mstahv/screwcloud/README.md

ScrewCloud

# ScrewCloud

**OSS web app to monitor temperature sensors like Ruuvi Tags and other custom sensors.**

A screw driven into a cloud: self-hosted temperature monitoring where the
readings go to your own server rather than into somebody else's cloud.

## What you can do with it

**The cheapest useful build is one board.** A Pico 2 W and a USB charger, with
nothing wired to it at all, reporting its own die temperature — which is exactly
what `pico-sleeper` exists to find out about. Add a RuuviTag and it becomes a
proper sensor; add a DHT22, an OLED, both or neither, and the same sketch covers
every combination, because the optional parts are detected at runtime rather than
configured.

**It goes where WiFi does not.** `temperature-reader` speaks WiFi *or* NB-IoT and
picks whichever answers at boot, so a reader can sit at a summer cottage, in a
garage or on a field with a 4G IoT SIM and no network of its own — sixteen bytes
every five minutes, which is what makes a metered connection affordable. Where
there is no cellular either, a node can shout over LoRa to a Raspberry Pi that
relays it onward.

**It does part of a Ruuvi Gateway's job, on your terms.** Hear the tags, forward
the readings — but the server is yours, the wire format is eight bytes of header
and eight per sensor and it is written down here, and everything between the tag
and the browser is in this repository under the AGPL.

**You change it in the Arduino IDE.** The firmwares are ordinary sketches: copy
`config.h.example`, edit three lines, press upload. No toolchain to install and no
build system to learn. The code is commented throughout for somebody who means to
alter it rather than admire it — including the parts that took two attempts, and
why the first one was wrong.

**You do not need a server to start.** A public one runs at `r.pakast.in` and the
sketches point at it out of the box, so the first reading arrives before you have
decided whether you like any of this. It is free, unauthenticated and offered
exactly as it is — see [Demo server](#demo-server) — and your own is a Spring Boot
jar and a PostgreSQL for when you want one.

## The pieces

Four readers, all speaking the same protocol to the same server:

- **`temperature-reader`** for the Raspberry Pi Pico 2 W — the full version:
  RuuviTags and Ruuvi Airs over BLE, an optional wired DHT22, an optional OLED,
  and WiFi or NB-IoT for connectivity.
- **`esp32-reader`** for the ESP32-S3 and the ESP32-C3 — the same Ruuvi side, RuuviTags and
  Ruuvi Airs over BLE, and WiFi; nothing wired to the board. It can be built and
  flashed from the server's firmware page without installing anything.
- **`pi-reader`** for a Raspberry Pi that is already there doing something else —
  the same job in Java, with a page of its own on the local network that keeps
  showing the temperature when the internet does not. It also reads a Nordic
  Thingy:52 and relays LoRa packets from nodes too far away for WiFi, so a device
  out of range still arrives at the server as itself.
- **`pico-sleeper`** — an experiment: a bare Pico 2 W reporting nothing but its
  own die temperature, asleep between readings. If the chip is cold enough to
  stand in for the room, the cheapest sensor in this repository has nothing wired
  to it at all.

The server is a Spring Boot + Vaadin application that stores the measurements and
shows them in a browser.

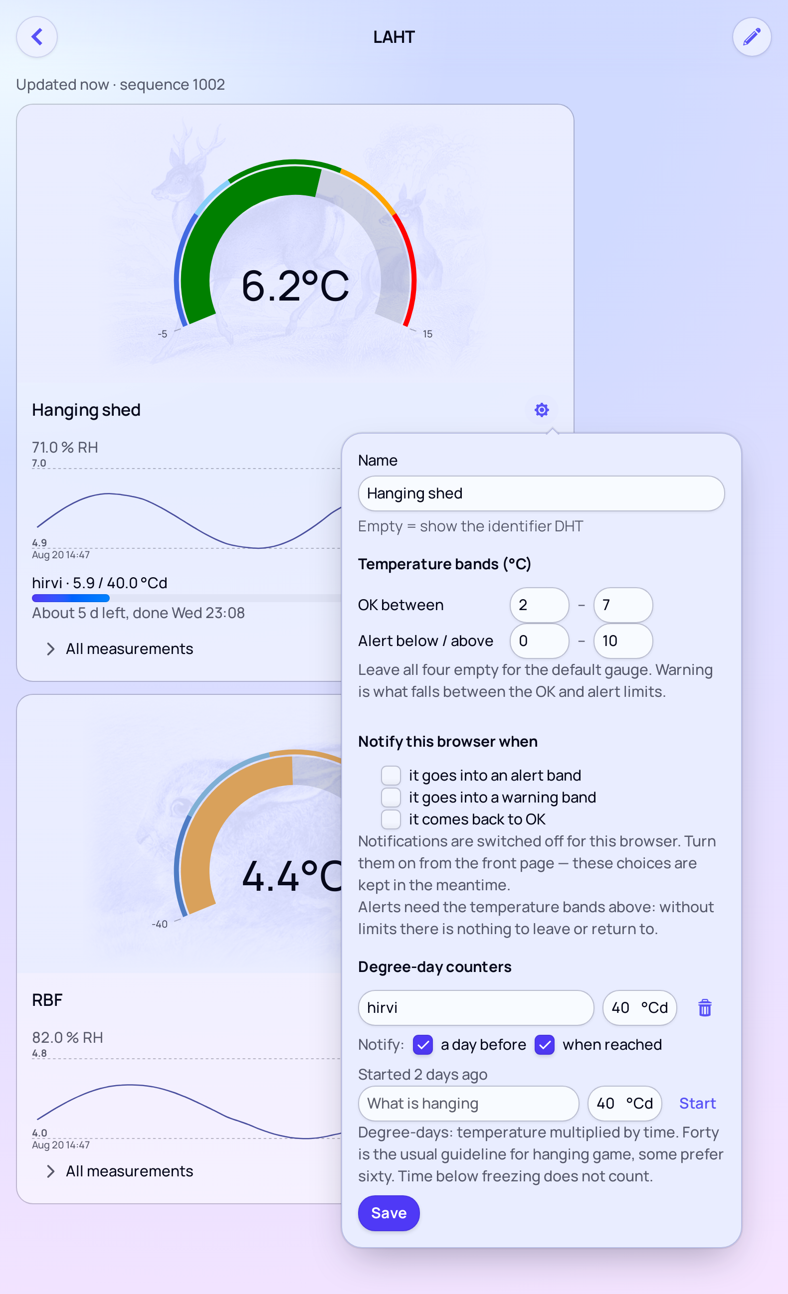
[picture p1: screenshot.png]
A device's sensor cards with one sensor's settings open, showing temperature bands on the gauge and a degree-day counter


Each sensor gets a card with a gauge, the last 24 hours as a curve, and under it
a small table of the readings the sensor has besides the temperature: the
humidity and pressure, a Ruuvi Air's CO₂, PM2.5, VOC and NOx indexes and light —
everything Ruuvi's own app lists for it — and a RuuviTag's battery, drawn as a battery,
with the bar as long as the charge and red under twenty per cent, beside the
voltage and a rough guess at what is left (see
[The battery guess](#the-battery-guess)). Each row ends in a small chart icon
that lays that reading over the temperature curve in its own colour — stretched
to the temperature's scale, so the shape shows and the numbers stay in the
table. Every reading is behind a
collapsed section further down. The settings open from the cog: a name,
temperature bands that colour the gauge, which of that sensor's alerts this browser
wants as push notifications, and the degree-day counters — the one above reads
`hirvi · 11.0 / 40.0 °Cd` with the forecast underneath.

**On an iPhone**, notifications need the site added to the Home Screen first, and
Apple has hidden that well. There is an illustrated walk-through of the whole
path, from Safari to a phone that buzzes before the meat is over-hung:
[Getting a notification on an iPhone](docs/iphone-notifications.md). Android
users can skim it; the in-app half applies to them as it stands.

## Quick start (Pico 2 W)

Minimum hardware: a **Raspberry Pi Pico 2 W** and a **RuuviTag**. No DHT22, no
display, no NB-IoT modem — those are all optional and detected at runtime.

For an ESP32-S3 or ESP32-C3 instead, see [esp32-reader](#esp32-reader).

1. **Install the Arduino core.** Boards Manager → *Raspberry Pi Pico/RP2040/RP2350*
   by Earle Philhower. Select the board *Raspberry Pi Pico 2 W*.

2. **Set Tools → IP/Bluetooth Stack → `IPv4 + Bluetooth`.** Mandatory: BLE is
   needed to hear the RuuviTag and WiFi to send. Without it the sketch will not
   even compile.

3. **Install the libraries** from Library Manager. Only the DHT ones can be
   skipped, and only if you comment out `ENABLE_DHT22`:

   | Library | Needed for |
   |---|---|
   | `Adafruit SH110X` + `Adafruit GFX Library` | the optional OLED |
   | `DHT sensor library` + `Adafruit Unified Sensor` | the optional DHT22 |

4. **Create your configuration** from the template and edit the copy:

   ```bash
   cd temperature-reader
   cp config.h.example config.h
   ```

   `config.h` is git-ignored because it holds your WiFi password. For the
   minimum setup only three lines need changing:

   ```c
   static const char DEVICE_ID[5] = "ABCD";        // any 4 characters, your own
   static const char WIFI_SSID[] = "your-network";
   static const char WIFI_PASSWORD[] = "your-password";
   ```

   Leave `SERVER_HOST` alone to use the public demo server.

5. **Flash it and open the serial monitor** at 115200 baud. Within a minute you
   should see something like:

   ```
   No NB-IoT modem found, falling back to WiFi
   Transport: WiFi
   DHT22: not connected
   RuuviTag cold room / F3:19:1A:C0:8E:BF  RSSI -41 dBm  (280 ms ago)
   Send ok: 1 sensors, 16 bytes, sequence 1
   ```

6. **Open the server**, enter your `DEVICE_ID` and press Add. The first packet
   arrives 30 s after boot, then every 5 minutes.

The onboard LED tells you the state from across the room: two short flashes and
a long pause means the last send succeeded, fast steady pulsing means it failed.

Setting one up for somebody who does not want any of this on their computer is a
different job, and a short one: see
[Handing a built firmware to somebody else](#handing-a-built-firmware-to-somebody-else).

### Demo server

The default `SERVER_HOST` points at the public demo server **r.pakast.in**
(77.42.75.251, UDP 5555). You are welcome to use it for trying things out.

**It comes with no guarantees.** It may be down, and the database may be wiped
at any time without warning. There is no authentication either: anyone who knows
your `DEVICE_ID` can see your readings, and anyone can send readings claiming to
be your device. For anything you care about, run your own server — a Spring Boot
jar and a PostgreSQL, see [Server](#server).

### What is optional and how

| Part | Behaviour when absent |
|---|---|
| DHT22 | Detected at runtime. After `DHT_FAILURES_BEFORE_ABSENT` failed reads it is declared absent, stops being read, and is left out of the display and the packet. Its display row goes to the tags instead. |
| OLED display | Nothing to detect — 4-wire SPI has no read-back, so the sketch cannot tell whether a display is attached and simply draws into the void. Nothing fails either way. |
| NB-IoT modem | Probed with an AT command at boot (`TRANSPORT_AUTO`). If it does not answer, WiFi is used. |
| RuuviTags | Any number from zero upwards. With no readings at all the sketch skips sending rather than transmitting an empty packet. |
| Chip temperature | Always available — it is on the die, there is nothing to detect or wire. Comment out `ENABLE_INTERNAL_TEMPERATURE` to leave it out of the packet. |

A sensor is only declared absent while it has **never** produced a reading. One
that has worked keeps being retried forever, because then the problem is
interference rather than absent hardware.

`TRANSPORT_AUTO` compiles both transports in and costs a couple of seconds of
boot time when no modem is present. `TRANSPORT_WIFI` or `TRANSPORT_NBIOT` fix
the choice and avoid both.

## Repository layout

| Directory | Description |
|---|---|
| `temperature-reader/` | Full firmware for the Raspberry Pi Pico 2 W: RuuviTags, DHT22, OLED, WiFi or NB-IoT |
| `esp32-reader/` | Firmware for the ESP32-S3 and ESP32-C3: RuuviTags, Ruuvi Airs and WiFi, nothing wired to the board |
| [`pi-reader/`](pi-reader/) | The same reader in Java on a Raspberry Pi: Quarkus, Vaadin, BlueZ — RuuviTags and a Nordic Thingy:52, plus a local page for when the server is unreachable and a LoRa relay for nodes out of WiFi range |
| `pico-sleeper/` | An experiment: a bare Pico 2 W sending only its own die temperature, asleep in between, over WiFi or LoRa |
| `lora-node/` | A Pico with a Core1121, transmitting so the LoRa receiver at the other end can be tested |
| `server/` | Spring Boot + Vaadin: receives the UDP packets and shows the latest readings |
| `tools/` | `generate-vapid-keys.java`, which generates a key pair for web push |

All of them speak the same protocol to the same server, so one server can collect
from a mix of Pico, ESP32 and Pi devices. Keeping three implementations of
one wire format honest is what `ProtocolSyncTest` is for — there is one in the
server, comparing the two sketches against each other, and one in `pi-reader`,
comparing its constants against the firmware header.

## Hardware

| Part | Required | Role |
|---|---|---|
| Raspberry Pi Pico 2 W(H) (RP2350 + CYW43439) | **yes** | The main board. WH = pre-soldered headers |
| RuuviTag (0..n) | no | Temperature, humidity, air pressure, wirelessly as BLE advertisements |
| Waveshare DHT22 (AM2302) module | no | Temperature + humidity, wired. Detected at runtime |
| Waveshare 1.3" OLED (B) | no | SH1106, 128×64. Readings legible on the spot |
| Waveshare SIM7028 NB-IoT HAT | no | Connectivity without WiFi. Detected at runtime |
| RP2350 internal sensor | — | The chip's own die temperature, reported as sensor `CPU`. Measures the chip heating up rather than the room |

The minimum setup is a bare Pico 2 W and one RuuviTag; see
[Quick start](#quick-start-pico-2-w).

Alternatively an **ESP32-S3** or **ESP32-C3** board (developed against the
Waveshare ESP32-S3-Zero and ESP32-C3-Zero) with the `esp32-reader` firmware.
That variant hears the same Ruuvi devices and sends over WiFi, and has nothing
wired to it — see [esp32-reader](#esp32-reader). The C3 is the cheaper of the
two and does the same job.

## Wiring

### DHT22

The module used here is the Waveshare DHT22, which comes with a three-wire
cable. **No separate pull-up resistor is needed** — the module already carries a
pull-up on the DATA line plus a decoupling capacitor. A bare 4-pin DHT22
component would need a 10 kΩ resistor between DATA and VCC.

The module runs on 3.3–5.5 V. Feed it from 3.3 V, because the Pico's GPIOs
**do not tolerate 5 V** — with a 3V3 supply the data line is directly compatible
and no level shifter is needed.

| Wire colour | Module pin | Pico 2 W | Physical pin |
|---|---|---|---|
| Red | VCC | 3V3(OUT) | 36 |
| Yellow | DOUT / DATA | GP15 | 20 |
| Black | GND | GND | 18 |

Check the colours against the module's silkscreen before wiring — the cable
order can vary between batches, and swapping red and black destroys the sensor.

GND is taken from physical pin 18, next to GP15. Pin 38 works equally well if it
suits being next to 3V3 (pin 36) better.

### OLED display

[Waveshare 1.3inch OLED (B)](https://www.waveshare.com/wiki/1.3inch_OLED_(B)),
controller SH1106, 128×64 pixels.

**The module ships in 4-wire SPI mode and is used as is.** The same module can
do I2C, but that would require resoldering the BS0/BS1 resistors on the back
(I2C: BS0=0, BS1=1). Not worth it — SPI is faster and takes nothing needed.

DIN and CLK go to the SPI0 default pins, so the `SPI` object works without any
pin configuration. CS, DC and RST are freely choosable and were taken from
adjacent pins so the whole display connects to one contiguous cluster (physical
pins 22–27).

| OLED | Function | Pico 2 W | Physical pin |
|---|---|---|---|
| VCC | Supply (3.3 V / 5 V) | 3V3(OUT) | 36 |
| GND | Ground | GND | 23 |
| NC | Not connected | – | – |
| DIN | SPI MOSI | GP19 | 25 |
| CLK | SPI SCK | GP18 | 24 |
| CS | Chip select | GP17 | 22 |
| DC | Data/Command | GP20 | 26 |
| RST | Reset | GP21 | 27 |

#### VCC is 3.3 V — not VBUS

Waveshare lists the spec as "3.3V/5V", but **the module's own schematic
contradicts that.** There is no regulator and no level shifter on the board: the
components are just the panel, six capacitors, a 1 MΩ IREF resistor, a 0 Ω
bridge and the headers. The schematic's VCC net goes straight to the panel's
supply pins.

The SH1106's absolute maximum ratings are VDD1 (logic) −0.3…+3.6 V and VDD2
(DC-DC) −0.3…+4.3 V. VBUS's 5 V would exceed both. On top of that VIH is
0.8 × VDD1, so with a 5 V supply the threshold would be 4.0 V and the Pico's
3.3 V would not register as a logic one.

Exception: if your board happens to have an LDO in a SOT-23 package (typically
marked `662K`) near the VCC pin, it is a different revision and 5 V is fine.
Check visually before cutting that corner.

The display and the DHT22 share the same 3V3 output (pin 36) through a
breadboard power rail. Current is not a constraint: the OLED draws about 20 mA
and the DHT22 1.5 mA.

The display deliberately shows only the room's temperatures and humidities. The
chip's own temperature and the diagnostics (RSSI, battery voltage, error counters)
go to the serial console — and in the chip's case to the server as well, where it
can be followed over time. There are three rows, and none of them should go to a
number that says nothing about the room.

#### The chip's own temperature

The RP2350 has a temperature sensor on the die, read with `analogReadTemp()`. It
is reported to the server as sensor **`CPU`**, and shown in the device's status
line — `Updated 4 min ago · sequence 2 · CPU 42.7 °C` — rather than on a card.

A card gave it the standing of a measuring point somebody chose: a heading, a 24
hour sparkline, threshold settings and alert subscriptions, none of which anyone
wants for a chip. The status line is where the rest of the device's own state
already is. Every reading is still stored, so the history is there if it is ever
wanted.

A device that overrides `INTERNAL_SENSOR_ID` gets an ordinary card again. The
packet carries nothing that distinguishes the chip from a thermometer, so the
identifier is all there is to go on.

**Unless it is all the device has.** A board that measures nothing but its own die
— see [pico-sleeper](#pico-sleeper) — gets an ordinary card for it, counts as one
sensor rather than none, and does not have the same number repeated on the status
line above it. Hiding it there would leave a status line and an empty page.

**It is not a room thermometer.** The sensor sits on the same silicon as the CPU
and the radio, so it reads well above the air around it — typically 10–20 °C
above, more when the modem is transmitting — and it moves with the load rather
than with the weather. What it is good for is the shape of the curve: how much the
chip heats up under load, and how well the enclosure sheds it.

It carries no humidity, which the UI shows as a dash rather than 0 %.

Costs 8 bytes per packet. Comment out `ENABLE_INTERNAL_TEMPERATURE` in `config.h`
to leave it out, and `INTERNAL_SENSOR_ID` renames it if `CPU` is not what you
want to see. It cannot collide with a tag: a tag's identifier is always `R` and
three hex digits.

### Why GP15

- GP23, GP24, GP25 and GP29 are used internally by the CYW43 wireless chip and
  are not on the header at all — they cannot be used
- GP4/GP5 (I2C0) and GP0/GP1 (UART0) are left free for future additions. I2C0 is
  reserved for something like a TMP117 reference sensor (see below)
- GP26, GP27 and GP28 are the only ADC pins, so they are not wasted on digital
  use
- GP15 has no default peripheral function, and physical pin 18 next to it is GND

## Software

### Arduino IDE settings

| Setting | Value |
|---|---|
| Board | Raspberry Pi Pico 2 W (arduino-pico, Earle Philhower) |
| **Tools → IP/Bluetooth Stack** | **IPv4 + Bluetooth** |

The IP/Bluetooth Stack choice is mandatory — with the default value the BTstack
library is not found and compilation fails. The same choice keeps WiFi available
for reporting; the CYW43 chip handles both radios.

### Libraries

| Library | From |
|---|---|
| `BTstackLib` | Comes with the arduino-pico core, no separate install |
| `DHT sensor library` | Adafruit, Library Manager |
| `Adafruit Unified Sensor` | Adafruit, dependency of the above |
| `Adafruit SH110X` | Adafruit, Library Manager. SH1106 controller |
| `Adafruit GFX Library` | Adafruit, dependency of the above |

### Configuration

`temperature-reader/config.h` is **git-ignored** because it holds the WiFi
password. `config.h.example` is the tracked template; copy it and edit the copy:

```bash
cp temperature-reader/config.h.example temperature-reader/config.h
```

Keep placeholders in the template and real values only in your own copy. If
`config.h` was tracked at some earlier point, untrack it with
`git rm --cached temperature-reader/config.h`.

### Handing a built firmware to somebody else

A Pico takes firmware by drag and drop. Hold its **BOOTSEL** button while
plugging in the USB cable and it appears as an ordinary USB drive; copy a `.uf2`
file onto that drive and it flashes itself and restarts. No IDE, no drivers, no
command line, nothing installed. So the person receiving a device never needs a
toolchain — they need one file and two sentences.

An ESP32 has no such drive; it takes firmware over its serial port. The
server's [firmware build page](#the-firmware-build-page) does that from the
browser, which is the way to hand one over. By hand it is the merged image the
`arduino-cli` compile below leaves as `*.merged.bin`, written with
`esptool.py --chip esp32s3 write_flash 0x0 <file>` — or `--chip esp32c3` for
that board.

What they do not get is a way to type in their own WiFi password. The settings
are compiled in, which means **one build per recipient**. Why that is, and what
it would take to change, is at the end of this section.

#### Building the file

Edit `config.h` first, and change two things, not one:

| | |
|---|---|
| `WIFI_SSID`, `WIFI_PASSWORD` | the recipient's network |
| `DEVICE_ID` | **must be unique.** Four characters, and it is what the server files the readings under — two devices sharing one id file as one device and overwrite each other's history |

Then, in the Arduino IDE, with the board settings from above: **Sketch → Export
Compiled Binary**. The `.uf2` lands in a `build/` folder beside the sketch.

Or from the command line, which is easier to repeat for a second recipient:

```bash
# once, if arduino-cli has never seen this core
arduino-cli core install rp2040:rp2040 \
  --additional-urls https://github.com/earlephilhower/arduino-pico/releases/download/global/package_rp2040_index.json
arduino-cli lib install "DHT sensor library" "Adafruit Unified Sensor" \
  "Adafruit SH110X" "Adafruit GFX Library"

# per build
arduino-cli compile \
  --fqbn rp2040:rp2040:rpipico2w:ipbtstack=ipv4btcble \
  --export-binaries \
  temperature-reader
```

`ipbtstack=ipv4btcble` is the command-line spelling of **Tools → IP/Bluetooth
Stack → IPv4 + Bluetooth**, and it is not optional: without it BTstack is not
found and the compile fails. If that string ever stops matching, ask the core
itself rather than guessing:

```bash
arduino-cli board details --fqbn rp2040:rp2040:rpipico2w
```

The compile prints the path of the `.uf2` it wrote when it finishes. That single
file is what you send. It is a few hundred kilobytes and goes through email.

> **It contains their WiFi password in clear text**, because it contains
> `config.h`. That is their own secret going back to them, so it is not a
> disaster, but it does mean a build belongs to one recipient and must not be
> forwarded to the next one — who would also inherit the wrong `DEVICE_ID`.

#### What to send with it

Everything below is written to be pasted into a message as it stands.

> 1. Take the USB cable out of the device, if it is plugged in.
> 2. Find the single small button on the Pico board — the one marked
>    **BOOTSEL**. Press and hold it.
> 3. While still holding it, plug the USB cable into your computer.
> 4. Let go of the button. A drive called **RP2350** appears, like a memory
>    stick.
> 5. Copy the file I sent you onto that drive.
> 6. The drive disappears by itself after a second or two and the device starts
>    up. On a Mac you may get a warning that a disk was not ejected properly —
>    that is normal here, and nothing is wrong.
>
> The display comes on right away. The bottom row says `Not sent yet` at first,
> and should change to `Sent ok` within a minute or so.

#### When it does not work

| What happens | What it means |
|---|---|
| No drive appears | The button was not held, or was let go too early. Unplug and start again. A charge-only USB cable also does this — try another cable |
| The drive appears but stays after copying | The file was built for the wrong chip. `RP2350` is a Pico 2; a plain Pico wants a different build |
| Drive appears, display stays dark | The firmware is fine and something else is wrong — see the link status codes |

#### Why the settings are not in a separate file

The obvious idea is one binary for everyone plus a small text file the recipient
edits — same drive, same drag and drop. It does not work, for a specific reason
worth recording so nobody spends an evening rediscovering it.

The drive a Pico shows in BOOTSEL mode is the bootloader's, and it only accepts
`.uf2` images; it is not a filesystem you can put a text file on. A running
sketch can present a drive of its own through the core's
[SingleFileDrive](https://arduino-pico.readthedocs.io/en/latest/singlefile.html)
library, but its documentation is explicit that the emulation "only allows for
the reading of the single file, and deleting it" — the PC cannot write to it.
It is a way to get a log file *out*, not a way to get settings *in*.

Shipping a prepared LittleFS image alongside the sketch would work technically
and gains nothing: the image would still have to be built per recipient, which
is the very work it was meant to avoid.

The real answer, when it is worth the effort, is provisioning over WiFi: the
device brings up its own access point when it has no credentials, the recipient
connects a phone to it and types their network and password into a small web
page, and it is written to LittleFS and used from then on. The hardware is
willing — the Pico 2 W does AP mode, and this device has a display to put the
network name and the progress on. It is a project rather than an afternoon,
which is why the firmware currently compiles the settings in.

## temperature-reader

Prints the readings from every source to the serial console every 5 seconds
(115200 baud) and refreshes the OLED at the same time.

### Link status indication

The result of the most recent send is visible on both the LED and the display.
Both read the same `LinkState` structure, so they cannot tell different stories.

| State | LED rhythm | Display bottom row |
|---|---|---|
| Send succeeded | two short flashes, long dark pause | `Sent ok, 45 s` |
| Send failed, has worked before | fast steady pulsing | `NO NET s2 q99 12 min` |
| Send failed, never worked | fast steady pulsing | `NO SIM up 12 min` |
| Nothing sent yet | calm steady blinking | `Not sent yet` |

The rhythms were chosen to be told apart at a glance without counting durations.

On failure the row is the reason and then an age. The reason comes first because
it is what decides what to do about it; the codes are listed under [When a send
fails](#when-a-send-fails). The age is two different measurements depending on
what there is to measure: after a link that once worked it is the time since the
last **successful** send, which says more than the time of the failed attempt,
and with nothing to count from it is the time since boot, marked `up` so the two
are not mistaken for each other.

The row holds 21 characters and the buffer it is composed in is exactly that
size, so a long reason keeps its front and loses its tail rather than wrapping
onto a line that would be drawn off the bottom edge.

Even a failing `transport->begin()` is flagged as an error, so for instance a
wrong WiFi password shows up right at boot rather than only after the first send
attempt.

### Display layout

The display is meant to be read from across the room, so the font is as large as
possible. Three rows:

```
cold room     24.9
R2            -3.2
DHT           25.6
Sent ok, 45 s
```

The Adafruit_GFX font is 6×8 px at text size 1, so size 2 is 12×16 px. Only
**10 characters** fit per row in the large font, which is not enough for a name
and a reading at once — so the temperature is drawn at size 2, right aligned,
and the name at size 1 on the left, vertically centred against it. The
temperature is the number you look at from across a room; a name is something
you walk up to and read.

The row height is 20 px, so three rows take 60 pixels and the bottom 8 pixels
are left for the link status row in the small font.

The name gets whatever the reading leaves, measured against the reading actually
being drawn rather than a fixed column — `24.9` leaves room for 14 characters
and `-12.3` for 10. A longer name is truncated, because a name running into the
reading is worse than a name that stops early.

Humidity is not on the display. Three numbers per row was more than a 128 pixel
display could show legibly, and humidity is the one nobody squints at from the
doorway — it is on the dashboard, along with pressure and battery voltage.
A temperature a sensor does not provide shows as dashes.

There are three rows and there can be more sensors than that, so the order
decides who is left out: **tags that are still reporting first, then the DHT22,
and tags that have gone quiet last of all.** The tags are the measuring points
somebody deliberately placed; the DHT22 is wherever the box happens to sit. And
a tag that stopped sending an hour ago must never push a still-reporting sensor
off the screen, which is why it sorts below even the DHT22 — its reading is
worth showing, but only with the space left over.

Nothing is lost by not being drawn: the registry keeps every tag it has heard,
the packet carries them all, and the serial console prints them all.

### RuuviTag

RuuviTag's [Data Format 5 (RAWv2)](https://docs.ruuvi.com/communication/bluetooth-advertisements/data-format-5-rawv2)
is a broadcast format: the entire measurement payload sits in the
manufacturer-specific field of the BLE advertisement (AD type `0xFF`, company ID
`0x0499`). No connection is needed, scanning is enough.

The payload is 24 bytes big endian: temperature `int16 × 0.005 °C`, humidity
`uint16 × 0.0025 %`, air pressure `uint16 + 50000 Pa`, three acceleration axes,
an 11+5 bit battery voltage / TX power field, a movement counter, a sequence
number and the MAC. Every field has its own "invalid" value, which the code
turns into `NaN`.

The scan parameters are set by hand:

```cpp
gap_set_scan_params(0 /* passive */, 0x0030, 0x0030, 0);
```

BTstack defaults to a 30 ms window every 300 ms, a 10 % duty cycle. Since a
RuuviTag in RAWv2 mode only transmits every ~1285 ms, the defaults would miss
most advertisements.

#### Several tags

`RuuviRegistry` tracks every tag heard, keyed by the MAC address inside the
advertisement. The array is fixed size (`MAX_RUUVI_TAGS`, default 8), because
dynamic allocation in a long-running sketch is a needless risk. If there are
more tags than slots the extras are ignored and that shows up as a counter in
the output — no silent data loss.

A tag's reading is marked `[STALE]` in the output if nothing has been heard from
it for a minute (`RUUVI_STALE_MS`). A tag transmits every ~1285 ms, so anything
older effectively means the tag is out of range or its battery is dead.

Tags can be named in the `RUUVI_NAMES` table so measuring points are
distinguishable on the display and in the log. A name is a display matter only
and goes nowhere near the server, so it can be changed at will — see
[Identifiers](#identifiers) below. Naming is optional: an unnamed tag is shown
as `R1`, `R2`, … numbered in the order the device first heard them, and by its
MAC address on the serial console. A new tag's MAC comes straight from the
serial output.

The running number belongs to the tag's slot in the registry, not to its row on
the screen, so `R2` stays `R2` when the tag above it goes quiet and drops down
the display. It can change across a reboot, if the tags are heard in a different
order — the proper name for a measuring point lives in the web interface, which
is keyed by the identifier below and unaffected.

#### On accuracy

The BME280 in a basic RuuviTag is ±1.0 °C on temperature. If some measuring
point needs accuracy, the **RuuviTag Pro** uses TI's TMP117, whose absolute
accuracy is ±0.1 °C between −20 and +50 °C. The Pro sends the same Data Format
5, so no code changes are needed — the 2in1 model's missing humidity and
pressure fields arrive as `0xFFFF` invalid values, which the parser turns into
`NaN`.

### The Arduino IDE's prototype generation

The Arduino IDE generates prototypes for the functions in a `.ino` file
automatically and places them after the `#include` lines — that is, **before**
the sketch's own type definitions. A file scope function taking a
sketch-declared type as a parameter therefore fails with:

```
error: 'RuuviMeasurement' has not been declared
```

The error points at the function definition line even though the fault is in the
generated prototype. The workaround: make it a **member function** — those get
no generated prototype. That is why the Data Format 5 parser is
`RuuviMeasurement::parseFormat5` rather than a free function.

The same applies to future additions: if you need a free function handling the
`RuuviMeasurement` or `DhtSensor` type, move the types into their own `.h` file
or make the function a member.

### Timing notes

`loop()` is deliberately non-blocking. `BTstack.loop()` has to run often, so
timing is done with `millis()` comparisons rather than `delay()`.

Adafruit's DHT library bit-bangs the protocol and keeps interrupts disabled for a
couple of milliseconds per read. The sensor is therefore only read when printing.
If read failures (the `failures` counter) start piling up, the DHT read can be
moved to the other core with `setup1()`/`loop1()` — disabling interrupts is
per-core on the RP2350, so core 0's BTstack is then undisturbed.

## esp32-reader

The Pico firmware with the hardware taken out: **RuuviTags and Ruuvi Airs over
BLE, the chip's own temperature, and WiFi.** No DHT22, no display, no NB-IoT —
and no way to add them, on purpose. Everything that is not about wiring is the
same as on the Pico: the wire format, the Ruuvi decoding, the identifier a tag
gets, the failure reasons, the restart after a link has been down for six sends
and the hardware watchdog behind that. Developed against the Waveshare
ESP32-S3-Zero and ESP32-C3-Zero.

One sketch for both chips. The S3 is a dual-core Xtensa and the C3 a single-core
RISC-V, and the sketch cannot tell: the Arduino core, NimBLE, WiFi, the watchdog
and the RGB LED call are the same on both. The one line that differs is the LED's
pin — GPIO21 on the S3-Zero, GPIO10 on the C3-Zero — and `config.h` picks it by
the target the compiler is building for, so there is one template rather than
two. The C3 is the cheaper board and does the same job.

The easiest way to get one is not to build it at all: the server's
[firmware build page](#the-firmware-build-page) compiles it for your network and
writes it onto the board from the browser. What follows is for doing it by hand.

### Quick start (ESP32-S3 or ESP32-C3)

1. **Install the ESP32 Arduino core** (3.x) from Boards Manager and select
   *ESP32S3 Dev Module* or *ESP32C3 Dev Module*, whichever you have. Set **USB
   CDC On Boot: Enabled** — the Zero boards have no separate USB-UART chip, and
   without this the serial monitor stays silent —
   and **Partition Scheme: Huge APP**, because BLE and WiFi together do not fit
   the default application partition with anything to spare.
2. **Install `NimBLE-Arduino`** (2.x) from Library Manager. Nothing else — WiFi,
   `neopixelWrite()` and `temperatureRead()` come with the core.
3. **Create your configuration:**
   ```bash
   cd esp32-reader
   cp config.h.example config.h
   ```
   Change `DEVICE_ID`, `WIFI_SSID` and `WIFI_PASSWORD`.
4. **Flash and open the serial monitor** at 115200 baud. Within a minute you
   should see the tags it hears, a line per device, and `Send ok`.

The RGB LED shows the state by colour, in the Pico's three rhythms: **green** two
short flashes = the last send succeeded, **red** fast pulsing = it failed,
**blue** slow blinking = nothing sent yet. On a failure the serial log says why
in the Pico's words — `NO WIFI`, `NO HOST`, `NO SEND` — so a reader who knows one
board knows the other.

A Ruuvi Air's CO₂ and PM2.5 travel to the server alongside its temperature and
humidity, exactly as from the Pico, and the chip temperature is sent as sensor
`CPU` unless `ENABLE_INTERNAL_TEMPERATURE` is commented out in `config.h`.

### Power, and why it works in cycles

The first version scanned for advertisements without pause, held its WiFi
association and ran the CPU at 240 MHz, and the board ran hot enough to notice.
None of that is needed by a device that reports every five minutes, so the
firmware now works in cycles:

| Phase | Radios | How long |
|---|---|---|
| listening | BLE scan on, WiFi off | `LISTEN_MS`, 20 s by default |
| send | scan stopped, WiFi up for the packet and then off | a few seconds |
| resting | both off | the rest of `SEND_INTERVAL_MS`, or `RETRY_INTERVAL_MS` after a failure |

A RuuviTag advertises every ~1.3 s, so twenty seconds hears every device in
range many times over, and at a five minute interval the receiver is on seven
per cent of the time instead of all of it. The CPU runs at 80 MHz, the minimum
the radios accept and more than the work needs. The light and the serial console
work throughout, because the chip stays awake — it only has less to do.

`SLEEP_BETWEEN_SENDS` in `config.h` goes further and puts the chip into deep
sleep between cycles, woken by a timer into a fresh boot. It is off by default
because two things stop working while the chip sleeps: the light is dark between
cycles, and the USB console drops and reconnects each time, which makes watching
the log a chore. Enable it once the device is proven and put away — on the
firmware build page it is the "Sleep between sends" box. Only the sequence
number is carried across, in RTC memory, so the server does not read every
wake as a reboot.

It is deep sleep rather than light sleep after light sleep was tried and the
device reported once and never again. Espressif's sleep documentation explains
it: light sleep powers the radios down, and a BLE controller that was simply
left initialised is not brought back usable — that only works on the modem-sleep
and automatic-light-sleep path, which the Arduino core does not set up. The scan
restarted into nothing and WiFi stayed down. A reboot per cycle costs about a
second and recovers everything.

The light's own cost is small — a couple of milliamps on average at this
brightness, against twenty-odd for the chip awake at 80 MHz — but it is there,
and `STATUS_LED_WHILE_RESTING` in `config.h` is where to give it up: set to 0,
the light blinks only while listening and around the send, and is dark for
the minutes in between when it would be telling an empty room. With light sleep
on it is dark between cycles regardless.

The first packet leaves about `LISTEN_MS` after power-on, which is what the
earlier `FIRST_SEND_DELAY_MS` used to arrange; that constant is gone from the
template, and an old `config.h` that still has it compiles with a warning.

### What is shared, and why by copy

`Protocol.h` is **byte identical** in both sketches, and the Ruuvi Data Format 5
constants and scaling factors match. `ProtocolSyncTest` in the server module
verifies both, so it runs with the normal test suite rather than waiting to be
remembered:

```bash
cd server && mvn test -Dtest=ProtocolSyncTest
```

It reads the two sketches straight from the firmware directories — the server
module reaching outside itself, on the grounds that the repository is checked out
as a whole. No Spring context, so it costs under a tenth of a second.

The checks compare the two sketches against **each other** rather than against
expected values written into the test, so changing the protocol in both firmwares
needs no edit there, and reformatting a line is not a divergence. A failure names
both values:

```
humidity scaling differs between the two firmwares
  ==> expected: <rawHumidity * 0.0025f> but was: <rawHumidity * 0.025f>

Protocol.h has diverged at line 32.
  pico: static const uint8_t PROTOCOL_SENSOR_SIZE = 8;
  esp32: static const uint8_t PROTOCOL_SENSOR_SIZE = 9;
```

Beyond the named checks, every `static const` and `#define` the two sketches
happen to share is compared as well, so a constant added to both is covered
without anyone remembering to list it.

It is a copy rather than a shared file because the Arduino build does not
reliably resolve includes reaching outside a sketch folder — arduino-cli copies
the sketch directory into its build path, so a `../shared/Protocol.h` include can
break depending on the toolchain version. A checked copy is more robust than an
include that might silently stop working.

Both copies have been compiled natively against a stub `Arduino.h` and produce
identical packet bytes, which in turn match what the server's `PacketDecoder`
expects.

The ESP32 variant decodes fewer Ruuvi fields on purpose — no pressure,
acceleration or battery voltage, since it does not report them.

### What differs from the Pico version, and why

| Concern | Pico 2 W | ESP32-S3 / ESP32-C3 |
|---|---|---|
| BLE | BTstack, run loop pumped from `loop()` | NimBLE, own host task |
| Advertisement data | `BLEAdvertisement` copies a fixed 31 bytes and hides the real length, so AD structures are walked by hand | NimBLE gives the manufacturer field with its real length |
| Scan units | raw 0.625 ms units into `gap_set_scan_params` | milliseconds into `setInterval` / `setWindow` |
| Status LED | plain GPIO, rhythm only | WS2812 RGB, colour plus rhythm |
| Internal temperature | `analogReadTemp()`, sent as sensor `CPU` | `temperatureRead()`, sent as sensor `CPU` |
| Watchdog | `rp2040.wdt_*`, fed from the transport's wait loops | `esp_task_wdt_*`, fed from the WiFi connect wait |
| Restart when stuck | `rp2040.reboot()`, held back by a SIM waiting for its PIN | `ESP.restart()`, held back only by a boot too young |
| Radios | BLE scanning and the transport up throughout | in cycles: scan for a window, WiFi for the send, both off between — see Power |
| Shared state | none needed | mutex — see below |

**The one real structural difference is concurrency.** On the Pico, BTstack
callbacks run inside `BTstack.loop()` on the main thread, so the tag registry
needed no locking. On the ESP32, NimBLE delivers `onResult` from its own host
task, so every registry access is under a mutex and `loop()` works on a snapshot
rather than the live array. Getting this wrong would produce rare torn reads that
are very hard to reproduce.

Two consequences of NimBLE that are easy to get wrong:

1. **`setScanCallbacks(callbacks, wantDuplicates)` must pass `true`.** It sets the
   duplicate filter, and with the filter on each tag is reported only once —
   readings would never update after the first advertisement.
2. **`setMaxResults(0)`** stops NimBLE accumulating a device list. We only care
   about the callbacks, and a continuous scanner would otherwise grow a result
   set forever.

A pleasant simplification: `transportIdle()` disappears entirely. The ESP32 has
no run loop of ours to pump during a network wait, so the whole "BLE must not
stall while connecting" problem does not exist. `loop()` just calls `delay()` to
yield to the WiFi and BLE tasks. What the wait loop still has to do is feed the
watchdog, which is armed at eight seconds and would otherwise fire during a
twenty-second connect — the same arrangement as the Pico's, with one call where
the Pico has a function.

The Arduino core may already have the task watchdog running with a timeout of its
own, and refuses a second `esp_task_wdt_init`. `startWatchdog()` reconfigures it
in that case rather than giving up, so the outcome is the same either way: our
timeout, watching our loop.

**Neither firmware has been compiled in this environment** — no Arduino
toolchain here. The shared protocol code has been verified natively; the
board-specific plumbing has not.

## pico-sleeper

An experiment with one question behind it: **is the RP2350's own die temperature
close enough to the air around it to be worth reading?** If it is, the cheapest
sensor here is a bare Pico 2 W with nothing wired to it.

The cycle, every fifteen minutes and once at boot:

```
wake -> measure -> radio on -> send -> radio off -> sleep
```

**The order is the experiment.** The die is coldest the moment it wakes, and
everything after the measurement heats it — connecting to WiFi takes seconds and
is by far the largest part of a wake. Measuring first is what makes the reading
about the room rather than about the work. Reading it after sending would produce
a number that says how hard the board has just been working, which is what the
chip temperature normally tells you and exactly what is not wanted here.

It sends one sensor called `CPU`, so the server shows it on the device's status
line rather than as a measuring point — and counts it as one sensor rather than
none, because on this device it is all there is.

### A packet that was "sent" and never arrived

`endPacket()` returning success means the datagram was handed to the network
stack, not that it has left the antenna. A first packet on a fresh connection
usually waits for an ARP reply before it can go anywhere — and this device
powers the radio down immediately afterwards, which throws the packet away
while it is still in the queue.

That is what "sent" in the serial log with nothing at the server looks like, and
it is why the radio now stays on for `WIFI_LINGER_MS` after the hand-over. UDP
offers no acknowledgement to wait for, so waiting a moment is the honest remedy;
it costs a fraction of the seconds the connection itself took.

### Sleep

Since **pico-sdk 2.3.0** the SDK carries a library for this — `pico_low_power`,
with official examples and, better, measured numbers. arduino-pico bundles that
SDK from 5.7.0 onwards, so it is available in an ordinary Arduino build. Raspberry
Pi's own figures for a Pico 2 running from 3V3:

| Mode | Current | Wakes on | Costs |
|---|---|---|---|
| `delay()` | — (every clock still running) | timer | nothing |
| sleep | 6.9 mA | timer or any interrupt | nothing: it returns where it was called |
| dormant | 3.7 mA | AON timer or a GPIO | the crystal stops, so USB and the serial log go with it |
| Pstate, SRAM0 on | 0.14 mA | AON timer or a GPIO | **the program restarts on waking** |
| Pstate, all SRAM off | 0.08 mA | AON timer or a GPIO | as above, and less retained |

This sketch uses **sleep**, the lightest of the three, because it is the only one
that leaves the program running: `low_power_sleep_for_ms()` returns where it was
called, so the loop stays the ordinary loop it looks like. It stops the processor
and most clocks, which is a long way below waiting in `delay()` — that halts the
core on a `WFE` but leaves every clock and PLL running.

Pstate is the real prize and suits this device better than it sounds: a wake here
is already "run once from the top". What it needs is the sequence number moved
into a POWMAN scratch register to survive the restart, and it takes the serial
connection with it — which is the instrument this experiment is being run with, so
it is a step to take once the questions about the temperature have been answered.

**One thing to know before the first build.** arduino-pico 6.0.0 ships the
compiled `pico_low_power` library, but its linker script does not define the two
symbols that library expects around a persistent data section — that section is
created by an SDK CMake function, and an Arduino build has no CMake. The link
fails with `undefined reference to __persistent_data_start__`. `Sleep.h` defines
them itself, one byte and an alias to it, which is the "no persistent data" case
the library already handles; the reasoning is written out there. Setting
`SLEEP_USE_SDK_LOW_POWER` to 0 backs out of the whole thing.

**One caveat before anyone plans a battery.** Those numbers are for a Pico 2, not
a Pico 2 **W**. The CYW43 radio is powered separately and does not appear in them
at all. On this board it may well be the largest consumer between readings, and if
it is, the difference between 6.9 mA and 0.14 mA of processor is not the
difference it looks like. That wants a meter, not an argument.

The sketch prints how long each wake took and which sleep it is using. A wake of a
few seconds every fifteen minutes is a duty cycle under one percent, and at that
point the current drawn while asleep is what the battery life is made of.

**And it prints the self-heating**: the die temperature is read again at the end
of each wake, and the difference from the reading that was sent says how much the
board warmed itself doing the work. That number is the instrument for the whole
experiment. The first measurement of it was **+2.87 °C across a 7.2 second wake**,
which is the size of the error the measure-first ordering avoids.

### ARM or RISC-V

The RP2350 has both, selected in the IDE under `Tools -> CPU Architecture`. The
Arduino core supports both and reports FreeRTOS as the only known incompatibility.

Neither Raspberry Pi's documentation nor the core's says which draws less, and it
is second order here in any case: the processor is awake for a few seconds out of
nine hundred, and during those seconds the radio dominates. **Build for ARM**, the
better-travelled path with the WiFi stack, and treat the architecture as one more
thing to measure — the wake duration in the log is the instrument.

### Transport

Behind an interface, because the implementation is the part expected to change: a
board that wakes, measures, sends a few dozen bytes and sleeps is exactly what a
long range radio is for, and WiFi is here because it can be tested on a desk
today. Two things a LoRaWAN implementation cannot keep are written down in
`Transport.h` rather than left to be discovered — the payload size at the slowest
data rates, and the fact that joining on every wake would cost more than it saves.

There are two implementations now. `TRANSPORT` in `config.h` picks between them:
`USE_LORA` for the Core1121 on SPI1, `USE_WIFI` for the network, and `USE_AUTO` —
the default — for **whichever the hardware turns out to have**. A LoRa packet goes
to a Raspberry Pi running `pi-reader`, which relays the bytes onward untouched, so
a node out of WiFi range still appears on the server as itself. Plain LoRa rather
than LoRaWAN: there is no network to join, and no acknowledgement that anything
heard it.

`USE_AUTO` asks the SPI bus rather than trusting a flag: `GetVersion` by hand, and
a chip that answers with something other than all zeroes or all ones is a radio.
That question cannot be delegated to RadioLib, whose `findChip()` returns a bool
and whose error macro does `return(state)` — so a failed version read comes back as
`(bool)(-707)`, which is `true`, and every conclusion after it is drawn from a
detection that never happened.

**The probe has to retry**, which is the part that is easy to get wrong and was.
`lora-node.ino` runs the same probe, but only after waiting up to five seconds for
a serial monitor, so its radio has had seconds of power before anything speaks to
it; there the probe is a diagnostic that gates nothing and `begin()` runs regardless
with five growing retries. This sketch waits for nothing on purpose, so a single
read lands milliseconds after power-up, gets zeroes from a chip that is still
starting, and concludes — confidently, and wrongly — that there is no radio. Five
attempts with a growing pause fix it, and a board that really has no radio pays
about a second and a half, once, before going on to spend several seconds joining
a WiFi network.

It does compile both transports, so RadioLib has to be installed even on a board
that ends up on WiFi; `USE_WIFI` is the way out of that.

A wake costs milliseconds rather than the seconds WiFi spends connecting, which is
the whole point. The radio is configured once at boot and slept holding its
configuration afterwards, because `begin()` calibrates against the oscillator and
the first attempt after a cold power-up is the one likely to fail — a growing
retry is the right answer once at boot and a poor one every fifteen minutes. A
failed wake or a failed transmission clears the flag, so the next wake pays for a
full initialisation and a radio that has lost its configuration recovers by
itself.

**Both ends must agree exactly.** There is no negotiation in LoRa and no error
when two ends disagree: a mismatched spreading factor, a mismatched CRC setting
and a missing antenna all sound alike, which is silence. The defaults at both ends
are the parameters the link has actually been made to work with — `lora-node.ino`'s,
which are Waveshare's own example's — and the far end's counterparts are
`screwcloud.lora.*` in `pi-reader`'s `application.properties`.

## Sending to the server

### Protocol

A raw binary UDP packet, big endian. No JSON and no HTTP, because NB-IoT traffic
is metered.

```
Header (8 bytes)                Sensor record, 5 bytes and then its fields
0     version   uint8 = 2       0..3  id      4 x ASCII, space padded
1..4  deviceId  4 x ASCII       4     fields  uint8
5     count     uint8           then 3 bytes per field:
6..7  sequence  uint16            0    type   uint8, from the registry
                                  1..2 value  uint16 or int16
```

**A sensor sends only what it measured.** A plain RuuviTag sends two fields and
costs 11 bytes; a Ruuvi Air sends four and costs 17. A reading the sensor does
not have is simply absent, and the server reports null for it — there are no
sentinel values, because a format that can leave a field out does not need any.
A value that would not survive the round trip is left out for the same reason:
silent overflow would be worse, because the server could not tell it from a real
reading.

The field type registry, which lives in `Protocol.h` and is checked against the
readers by `ProtocolSyncTest`:

| Type | Measurement | Unit |
|---|---|---|
| 1 | temperature | int16, 0.01 °C |
| 2 | humidity | uint16, 0.01 %RH |
| 3 | pressure | uint16, 0.1 hPa — every RuuviTag and Ruuvi Air |
| 4 | CO₂ | uint16, ppm |
| 5 | PM2.5 | uint16, 0.1 µg/m³ |
| 6 | VOC index | uint16 — Ruuvi's 0–500 scale, 100 is typical air; Ruuvi Air |
| 7 | NOx index | uint16 — the same scale; Ruuvi Air |
| 8 | battery | uint16, mV — the sensor's own battery; RuuviTags send it, a Ruuvi Air on the mains does not |
| 9 | luminosity | uint16, lx — a Ruuvi Air; coarse, since the device measures it on a logarithmic byte |

**Numbers are permanent.** A type means one measurement with one scaling, in
every firmware and every reader, forever; a new measurement takes the next free
number rather than reusing one. Two implementations disagreeing about what 4
means would file carbon dioxide as particulates and nothing would look broken.

**An unknown type is stepped over, not refused.** Every field is the same three
bytes, so a reader that has never heard of a type skips it and keeps the rest.
That is what lets a firmware start reporting something before a server knows
what to do with it — the alternative would throw away the temperature in the same
packet over a field nobody asked for.

#### Version 1 is still spoken

The original format was a fixed 8-byte sensor record — temperature and humidity,
with `0x8000` and `0xFFFF` standing in for a missing value — and it had no room
for a third measurement. That is what the Ruuvi Air wanted, and
[protocol-evolution.md](protocol-evolution.md) is where the alternatives were
worked through and this one chosen.

**Nothing has to be upgraded.** A device flashed before the change keeps sending
version 1 and is none the wiser; the server decodes both, and the version byte
being the first thing read is what makes that possible. That was the whole point
of having it.

With three plain sensors the packet is 41 bytes. **There is no point optimising
below that:** the IP and UDP headers already take 28 bytes, so halving the
payload would save barely a tenth of the total traffic.

#### What that costs on a metered SIM

Worth doing the arithmetic once, because it decides whether the whole NB-IoT idea
is affordable. With the defaults — a five-minute interval and three sensors —
there are 288 sends a day of 69 bytes each on the IP layer — 41 of payload and
28 of IP and UDP headers:

| Traffic | Amount |
|---|---|
| per day | **19.9 kB** |
| per month | 0.60 MB |
| per year | 7.3 MB |
| time to reach 1 MB | 50 days |

Nothing else is on the wire: UDP means the server never answers, and
`SERVER_HOST` is an IP address so there are no DNS lookups. Operator signalling —
attach, tracking area updates — is normally not billed as data, though that is
worth confirming with yours.

At the Telia Prepaid rate this project uses, **0.01 €/MB with a 0.99 €/day cap**,
that is 0.02 cents a day, or **about 7 cents a year**. The daily cap is
unreachable: hitting it would take 99 MB a day, a packet every 60 ms. Even the
worst failure mode stays far below it — if the link breaks and `RETRY_INTERVAL_MS`
takes over at one minute, the day's traffic is 99 kB.

**Rounding matters far more than the bytes do.** At these volumes, whatever
minimum unit the operator meters in dominates the bill:

| If billing rounds up | per day | per year |
|---|---|---|
| actual bytes | 0.0002 € | 0.07 € |
| to 100 kB per day | 0.001 € | 0.36 € |
| to 1 MB per day | 0.01 € | 3.65 € |

So a rounded megabyte per day costs 50 times the actual traffic — and it is still
under four euros a year. Prepaid SIMs usually also require periodic top-ups to
stay valid, which at this consumption will cost more than the data ever does.

The send interval is the only real lever; the number of sensors barely registers,
because with three plain sensors 41 % of every packet is already IP and UDP
headers, and a sensor that measures nothing extra costs 9 bytes:

| Interval | Per day | Per month |
|---|---|---|
| 1 min | 99.4 kB | 2.98 MB |
| **5 min (default)** | **19.9 kB** | **0.60 MB** |
| 15 min | 6.6 kB | 0.20 MB |
| 60 min | 1.7 kB | 0.05 MB |

Plain sensors, two fields each:

| Sensors | Payload | Per day |
|---|---|---|
| 2 | 30 B | 16.7 kB |
| 3 | 41 B | 19.9 kB |
| 8 (the maximum) | 96 B | 35.7 kB |

A Ruuvi Air costs 6 bytes more than a plain tag, because it sends two fields
more. Three of them instead of three tags is 59 bytes of payload and 25.1 kB a
day — which is the thing worth noticing about type-length-value here: the
measurement that was impossible in version 1 costs about a quarter more traffic,
not a different order of magnitude.

Which is the argument for sending several measurements in one packet rather than
shrinking the payload, if data ever needs saving in earnest.

**The packet is unauthenticated.** A UDP sender address is trivial to spoof, so
the server's data should not be trusted for anything beyond display. If this ever
gets another use, the format needs an HMAC and a version bump.

### Identifiers

`DEVICE_ID` in config.h, exactly 4 ASCII characters, unique per device. An
alternative would be to derive it from the RP2350 flash serial number so no
per-device code edit is needed, but that would be unreadable in the UI — and
devices are flashed one at a time anyway.

Sensor identifiers are 4 characters. For a RuuviTag it is `R` and the low twelve
bits of the MAC address in hex, derived from the address and from nothing else:
not from a name, so that renaming a measuring point cannot split a sensor's
history in two, and not from a running number, so that it survives a reboot.

Twelve bits is 4096 values, where an earlier version used the last MAC byte
alone and two tags out of eight collided about one time in ten — silently, since
both then arrived as the same sensor. Both firmwares derive it identically, so a
tag heard by either board reports as the same sensor.

The identifier is what the server stores; it is not what a reader sees. The OLED
shows a name, and the web interface shows the name given there.

### Three transport choices

| Definition | Use |
|---|---|
| `TRANSPORT_AUTO` | **default.** Probes for the NB-IoT modem with an AT command at boot and uses it if it answers, otherwise WiFi |
| `TRANSPORT_WIFI` | WiFi only |
| `TRANSPORT_NBIOT` | NB-IoT only |

AUTO compiles both in and costs a couple of seconds of boot time when no modem
is present. A fixed choice saves flash and removes the detection delay.

Both implement the same `Transport` interface (`Transport.h`). The choice is made
in `setup()` into a pointer, because AUTO does not know the answer at compile
time.

Detection uses `Sim7028Transport::probe()`, which opens the UART and tries `AT`
`NBIOT_PROBE_ATTEMPTS` times with a short timeout. Opening the UART is
idempotent, so `begin()` reuses the same setup.

#### SIM7028 NB-IoT HAT

Controlled with AT commands over UART. The detail that matters for binary data:
`AT+CIPSEND=<link>,<length>` takes the length up front and does not look for a
terminator, so **binary data needs no escaping** — the raw packet goes through as
is.

The command sequence:

```
AT → ATE0 → AT+CMEE=2 → AT+CPIN (PIN)
  → AT+CFUN=0 → AT+CGDCONT (APN) → AT+CFUN=1
  → AT+CEREG?  until stat is 1 or 5
  → AT+NETOPEN → AT+NETOPEN?  until state is 1
  → AT+CIPOPEN=0,"UDP",,,<localPort>
  → AT+CIPSEND=0,<length>,"<ip>",<port>
```

Three places where UDP differs from TCP and which are easy to get wrong:

1. **A UDP socket is opened without a remote address**, with only a local port:
   `AT+CIPOPEN=<link>,"UDP",,,<localPort>`. With TCP the address is given on
   open, with UDP only on send.
2. **`AT+NETOPEN` acknowledges with `OK` immediately**, but the PDP context
   activates only afterwards and the result arrives as a separate
   `+NETOPEN: <err>` line. If `CIPOPEN` is sent before that, it fails. Hence the
   state is polled with `AT+NETOPEN?` until it returns 1.
3. **The destination is given on every send:**
   `AT+CIPSEND=<link>,<length>,"<ip>",<port>`.

Source: SIM7028 Series TCPIP Application Note V1.04, sections 2.1.1–2.1.4.

##### When a send fails

The thing that makes `CIPSEND` convenient for binary data is also what makes a
failure dangerous: it takes the length up front and then swallows **exactly that
many bytes, whatever they are**. Miss the `>` prompt — one slow answer during a
network hiccup is enough — and the module is left counting, so the next cycle's
`AT+CIPSEND=...` is fed to it as a payload. It sends that text to the server,
which logs an unknown protocol version 65: the letter `A`. Nothing recovers on its
own, because every attempt feeds the mouth it is trying to talk to.

So every failure is followed by a resynchronisation. First politely — a plain `AT`
is answered only in command mode — and if that fails, the module is given exactly
the bytes it is still owed, which completes the send it was waiting for. Zeroes,
because the server recognises the version byte and drops the packet with one line
in its log; a second copy of a real measurement would be worse.

Beyond that the remedies escalate with the number of consecutive failures. A
failing link retries every `RETRY_INTERVAL_MS` rather than every
`SEND_INTERVAL_MS`, so the whole ladder is climbed in about six minutes:

| Failures | What happens |
|---|---|
| every one | resynchronise the command channel |
| 2 | `AT+CIPCLOSE` and `AT+NETCLOSE`; the next send reopens both |
| 4 | restart the module, then the whole `begin()` sequence again |
| 6, and half an hour up | the Pico reboots itself, if it is allowed to |

The module restarts escalate in turn, counted in how many have been spent since
a send last got through:

| Restart | What | Why this one |
|---|---|---|
| 1st | `AT+CRESET` | the vendor's own reset, and the cheapest |
| 2nd | a pulse on the `RST` line | the only rung that does not need the module to be listening — **present only if the wire is** |
| 3rd | `AT&F` then `AT+CFUN=1,1` | a corrupted command profile is thrown away, and 3GPP's reset reaches the module through different code than the vendor's |
| 4th on | the last two again, plus `CUT POWER` on the display | nothing within reach is left |

They are ordered by how little each needs from the module. Without a wire the
middle rung is simply absent and the ladder is one shorter, so the display
reaches `CUT POWER` a step sooner — which is the honest outcome, because there
genuinely is less that can be done.

Each restart is followed by a wait — up to `NBIOT_RESET_RECOVERY_MS` — for the
module to answer `AT` again. The wait is not what it is for; the next send is a
minute away regardless. It is so that "the reset worked" and "the module never
came back" are two different lines in the log rather than the same silence.

`AT&F` is safe to send here for two reasons worth writing down: `begin()` sets
everything it needs again immediately afterwards, and the module's factory baud
rate is the same `NBIOT_BAUD` the UART is already open at, so the two cannot end
up talking past each other.

In practice the ladder plays out like this, at the 60-second retry interval:

```
with the RST wire:              without it:
 4:30  AT+CRESET                 4:30  AT+CRESET
 9:00  pulse the RST line        9:00  AT&F + AT+CFUN=1,1
13:30  AT&F + AT+CFUN=1,1       13:30  nothing left — CUT POWER
18:00  nothing left — CUT POWER
30:00  the Pico reboots, and the ladder starts again from the bottom
```

##### What no command can do

Every rung above except the `RST` line needs the module to still be parsing AT
commands, and the failure they are most needed for is exactly the one where it
is not. There is no *command* that fixes a module that has stopped listening — a
bigger reset is another rung on the same ladder, not a substitute. That is the
whole argument for the wire: it is the one remedy on the list that goes around
the firmware instead of through it.

It is still not a power cycle. The module stays powered and its reset only
restarts its processor, which covers most of the ways a module gets stuck but
not all of them.

> **`AT+CPOF` is not the answer, and is worth naming so that nobody reaches for
> it later.** It powers the module down, and on this HAT nothing can power it
> back up: a module comes back from `PWRKEY`, and `PWRKEY` is not brought out to
> the control header at all. A device that ran it would go quiet until somebody
> walked up to it and pressed the onboard button — turning a fault that might
> have cleared on its own into one that certainly will not.

So `CUT POWER` on the bottom row is not a diagnosis but an instruction, and it
is the honest thing for the display to say at that point. `PWRKEY` is not an
option here — it is not brought out to the control header — so the only thing
that would extend this ladder further is a load switch on the HAT's 5 V. Until
there is one, the last rung is a person.

Two things hold the reboot back. A failure that is waiting for a person rather
than for time to pass — `Transport::needsHumanHelp()`, which the SIM7028 reports
after the card has refused its PIN — is never rebooted into, because the restart
would only repeat the attempt that failed, and for a PIN that costs one of the
three the card allows. And a boot has to be `MIN_UPTIME_BEFORE_REBOOT_MS` old,
half an hour, before it may end itself: a device that is misconfigured rather
than stuck would otherwise restart every few minutes and roll the explanation off
the top of the serial log.

> **What the uptime rule replaced.** The reboot used to be allowed only for a
> device that had sent something successfully at least once. That flag lived in
> RAM, so the reboot it authorised also cleared it — and a device that rebooted
> and then failed to get its first send through had, by that one act, switched
> its own last resort off for good. The display read `NO MODEM, never sent` and
> stayed that way. The uptime rule protects the same serial log without handing
> the device a way to disarm itself.

Note what the reboot cannot do. The modem is powered from VBUS, so restarting
the Pico restarts this chip and nothing else: the modem keeps whatever state it
was in, while the Pico comes back with none. With the `RST` line wired the
firmware can at least restart the module without its cooperation; without that
wire, `AT+CRESET` is the deepest reset it can reach, and a module that has
stopped listening to AT commands is past taking it. Neither is a true power
cycle — that would need the HAT's 5 V behind a load switch, since `PWRKEY` is
not on the header.

The bottom row of the display says which step of the way it failed:

| Code | Where it stopped |
|---|---|
| `NO MODEM` | no answer to `AT` — wiring, power, or the module is off |
| `NO SIM` | `AT+CPIN?` got no answer at all; is the card in? |
| `NO PIN` | the card wants a PIN and `NBIOT_SIM_PIN` is empty |
| `BAD PIN` | the card refused the configured PIN. Not tried again by itself |
| `SIM PUK` | the card has used its three attempts and wants the PUK |
| `SIM ???` | `AT+CPIN?` answered something none of the above |
| `SIM SLOW` | the PIN was accepted but the card never became ready |
| `NO APN` | `AT+CGDCONT` was refused |
| `NO NET s<n> q<n>` | not registered; see below |
| `NO LINK` | `AT+CIPOPEN` failed |
| `NO PROMPT` | `AT+CIPSEND` never answered `>` |
| `NO ACK` | the payload went out but was not acknowledged |
| `CUT POWER` | every reset has been tried; see above |
| `NO WIFI` / `NO HOST` / `NO SEND` | the WiFi transport's three |

`NO NET` carries its two numbers because it is the one failure whose code alone
still leaves a reader guessing: `s` is the `+CEREG` state and `q` the `+CSQ`
signal. `q99` is no signal being measured at all, which is a detached or
unscrewed antenna and a job for a screwdriver; a decent `q` with `s2` is a modem
that can hear the network and is not being let onto it, which is a job for the
operator. The same walk to the shed, but not the same thing to take along.

##### The command channel has to be drained, not just forgotten

Every AT command starts by emptying the UART's receive buffer as well as the
sketch's own. This is not tidiness. Anything the module said that nobody
collected — the tail of a response a timeout walked away from, the rest of a line
after an `ERROR`, an unsolicited `+CEREG:` as it loses the network — stays in the
receive buffer and is read back as the answer to whatever is asked next. One such
leftover puts the whole exchange a reply out of step, and it stays there: every
command is then answered by the one before it, every answer looks wrong, and
nothing in the sequence ever puts it right. The module is fine and the link never
works again.

The corollary, which is easy to get backwards: the buffer is cleared **before**
each write, never after. Clearing it after the payload of a `CIPSEND` has gone
out can throw away the acknowledgement that is already on its way back.

#### The hardware watchdog

`rp2040.wdt_begin(WATCHDOG_TIMEOUT_MS)` at the end of `setup()`, for the hang
that no amount of link logic can see. Two details make it usable here rather than
a source of boot loops:

- **It is armed last.** Bringing up the modem can take a minute, and a watchdog
  armed before that would turn a slow boot into a loop that hides the console
  output explaining the slowness.
- **`transportIdle()` feeds it, not just `loop()`.** The watchdog tops out at
  about eight seconds and a legitimate send is allowed twenty, so feeding it only
  from `loop()` would reset the device mid-transmission. Every wait loop in
  `Transport.h` already calls `transportIdle()` to keep BLE alive; a wait that is
  progressing therefore feeds the dog, and one that has stopped does not.

##### Wiring

The board has two separate headers, and it matters which pin comes from which.
The UART comes from the control header, power from the 40-pin Raspberry Pi
header or from the board's own USB-C.

The control header is **H2, and it has nine pins**, not eight — worth saying
because it is easy to miscount and land a wire one position out:

| H2 pin | Net | Notes |
|---|---|---|
| 1 | `VBAT` | battery rail, 2.2–4.3 V. **Never 5 V** — see below |
| 2 | `GND` | |
| 3 | `RXD1` | module input ← Pico GP0 (UART0 TX) |
| 4 | `TXD1` | module output → Pico GP1 (UART0 RX) |
| 5 | `WAKE` | through R9, marked `NC/0R` — probably unpopulated |
| 6 | `RI` | through R10, marked `NC/0R` — probably unpopulated |
| 7 | `RST` | reset, active **high**. See below |
| 8 | `GND` | |
| 9 | `BOOT` | firmware download select. **Not a second reset** |

What is wired:

| SIM7028 HAT | From which header | Pico 2 W | Physical pin |
|---|---|---|---|
| RX | H2 pin 3 | GP0 (UART0 TX) | 1 |
| TX | H2 pin 4 | GP1 (UART0 RX) | 2 |
| GND | either | GND | 3 |
| 5V | **40-pin header, pin 2 or 4** | VBUS | 40 |
| RST | H2 pin 7 | GP2, optional | 4 |

The HAT's logic level defaults to 3.3 V, directly compatible with the Pico. The
names are from the module's point of view: the HAT's RX is an input, so the
Pico's TX goes there.

`PWRKEY` is **not** on this header. It exists on the board, with the onboard
button K1 on it, but it is not brought out — so the graceful power-down-and-up
that a SIMCom module normally offers is not reachable without soldering to the
board, and is not worth it.

##### RST and BOOT: what they are, and why only one of them is useful

They look like a matched pair on the silkscreen and are not. `RST` restarts the
module. `BOOT` decides what it restarts *into*.

`BOOT` is the download control pin: asserted at startup, the module comes up
waiting for a firmware image over the UART instead of running its own firmware.
From the Pico's side that is indistinguishable from a dead modem. Together the
two are a way to force a reflash — hold `BOOT`, pulse `RST` — which is a service
operation, not a runtime one. **Do not wire `BOOT` into anything that runs by
itself.** Its only possible effect on this device is to make the modem silent in
a way no code here can undo.

`RST` is worth a wire, and is the one rung of the recovery ladder that does not
need the module to still be listening.

##### ⚠️ Both are active HIGH, and driven push-pull

Not the open-drain, active-low arrangement a bare SIMCom pin wants — the HAT has
buffered them. Each header pin goes through 4.7 kΩ into the base of an MMBT3904
NPN (Q1 for `RST`, Q3 for `BOOT`) with 47 kΩ from base to ground, emitter
grounded, collector on the module's own line. The transistor inverts, so:

- **Drive the pin HIGH to assert.** An ordinary `pinMode(OUTPUT)` and
  `digitalWrite(HIGH)` from 3.3 V is correct and safe.
- **An undriven pin is inactive.** The 47 kΩ base pull-down holds it there, so a
  Pico sitting in reset does not drag the modem down with it.

The buffering is there because the module's own IO sits in a 1.8 V domain — the
board carries a TXB0104 level shifter between `VDD_1.8V` and `VDD_3.3V`, and an
`IO_1833_SEL` pin to pick the domain. Driving the module's pins directly at
3.3 V would not be safe; driving the header's is.

Source: [SIM7028-NB-IoT-HAT-Schematic.pdf](https://files.waveshare.com/wiki/SIM7028-NB-IoT-HAT/SIM7028-NB-IoT-HAT-Schematic.pdf),
sheet 1 (H2, Q1/R5/R6, Q3/R19/R21, U3 TXB0104).

Wiring it is one line of configuration — `NBIOT_RESET_PIN` in config.h, which
defaults to unset. The pulse width, `NBIOT_RESET_PULSE_MS`, lives in
`Transport.h` instead, because it is a property of the module rather than of
anyone's installation. **It has not been checked against the SIM7028 hardware
design document**, which would not be fetched from either source that carries
it; 200 ms is a deliberate overestimate of the ~100 ms SIMCom modules usually
want. If a reset does not take, that number is the first thing to look at.

##### ⚠️ Do not feed 5 V into the VBAT pin

The first pin on the control header is `VBAT`, and according to the schematic it
sits on the **battery rail after the buck converter**, not on the 5 V input:

```
5V (40-pin pins 2/4, same net as the Type-C VBUS)
   → U1 SY8105I buck → VBAT → module pins 34/35 and control header pin 1
```

The `VBAT` rail is specified at 2.2–4.3 V. The Pico's VBUS 5 V would exceed it.
Always feed the board from the **40-pin header's 5 V pin** or from its own USB-C.

Because the Type-C VBUS is on the same net as the 40-pin header's 5 V, the board
can simply be powered from its own USB-C cable on the bench. The NB-IoT
transmission spikes — hundreds of milliamps — then do not load the Pico's supply
at all. **A common GND is still required**, otherwise the UART does not work.

##### Jumpers: remove all caps

The jumper block is a 2×4 header whose pins connect like this:

| Pin | Net | Pin | Net |
|---|---|---|---|
| 1 | CH_RXD (USB serial chip) | 2 | CH_TXD |
| 3 | TXD1 (module) | 4 | RXD1 (module) |
| 5 | P_RX (40-pin) | 6 | P_TX (40-pin) |
| 7 | CH_TXD | 8 | CH_RXD |

Two caps side by side always bridge one pair:

| Position | Bridges | Connects |
|---|---|---|
| A | 1–3, 2–4 | USB serial chip ↔ module |
| B | 3–5, 4–6 | 40-pin header ↔ module |
| C | 5–7, 6–8 | USB serial chip ↔ 40-pin header |

**The control header's RX/TX go straight to the level shifter outputs, bypassing
the jumper block.** So when the Pico is on that header, the jumpers route
nothing useful — they would only put the board's own USB serial chip on the same
lines to fight the Pico. Hence **remove all caps**.

Alternative: caps in position B and the Pico on the 40-pin header's pins 8 (TXD)
and 10 (RXD). Works equally well, but the control header is handier.

##### Test the module on its own first

Before wiring it to the Pico it is worth putting the caps in position **A**,
plugging the USB-C into a computer, and running from a serial terminal (115200):

```
AT           → OK
AT+CSQ       → signal strength
AT+CEREG?    → second number 1 or 5 = registered
```

That separates "the module, SIM or network does not work" from "the Pico's UART
wiring does not work". Then remove the caps and connect the Pico.

##### SIM PIN

`NBIOT_SIM_PIN` in config.h, empty if the card does not ask for one.
`unlockSim()` reads `AT+CPIN?` first and only sends the code if the card expects
it.

A wrong PIN is not retried: the attempts are limited and the card would lock
behind the PUK. The error is reported and initialisation aborts.

**The PIN has no effect on whether the module answers AT commands.** A locked SIM
answers normally; the PIN only shows up at registration. If `AT` gets no answer
at all, the fault is always the UART wiring or the power supply.

##### Troubleshooting

`NBIOT_DEBUG` is on by default and prints all AT traffic to the serial console.
Worth keeping on until the connection has been proven to work.

If `AT` gets no answer, work through this in order:

1. **Is the STA led lit?** It comes on when the module gets power. If it is dark,
   the fault is the supply — check that 5 V comes from the 40-pin header's pin 2
   or 4 (**not** the control header's VBAT pin), or plug in the board's own USB-C.
2. **Is the NET led blinking?** 64 ms on / 800 ms off = network registration
   failed, 64 ms / 3000 ms = registered, dark = module off or asleep.
3. **Is GND common?** If the board is powered from its own USB-C, ground still
   has to be wired to the Pico, otherwise the UART does not work.
4. **Are TX and RX crossed?** The HAT's RX is an input, so the Pico's TX (GP0)
   goes there. If in doubt, try swapping.
5. **Are all jumper caps removed?** A cap in position A puts the board's own USB
   serial chip on the same lines, competing with the Pico.
6. **The right header?** The UART is on the control header, H2. If you use the
   40-pin header, the caps have to be in position B.

If none of that resolves it, enable **`NBIOT_SERIAL_BRIDGE`** in config.h. The
Pico then forwards between the serial console and the modem in both directions,
so AT commands can be typed from the serial monitor straight to the modem —
using exactly the wiring you actually use. Set the serial monitor line ending to
**Both NL & CR**. In this mode `setup()` never returns, so measuring, the display
and BLE do not run.

Bridge mode separates two things: if `AT` gets no answer there either, the fault
is in the wiring or the power supply rather than the software.

##### APN and joining the network

`NBIOT_APN` is `internet` on a Telia card.

**The APN is set with the radio off:**

```
AT+CFUN=0   →   AT+CGDCONT=1,"IP","internet"   →   AT+CFUN=1
```

This matters: `AT+CGDCONT` does not take effect mid-attach, so without the
`CFUN` cycle the modem keeps searching with the old settings and gets stuck at
`+CEREG: 0,2`.

`NBIOT_BAND` locks the band, for example `"20"`. Empty = every supported band is
scanned. Locking speeds the scan up considerably, but a wrong band prevents
attaching entirely, so it is not worth setting by guesswork. In Finland NB-IoT is
mostly on band 20 (800 MHz).

##### Registration is not waited for in setup()

`begin()` initialises the modem but **does not wait for the network attach**.
Waiting would block `setup()` for minutes, leaving the sensors, the display and
BLE dark for the whole time.

The state is checked when sending instead. The device therefore measures,
displays and scans normally from boot, and the network joins when it joins. After
a failed send the next attempt comes after `RETRY_INTERVAL_MS` (60 s) rather than
the normal five minutes.

`+CEREG: <n>,<stat>` states:

| stat | Meaning |
|---|---|
| 0 | not registered, not searching |
| 1 | registered, home network |
| 2 | searching for an operator |
| 3 | registration denied |
| 4 | unknown, usually no coverage |
| 5 | registered, roaming |

A working attach typically takes **5–20 seconds**. State 2 persisting therefore
means a real problem rather than slowness.

When attaching fails, the log automatically gets `AT+CSQ`, `AT+COPS?` and
`AT+CPIN?`. **`+CSQ: 99,99` means no signal is measured at all** — almost always
a detached or unscrewed antenna.

**The AT sequence has not been verified against real hardware.** It is based on
the Waveshare wiki and the "SIM7028 Series TCPIP Application Note". The wiring
and the jumpers, on the other hand, were derived from the board's schematic
([SIM7028-NB-IoT-HAT-Schematic.pdf](https://files.waveshare.com/wiki/SIM7028-NB-IoT-HAT/SIM7028-NB-IoT-HAT-Schematic.pdf)),
because the wiki text is contradictory on those points: the Raspberry Pi guide
says position B and the TTL guide says "remove A", while neither applies when
the control header is used. Failures are reported on the serial console.

#### BLE does not stall while connecting

`Transport.h` calls `transportIdle()` inside its wait loops, and the sketch wires
that to `BTstack.loop()`. Without it, waiting for NB-IoT registration would stall
BLE scanning for minutes and the RuuviTag advertisements would go unheard.

### Send interval

`SEND_INTERVAL_MS` in config.h, default 5 min. The first send happens 30 seconds
after boot (`FIRST_SEND_DELAY_MS`), so a working connection is visible
immediately rather than one interval later.

Stale RuuviTags are left out of the packet: the last reading of a dead tag is not
a measurement, and on the server it would look fresh.

## Server

Spring Boot 4.1.0 + Vaadin 25.2.5, Java 21. The structure follows Vaadin's
official archetype `vaadin-archetype-spring-application`.

The public demo server **r.pakast.in** (77.42.75.251, UDP 5555) is the device
default and free to use, but it comes with no guarantees: it may be down and the
database may be wiped at any time. There is no authentication either — anyone who
knows a device identifier sees the readings, and anyone can send readings in your
device's name. For data you care about, run your own server.

```
server/
  src/main/java/fi/mstahv/sensorhub/
    protocol/   PacketDecoder and records — decoding the binary format
    udp/        UdpReceiver — a dedicated thread and a blocking DatagramSocket
    store/      MeasurementSample, SensorSettings, ClientDevice,
                PushSubscription, AlertSubscription (JPA), repositories
                and their stores
    alerts/     WebPushService, TemperatureAlerts, ConnectionMonitor,
                HeatSum, HeatSumAlerts — derived judgements and the
                notifications that follow from them
    validation/ @DeviceId, @SensorId, @PushEndpoint, @IncreasingBands —
                the rules the entities and the forms share
    ui/         DeviceListView, DeviceLinkCard, DashboardView,
                SensorCardLayout, SensorCard, TemperatureSparkLine,
                SensorSettingsForm, ClientId, Ages
  src/test/java/fi/mstahv/sensorhub/
    TestServer      runs the application locally with a PostgreSQL container
    DevVapidKeys    a cached development key pair, so push works locally
    TestDatabase    the container the tests share
    DatabaseTest    @DataJpaTest against the real migrated schema
    ui/UiTest       browserless tests driving the real views
    ui/Slots        reads Card slots, which the locators cannot see
    ui/Browser      answers the localStorage round trip
  tools/send-test-packet.py
```

### Storage

PostgreSQL, with the schema managed by Flyway.

It used to be an H2 file database, and that was a mistake in three separate ways.
A file database belongs to whichever process opened it, so it cannot be inspected
with a client while the application runs. Its file is wherever the working
directory happened to be, and the working directory differs between
`mvn spring-boot:run` (`server/`), an IDE run configuration (whatever it was set
to), systemd without `WorkingDirectory=` (`/`) and a container (anything) —
switching between them looks exactly like the database being wiped, because each
one starts in a different, empty directory. And its SQL dialect is close enough
to PostgreSQL to hide differences but not the same, so development and production
were never really testing the same thing.

One real database everywhere removes all three at once.

#### Local development: TestServer

Start **`fi.mstahv.sensorhub.TestServer`** instead of `SensorHubApplication`. It
is the same application, with Testcontainers starting a PostgreSQL in Docker and
`@ServiceConnection` handing the connection details to Spring — no local
PostgreSQL installation, no JDBC URL to configure, no `spring.datasource.*`
setting involved. Docker has to be running.

It lives in the test sources, because that is where the Testcontainers
dependencies are, and it is a `main` method rather than a test, so no build ever
runs it.

**Enable container reuse, or every restart starts from an empty database:**

```bash
echo 'testcontainers.reuse.enable=true' >> ~/.testcontainers.properties
```

Reuse leaves the container running when the application exits and attaches to the
same one next time, which is what makes the measurements outlive a restart. It is
a per-user setting that Testcontainers deliberately will not read from a project,
so it cannot be committed here. `TestServer` logs a warning with this exact
command when it is missing.

The container's identity is a hash of its configuration, so changing the image or
the database name in `TestServer` starts a new, empty one — as does `docker rm`.
To look inside it:

```bash
docker ps                                        # find the postgres container
docker exec -it <container> psql -U test -d screwcloud
```

The image is `postgres:17-alpine` by default. Nothing here depends on a
version-specific feature, but if you want to reproduce something the server does,
match its version (`psql -V` there) with `SENSORHUB_POSTGRES_IMAGE`.

The tests use a **separate** container with the database name `screwcloud_test`,
so a test run can never touch the measurements collected in development. The
tests assert on exact row sets and would fail against a database holding real
data.

#### Server: Ubuntu defaults

The configured defaults are those of a plain `apt install postgresql`: port 5432,
the `postgres` role, the `postgres` database.

```bash
sudo apt install postgresql
sudo -u postgres psql -c "ALTER USER postgres PASSWORD 'secret'"
SPRING_DATASOURCE_PASSWORD=secret java -jar sensor-hub.jar
```

The password step is not optional. Ubuntu's default `pg_hba.conf` uses peer
authentication on the unix socket — which is why `sudo -u postgres psql` needs no
password — and `scram-sha-256` for TCP connections. JDBC always connects over
TCP, so the role needs a password even on localhost.

Anything in `application.properties` can be overridden with an environment
variable, Spring maps the names automatically:

| Variable | Default |
|---|---|
| `SPRING_DATASOURCE_URL` | `jdbc:postgresql://localhost:5432/postgres` |
| `SPRING_DATASOURCE_USERNAME` | `postgres` |
| `SPRING_DATASOURCE_PASSWORD` | `postgres` (a development placeholder) |
| `VAPID_PUBLIC_KEY` / `VAPID_PRIVATE_KEY` / `VAPID_SUBJECT` | unset — see [Push notifications](#push-notifications) |

A dedicated role and database would be tidier than reusing `postgres` for both,
and the settings above are all it takes to move to them.

**Which database is in use is logged at startup**, so "the measurements are gone"
never has to be a guess again:

```
Measurement database: jdbc:postgresql://localhost:5432/postgres as postgres (PostgreSQL 17.10)
```

That line is read from the live connection rather than from
`spring.datasource.url`, because the property is not always the answer: under
`TestServer` the URL is decided at runtime and appears in no properties file at
all.

Backups are `pg_dump` now, not a file copy:

```bash
sudo -u postgres pg_dump postgres > screwcloud-backup.sql
```

Measurements from the old H2 database do not carry over. Nothing migrates them,
and for a temperature history that is a reasonable loss — but if you want to keep
it, export it from H2 before switching, because the application can no longer
open the file.

#### Schema versioning

| Setting | Value | Why |
|---|---|---|
| `spring.jpa.hibernate.ddl-auto` | `validate` | checks that the entities match the database but never modifies it |
| `spring.flyway.baseline-on-migrate` | unset | Flyway refuses to start against a schema that has tables but no history, instead of assuming they are the right ones |

The migrations live in `src/main/resources/db/migration/`:

| Migration | Contents |
|---|---|
| `V1__initial_schema.sql` | the baseline: measurements, sensor settings, client device lists |
| `V2__sensor_thresholds.sql` | the gauge's temperature band columns on `sensor_settings` |
| `V3__push_notifications.sql` | `push_subscription` and `alert_subscription` for web push |
| `V4__device_silence_alerts.sql` | `alert_on_silence` on `client_device` |
| `V5__heat_sum_counters.sql` | `heat_sum_counter` for the degree-day counters |

`ddl-auto=update` would quietly bend in the wrong directions without reporting
what it did, so Hibernate is no longer allowed to modify the database. The flip
side is discipline: **a new entity field needs a migration**, or startup fails
with `Schema validation: missing column`. That is the intended trade — a loud
failure at boot beats a schema that drifted silently.

Verified by running it: into an empty PostgreSQL, Flyway applies V1 and V2,
`validate` accepts the result, a restart validates the two migrations without
re-running them, and the rows are still there afterwards.

**Spring Boot 4 pitfall:** the dependency needed is
`spring-boot-starter-flyway`, not just `org.flywaydb:flyway-core`. Spring Boot 4
split the auto-configurations into their own modules, so `flyway-core` alone
gives the library but not `FlywayAutoConfiguration` — and then **the migrations
silently do not run** with nothing to tell you. The symptom is
`Schema validation: missing table` at startup.

**Flyway pitfall:** Flyway 10 moved database support out of the core into
per-vendor modules, so `flyway-database-postgresql` is needed as well. Without it
startup fails with `Unsupported Database: PostgreSQL`. H2 needed no such module,
which is why this only appears now.

**Every database test runs the migrations**, against a real PostgreSQL, with
`ddl-auto=validate`. That combination is what the `@DatabaseTest` annotation
exists for, and each of its three parts fails quietly if it is missing:
`@DataJpaTest` in Spring Boot 4 auto-configures Hibernate and the datasource but
**not** Flyway, so the schema has to be asked for explicitly; the slice otherwise
replaces the datasource with an embedded database; and letting Hibernate create
the schema would defeat the point of testing against PostgreSQL at all. Each test
runs in a transaction that is rolled back, so the shared container stays clean.

`SchemaMigrationTest` additionally boots the whole application — UI, UDP listener
and database together — and checks that both migrations are recorded as applied.

**Running the tests therefore needs Docker.** That is the deliberate trade: the
alternative is testing against a different database than the one in production,
which is what this project just moved away from.

A packet is split into per-sensor rows, because a query is always of the form
"this sensor's values over this interval". The sequence number is kept on every
row so readings from the same packet can be identified. Two indexes cover both
query types: the newest packet from a device, and one sensor's time series.

**The database is the single source of truth, including for the latest reading.**
An in-memory cache would be faster, but then the device list would vanish on
restart even though the history survived — the UI would be empty for up to five
minutes, until the next packet arrives.

A missing reading is stored as NULL, not as zero.

The database grows without bound: three sensors every five minutes is about 860
rows per day per device. PostgreSQL will not notice that for years, but at some
point pruning old rows is worth adding. There is deliberately no automatic deletion —
discarding data is the user's decision.

### The battery guess

A RuuviTag's card says `2.99 V · about 100 %` beside a drawn battery, and the
second half is a guess, so here is where it comes from. A CR2477 does not run down in a
straight line. Ruuvi's own firmware notes describe the curve: a little over
3.0 V new, 3.0 within hours under load, months of slow decline to about 2.7 V,
and then a cliff — below 2.0 V the tag reboots on momentary droops and soon goes
quiet. They conclude that predicting the end from the voltage is unreliable,
and their app accordingly shows the voltage and a *Low battery* word and no
percentage; a capacity indicator was discussed and left at three bands.

`BatteryEstimate` turns that curve into a number anyway, because "about 25 %"
answers the question a reader has — do I need a battery this month — better than
`2.71 V` does, as long as it does not pretend to precision. It is linear between
six anchors and rounded to fives:

| volts | left | why there |
|---|---|---|
| 3.00 | 100 % | a new cell under load |
| 2.90 | 80 % | the plateau's slow slide |
| 2.80 | 55 % | |
| 2.70 | 25 % | the end of the plateau, where Ruuvi's curve turns down |
| 2.50 | 5 % | Ruuvi's "replace the battery" voltage at room temperature |
| 2.00 | 0 % | rebooting on droops by now |

**Cold reads low without being empty.** Ruuvi Station moves its *Low battery*
line with the tag's own temperature — 2.5 V above freezing, 2.3 V down to
−20 °C, 2.0 V below that — and the card does the same, and reads the voltage
that much higher against the curve before guessing. A tag in a freezer at 2.4 V
is therefore *about 80 %*, not *low*, which is roughly what its owner would find
on bringing it indoors. The word *low* replaces the percentage once the cell is
under the line for its temperature.

Sources: Ruuvi's [FAQ: battery](https://github.com/ruuvi/ruuvitag_fw/wiki/FAQ:-battery)
in the firmware wiki, the thresholds in Ruuvi Station's
[strings.xml](https://github.com/ruuvi/com.ruuvi.station/blob/master/app/src/main/res/values/strings.xml)
and on the support page
[Battery information and changing the RuuviTag battery](https://ruuvi.com/ruuvitag-battery-and-how-to-change/),
and the capacity indicator discussion in
[com.ruuvi.station#335](https://github.com/ruuvi/com.ruuvi.station/issues/335).

### Validation

The rules about what a value may be are written once, as Bean Validation
constraints, and read by both ends: Hibernate runs them before every insert and
update, and the forms read the same annotations to mark a field required, to keep
Save disabled and to say what is wrong.

They live in `validation/`, and there are two kinds. `@SensorId` is *composed* —
no validator of its own, just a size and a pattern stacked on one annotation with
one message. `@DeviceId`, `@PushEndpoint` and `@IncreasingBands` have validators,
because each needs something no annotation can state:

| Constraint | What it needs a validator for |
|---|---|
| `@DeviceId` | checks the value as the store will save it: stripped, and regardless of case, so a reader may type `laht` while the database keeps only `LAHT` |
| `@PushEndpoint` | parses the URL and requires `https` — the server later makes a request to that address, and `http` would send the notification in the clear |
| `@IncreasingBands` | the four temperature limits are a set: either all given or all empty, and increasing. No single field is wrong on its own when the OK band is upside down |

`@IncreasingBands` is the one that pays for the whole arrangement. It is a *class
level* constraint on the `TemperatureBands` interface, which both the stored
`SensorThresholds` and the settings form's own record implement — so the same
rule that refuses the write is what greys out the Save button, and the reader is
told *which* way the set is broken rather than being handed the annotation's
generic message.

Where the checking happens:

- **Entities** carry the constraints, so nothing reaches the database that should
  not. This is what stands between the UDP port and the `measurement_sample`
  table: a packet is unauthenticated, and the decoder checks the frame rather than
  what the fields say. A refused row makes the receiver log an invalid packet and
  carry on.
- **Stores** are `@Validated`, with the constraints on the parameters. A rejected
  target should not have created a counter first, and the rule should hold for
  callers that are not a form.
- **Forms** bind with Viritin's `FormBinder` / `BeanValidationForm`, which is
  where the constraints become visible: a required indicator, an error under the
  field as it is typed, and a disabled Save.

Only the impossible is refused, never the improbable. A shed at -40 °C and a
sensor saturating above 100 %RH are both telling the truth as they see it; below
absolute zero, or a negative humidity, is not a measurement. A reading dropped at
the insert would take the rest of its packet with it.

`spring-boot-starter-validation` is in the pom even though Hibernate Validator
already arrives transitively: the starter brings an Expression Language
implementation, without which building a `ValidatorFactory` fails outright, and
the auto-configuration that makes `@Validated` more than an annotation.

### User interface

Two views:

| Route | View | Content |
|---|---|---|
| `/` | `DeviceListView` | the browser's own devices, adding one by identifier |
| `/device/LAHT` | `DashboardView` | one device's sensors |

The device arrives at the measurement view as a **URL parameter**, so the view is
linkable and bookmarkable.

#### Several users without user accounts

The browser generates a random UUID on its first visit and stores it in
localStorage under the key `sensorhub.clientId`. The device list is stored on the
server under that token, so several people can share one server while each sees
their own devices.

**This is not access control and does not try to be.** The token is readable in
the browser, and a device's measurements are visible to anyone who knows the
device identifier — `DashboardView` does not check whether the device belongs to
the caller's list. The device list is a convenience. Clearing browser data resets
the list; that is an acceptable price for not needing a login.

localStorage rather than sessionStorage, so the list survives closing a tab.

The token is only read from the browser after attach, because reading WebStorage
requires a round trip. The list is therefore built in a callback rather than in
the constructor. The UI is passed to the `WebStorage` calls explicitly rather
than relying on the `UI.getCurrent()` thread-local.

The `client_device` table is the natural place to hang **web push subscriptions**
on later: they belong to a browser, just like the device list.

Sensor names (`sensor_settings`), by contrast, are **shared between all users**,
because they describe a physical sensor — the cold room in the shed is the cold
room for everyone. To make names per browser, the table would need `clientId` as
part of its key.

#### Adding a device

The identifier is upper-cased and trimmed, because the device sends it in upper
case and the decoder strips the space padding. Otherwise `laht` and `LAHT` would
be different devices. At most 4 characters, as in the protocol.

A device can be on the list before it has sent anything — the card then reads
"No measurements yet". The same device can be on several browsers' lists.

#### Sensor cards

The selected device's sensors are shown as Vaadin `Card` components that wrap to
the available width. Each card carries, from top to bottom:

| Slot | Content |
|---|---|
| header | the sensor name, plus the settings icon as a header suffix |
| **media** | a **temperature gauge** (`in.virit:gauge`) |
| content | the humidity, a **sparkline of the last 24 hours** (`in.virit:svg-visualizations`) labelled with the first and last measurement time, and a collapsed **All measurements** grid |

The gauge sits in the Card's **media slot**, which is what that slot is for: a
visual belonging to the card rather than part of its text content. `Gauge`
extends `ReactAdapterComponent`, which extends plain `Component` and does **not**
implement `HasSize`, so its width is set through `getStyle()` rather than
`setWidth()`.

`TemperatureGauge` comes with a −40…+50 °C range and colour-coded sub-arcs out of
the box, which suits both indoor and outdoor sensors, so no configuration is
needed. It is updated in place with `setTemperature()`, consistent with the rest
of the card.

**The temperature is not repeated as text.** The gauge's React side sets
`formatTextValue = value => value + '°C'`, so the value already appears in the
middle of the dial with its unit and full precision — a 2 rem text line next to it
was the same number twice, and the two competed for the same job visually. The
humidity has no gauge, so it stays as text.

A gauge showing 0 would be indistinguishable from a real zero reading, so it is
**hidden** rather than zeroed when a sensor reports no temperature. A small `– °C`
takes its place in that case: with both the gauge and the text gone, a missing
temperature would look like something had failed to render rather than like a
sensor that reports none.

**Every reading** is behind a collapsed **All measurements** section at the bottom
of the card, as a `Grid` of time, temperature and humidity. The curve shows the
shape of the day but has no scale marks, stops at 24 hours, and has no humidity at
all; the table is where the actual numbers are, however far back they go.

Two kinds of laziness, for two different costs:

**The component** comes from Viritin's **`VDetails(summary, supplier)`**, which
takes a supplier instead of a component and calls it when the section is opened,
discarding the content again on close. There is one card per sensor, so building
every table up front would mean creating grids nobody asked to see.

**The rows** are fetched a page at a time with **`setItemsPageable`**, so the size
of the history does not matter — and it grows by about 290 rows per sensor per day
with nothing pruning it. The second callback supplies the exact count, which is
one indexed query and cheaper than letting the grid estimate its size and
re-adjust the scrollbar as the reader scrolls:

```java
setItemsPageable(
        pageable -> measurements.measurements(deviceId, sensorId, pageable),
        pageable -> measurements.countMeasurements(deviceId, sensorId));
```

**Paging needs a total order** or it is not paging: without one the database may
return a row on two pages or on none, and the reader sees duplicates while
scrolling. The store therefore appends `received_at desc, id desc` to whatever
sort arrives — the id because rows from the same packet share an arrival time. The
generated SQL is
`order by received_at desc, id desc offset ? rows fetch first ? rows only`.

The repository method returns a `List` rather than a `Page` on purpose: a `Page`
would issue its own count query on every fetch, and the count is asked for
separately.

The card keeps a reference to the grid while it is open and calls `refreshAll()`
on it, so a section left open keeps up. That runs only when a new packet has
arrived — the view skips the whole update when `receivedAt` has not changed — so it
is one refresh per measurement, not one per five-second poll.

The table is newest first, the opposite of the curve, because a table that is
scrolled is read from the top. Cells show only the time of day, since consecutive
rows are minutes apart, with the full timestamp including seconds as a tooltip via
`setTooltipGenerator`.

`GridVariant.LUMO_COMPACT` would be the obvious choice for a table this small, but
it has no effect under the Aura theme, and there is neither an `AURA_COMPACT` nor a
theme agnostic `COMPACT`. Only variants that exist in both themes are used.

Note that adding the gauge introduced a new npm dependency
(`react-gauge-component`), so Vaadin rebuilds the frontend bundle on the next
start. That happens automatically — the log says "Dependency
react-gauge-component is missing from the bundle" and then builds it — but the
first start after adding it takes noticeably longer.

The sparkline's x axis spans exactly the points that are drawn, and both ends are
labelled with their timestamp using the component's own `setTimeScale(start, end)`
— the texts are drawn inside the SVG, at the bottom left and bottom right, and the
constructor already reserves the space for them.

Those labels are what keeps the curve honest. A fixed "24 h" caption said nothing
about the data: a sensor that had been up for an hour looked exactly like one with
a full day of history. Now the ends read `09:05` and `18:20`, with the date added
(`Aug 9 14:05`) only when the two ends fall on different days — within one day it
is noise, and there is room for a clock time at each end but not much more.

Missing readings are filtered out, otherwise the curve would jump to zero. **With
fewer than two measured points the whole element is hidden**, labels included: one
point is a dot rather than a curve, and both of its labels would be the same time.
The count is of points that have a temperature, not of rows, so a sensor reporting
only humidity draws nothing.

**The times are rendered in the reader's own time zone**, not the server's.
Measurements are stored as instants, and the server's zone says nothing about
where the person looking at the page is — a server in a container is usually on
UTC, which would put every label a few hours off with nothing to indicate it.
`ClientTimeZone` reads the zone from
`UI.getCurrent().getPage().getExtendedClientDetails().getTimeZoneId()`.

No round trip is involved: since 25.2.1 Vaadin passes the browser details as
request parameters during bootstrap (`v-tzid` among them), so
`getExtendedClientDetails()` answers immediately and never returns null. The
callback-based `retrieveExtendedClientDetails` is deprecated for that reason.
Before the details exist Vaadin returns a placeholder whose zone id is null, and
without a UI at all — in tests, or on a background thread — there is nothing to
ask; both fall back to the server's zone.

Whether the date is needed is a property of the zone as well, not just of the
instants: an hour that stays within one day in Helsinki can straddle midnight in
Tokyo, and then only the reader in Tokyo sees a date. `TemperatureSparkLineTest`
covers that by passing the zone in explicitly.

The arrival time, the sequence number and the chip's own temperature are shown
once below the selection rather than on every card, because all three are per
device rather than per sensor. A missing value (for example humidity from a
RuuviTag Pro 2in1) shows as an en dash so it is distinct from zero.

#### Components are updated, not recreated

The view polls every five seconds but the devices send every five minutes. If the
cards were removed and recreated on every poll, Vaadin would have to resend the
whole DOM structure to the client for nothing — a well-known Vaadin antipattern.

The cards are therefore kept in a map keyed by sensor id and updated in place.
Components are only added and removed when the set of sensors actually changes.
Two refinements:

- **Cards are recreated when the device changes.** A card remembers the device id
  for its settings, and sensor ids are only unique within a device — two devices'
  `DHT` must not share a card.
- **An unchanged packet is skipped entirely.** `DashboardView` remembers the last
  device and arrival time rendered, and skips both the card updates and the
  history queries if nothing has changed. The age text is still refreshed every
  time, because it changes every second.

`SensorCardLayoutTest` verifies these: the same card instance survives when the
sensors do not change, adding a new sensor does not touch the existing cards, a
vanished sensor's card is removed, and switching devices creates new cards.

Updating the sparkline needs particular care: `setData` only stores the data, and
on an attached component `draw()` **clears** it after drawing to save session
memory. So `draw()` has to be called explicitly, otherwise the curve would only
ever update on the first attach.

#### Sensor settings

The top right of a card has a settings icon that opens a small form in a Viritin
`PopoverButton`. It holds three things: the display name, the gauge's temperature
bands, and which of the sensor's alerts this browser wants as notifications.

**Name.** A named sensor shows by its name in the card title, an unnamed one by
its sensor identifier. An empty name restores the identifier.

**Temperature bands.** Four increasing limits define five zones on the gauge:

```
   alert   warning        OK        warning   alert
────────┬──────────┬─────────────┬──────────┬────────
     alertLow    okLow         okHigh   alertHigh
```

The form asks for them as two ranges — "OK between 2 – 8" and "Alert below /
above" — which reads more naturally than four independent thresholds. The inputs
are narrow (`TemperatureField`, 4em) with a dash between them, so a pair reads as
one range rather than two unrelated numbers. Warning is simply what falls between
the two ranges.

The palette runs **blue → green → red**, so the colour says which direction is
wrong rather than merely that something is: light blue for a cold warning, deep
blue for a cold alert, orange and red on the warm side. A red band at both ends
would leave the reader to work out which end they were looking at.

Bands are **opt-in**: with none configured the gauge keeps `TemperatureGauge`'s
stock −40…+50 °C range and colours, so nothing changes for sensors nobody has
set limits for. Clearing all four reverts to that immediately, which is why
`TemperatureBandGauge` has to restore the stock arcs explicitly — the addon's
`setupTemperatureDefaults()` is private and cannot be re-invoked.

When bands are set, the displayed range zooms to `alertLow − 5 … alertHigh + 5`,
so the gauge covers the range that matters for that sensor rather than the full
−40…+50.

**Validation lives in the store, not only in the form**, so the rule holds
regardless of who calls: either all four limits are given or none, and they must
strictly increase. Equal limits are rejected too, because a zero-width arc looks
like a rendering bug rather than a configuration choice. `SensorThresholdsTest`
and `SensorSettingsStoreTest` cover this.

The bands are saved before the name, so a rejected save cannot rename the sensor
as a side effect.

Both settings are stored in the `sensor_settings` table keyed by device + sensor,
because sensor identifiers are only unique within a device. The form is rebuilt
on every open, so the fields always show the stored values and no state has to be
synchronised separately.

#### Degree-day counters

For hanging game. The practice is measured in **vuorokausiastetta** — degree-days,
temperature multiplied by time — with forty as the general guideline: +8 °C for five
days and +5 °C for eight days are the same thing, and some prefer sixty for more
flavour. The ideal hanging temperature is 2–7 °C, and above 10 °C bacteria grow
faster than the meat matures.
([hirvikota.wordpress.com](https://hirvikota.wordpress.com/kaadon-jalkeen/riistan-riiputus/))

Two rules from that practice shape the arithmetic in `HeatSum`:

- **"Jäätynyt liha ei mureudu"** — frozen meat does not tenderise. Time below zero
  contributes nothing, and it does not subtract either: what has already happened
  does not un-happen.
- Everything above zero counts at its own value, which is why the reference table
  runs all the way down to 1 °C for 40 days.

The sum is a **trapezoidal integral** of the readings from the counter's start: each
pair of samples contributes the average of the two temperatures over the time
between them, both clamped at zero first. Gaps are interpolated rather than skipped
— a shed's temperature moves slowly, so the average across a two-hour outage is a
better guess than pretending those hours did not happen, and pretending would
under-count and mean hanging longer than the meat needs.

`HeatSumTest` checks the arithmetic against the guideline's own examples: +8 °C for
five days and +5 °C for eight both come out at 40.

**The forecast is the useful part.** The sum alone does not answer "should I be
there on Saturday", so the card shows when it will be done:

```
hirvi · 27.4 / 40 °Cd
[============-----]
About 2 d left, done Thu 09:15
```

The rate is the recent average temperature over six hours — degree-days per day and
degrees Celsius are the same number — long enough to ride out a warm afternoon,
short enough to follow a cold front.

**A brand-new counter forecasts from the temperature right now.** For its first few
minutes a counter is younger than the device's send interval, so nothing has arrived
since it started and there is nothing to average. The sensor's latest reading is
still a straight answer to "how fast is this going", and it beats several minutes of
"waiting". Such a forecast is labelled, because one reading is not a measurement of a
trend:

```
About 1 d 18 h left, done tomorrow 09:15 — from the current temperature, sharpens as it runs
```

The notifications ignore those estimates entirely: extrapolating a whole target from
a single reading is fine on a card someone is looking at, and not fine as a reason to
make a phone buzz.

Below freezing there is no completion date at all, and the card says so rather than
forecasting decades. **No readings and a rate of zero are different things**, and
they read differently: "Waiting for the first reading" against "Not accumulating —
below freezing". Conflating them is what once made a counter in a 23 °C room report
that it was frozen.

**Several counters per sensor**, each with a short comment: two carcasses hung on
different days are two counters on one thermometer. That is why they are a table of
their own (V5) rather than more columns on `sensor_settings`.

Unlike the alert subscriptions, a counter is **not per browser**. What hangs in the
shed is a fact, not a preference, so everyone watching that sensor sees the same
counters — only whether a notification arrives is personal, and that follows the push
subscription each browser already has.

**A counter can start in the past.** The meat goes up on Saturday evening with
cold hands and the counter comes to mind on Tuesday. The Start form has a *Hung
since* field, now by default, and a counter started from the moment the door
closed is as true as one started on the spot: every reading since then is in the
database, and the sum appears already counted. The form refuses a time still
ahead of the reader's clock, and the store's `@PastOrPresent` stands behind it.

**Alerts default to on**, both of them: a day before the target and when it is
reached. A counter nobody is told about is a calendar reminder with extra steps. "A
day before" is judged from the forecast rather than from a margin in degree-days,
because a day is two degree-days at 2 °C and eight at 8 °C — a fixed margin would
give a day's notice at exactly one temperature.

Each notification is sent once, and the "once" is a column on the counter rather
than a field in memory: a counter runs for weeks, and a restart should not announce a
target passed last Tuesday all over again. Raising the target clears those flags —
the reader has decided the meat needs longer and should hear about the new target;
lowering it does not, since the old one was already announced.

Counters are evaluated when a packet arrives, not on a timer. Unlike a silent
device, a counter cannot cross its target while nothing is happening.

#### Push notifications

Alerts arrive as **web push notifications**, so a phone buzzes even when the app
is closed. Off by default and off entirely unless the server has VAPID keys.

**Setting it up.** Generate a key pair once and pass it in the environment:

```bash
java tools/generate-vapid-keys.java

VAPID_PUBLIC_KEY=B... \
VAPID_PRIVATE_KEY=... \
VAPID_SUBJECT=mailto:you@example.com \
java -jar sensor-hub.jar
```

`tools/generate-vapid-keys.java` runs on the JDK you already have — it is the same
EC P-256 pair that `npx web-push generate-vapid-keys` produces, without needing
Node. It prints the three variables ready to copy.

**Running `TestServer` needs no keys at all.** It generates a development pair on
first run, caches it in `~/.screwcloud/vapid-dev.properties` and applies it, so the
switch is live and notifications genuinely arrive — a push service does not care
where a VAPID key came from, only that a notification is signed by the key its
subscription was created with.

That is also why the pair is cached rather than generated per start: a new key
would invalidate every subscription a browser had already made, and those would
then fail forever with nothing on screen to explain it. Delete the file to start
over. Real keys in the environment always win, and `DevVapidKeys` checks for them
first — system properties outrank environment variables in Spring, so without that
check a developer's own keys would be silently replaced.

**Running the plain application from an IDE** does need the three variables in the
run configuration's environment. Without them the front page shows the notification
switch **disabled** with "not configured on this server", which is the answer to
"why do I see no notification UI" — the feature is genuinely off until the keys are
there. The startup log says the same:

```
Web push notifications are disabled: set VAPID_PUBLIC_KEY, VAPID_PRIVATE_KEY and VAPID_SUBJECT to enable them
```

The per-sensor alert section is left out entirely in that state rather than shown
dead in every sensor's popover; the switch is the one place that explains why.

The private key is a credential — it is what proves to the browsers' push
services that a notification comes from this server — which is why it comes from
the environment and nothing defaults it. **With no keys set the feature is simply
absent**: the switch is hidden, the per-sensor section is left out, and everything
else runs as before. The startup log says which of the two it is:

```
Web push notifications are enabled
Web push notifications are disabled: set VAPID_PUBLIC_KEY, VAPID_PRIVATE_KEY and VAPID_SUBJECT to enable them
```

`VAPID_SUBJECT` has to be a `mailto:` or `https:` URL; Apple's push service
rejects notifications without one. Notifications also require HTTPS in the
browser — `localhost` is exempt, so development works over plain HTTP.

**No service worker of our own is needed.** `@PWA` is already enabled, and the
service worker Vaadin generates from it handles both the `push` event
(`showNotification`) and `notificationclick` (focus or open the app). A custom
`sw.ts` would only be needed to open a specific view per notification.

**Two switches, on purpose.** The front page has one switch for the whole browser;
each sensor's settings say which of its transitions are worth a notification:

| Choice | Fires when |
|---|---|
| goes into an alert band | the reading crosses `alertLow` or `alertHigh` |
| goes into a warning band | it leaves OK, or moves between the warning bands |
| comes back to OK | it returns to the OK band |

The switch and the choices are stored separately (`push_subscription` and
`alert_subscription`), because they have different lifetimes: turning the switch
off deletes the browser's push endpoint and so stops everything at once, while the
per-sensor choices survive it. Turning it back on does not mean configuring every
sensor again.

**The browser is the authority on the switch's state**, not the database.
Notification permission can be revoked in browser settings without this server
hearing about it, so the switch reads its position from
`webPush.subscriptionExists(ui, …)` on load. Setting a checkbox programmatically
would otherwise be indistinguishable from the user asking to subscribe, which is
what the `event.isFromClient()` guard in `NotificationSwitch` is for.

**Only changes are announced**, and only band changes. A sensor that stays too
warm for a day sends one notification, not 288 — the reader already knows. The rule
is in `TemperatureAlerts.transitionToAnnounce`, kept static and pure so it reads as
a table of cases:

| Previous | Now | Result |
|---|---|---|
| alert high | alert high | silent — nothing changed |
| OK | warning high | announced at once |
| warning high | alert high | announced at once — it got worse |
| warning low | warning high | announced at once — it crossed the whole OK band |
| alert low | warning low | waits — improving is news, but only once it lasts |
| nothing yet | OK | silent — a first reading is not a transition |
| nothing yet | alert high | announced — a freezer already too warm is worth knowing |

A band change is the trigger rather than a change of severity, because both
warning bands share a severity and a swing from one to the other would otherwise
go unmentioned.

**Getting worse is announced at once; getting better has to last.** A reading
sitting exactly on a limit crosses it every few minutes, and with every crossing
counted as a change, one sensor produced seven notifications in an hour on a field
morning. So a calmer band is announced only once the sensor has not been seen in
the announced one for an hour:

| The morning's readings, 12 in an hour | Notifications |
|---|---|
| every crossing announced (before) | 8 |
| hysteresis 0.2 °C, asymmetric | 1 |
| calmer band has to hold for an hour | 1 |
| a 30-minute cool-down on top of the old rule | 2 |

Two of those three work; the settling rule was chosen because it needs nothing
stored. Hysteresis — a deadband around the limit, as a thermostat has — is the
other standard answer and would steady the gauge colours too, but a correct one
needs to remember which state the sensor was announced in, which is a column and a
migration. The delay costs nothing but the promptness of good news, and anyone
worried enough to want it sooner is looking at the dashboard, where the reading was
right all along.

The clock measures **how long ago the sensor was last seen in the band the reader
was told about**. Wandering between calmer bands does not restart it, returning to
the announced one does, and what is finally announced is the band the sensor is in
*now* — coming down through two limits within the hour, the middle one was never
news. Getting worse still interrupts the wait immediately.

The rule needs to know what was last announced, which is not the same as the
previous reading's band, since some readings are deliberately not announced. It is
worked out by replaying the last sixty readings rather than by remembering: a
cache would empty on restart and start announcing what had already been said.

**A sensor with no bands never notifies.** Without limits there is nothing to
leave or return to, so notifications are as opt-in as the gauge colours are.

**The readings come from the database**, not from memory: they are read back after
the packet is stored. An in-memory
per-sensor cache would be emptied by every restart and would then report the first
reading after a deployment as a change.

Known rough edge: a reading hovering exactly on a limit will flap. Each crossing
is a real band change, so each one notifies, and with a packet every five minutes
that could mean a notification every five minutes. Hysteresis would fix it and is
not implemented — set the bands a little wider than the temperature you actually
care about.

**Sending happens off the receiving thread.** `WebPushService` owns a single daemon
thread, so a slow or unreachable push service cannot delay the next packet. When a
push service reports an endpoint as gone, the subscription is deleted rather than
retried forever — Vaadin does not expose the HTTP status, only a message naming
"404 or 410", so that string is what the code matches on. Other failures are
logged and the subscription kept, since they are usually temporary.

Verified by running it: with a seeded subscription and bands −5/2/8/15, packets of
5.0 → 5.5 → 20.0 → 20.5 → 5.0 °C produced notifications for exactly the three band
changes and nothing for the two unchanged readings. The send itself was attempted
against a deliberately unreachable endpoint and failed with a warning rather than
taking down the receiver. **Delivery to a real browser has not been tested** — that
needs a browser and a public HTTPS host.

#### Connection lost

The one failure the rest of the system cannot see. Every other alert is triggered
by an arriving packet — a device whose power is out or whose network has dropped
sends nothing at all, and the last reading it managed sits in the UI looking
perfectly fine. So this check is driven by a clock instead: a `@Scheduled` sweep
once a minute, which is the only thing scheduling is enabled for.

**The interval is learned, not configured.** Nothing tells the server how often a
device sends — that lives in the firmware's `config.h` and can be anything — so
`DeviceActivity` takes the **median** gap between the last dozen arrivals. The
median rather than the mean, because one missed send is exactly what a lost UDP
packet looks like and it must not teach the server that the device is slow.

A device counts as silent after **3.5 learned intervals**: three missed reports,
because one is normal and two could be a bad few minutes, plus half an interval of
slack so a device whose timing drifts is not declared dead the moment the third
report is theoretically due. For a five-minute device that is 17.5 minutes; for an
hourly one, 3.5 hours. Below four arrivals there is no median worth trusting and
nothing is ever declared silent — a device that was just set up should not be
reported offline before it has established a rhythm.

**The same rule drives the badge and the notification**, so the page and the phone
cannot disagree about what offline means. The device list shows a red badge on the
card, the dashboard one under the status line, and both say how long the silence
has lasted next to what the rhythm was:

```
Offline · nothing for 34 min, expected every 5 min
```

Only the exceptional state is shown. A green "online" badge on every card would be
noise.

**Subscribing is a checkbox on the device card**, stored as `alert_on_silence` on
`client_device` rather than in a table of its own — that table is already keyed by
exactly the right pair, one browser and one device, and it is already the list of
devices someone cares about. Removing the device takes the subscription with it.

The sweep starts from the subscriptions, not from every device that ever sent a
packet: a device nobody watches needs no checking, and one decommissioned months
ago should not be rediscovered as "offline" on every server start.

Notified once per outage, and once again when reports resume. The recovery message
measures the outage from **the last packet that arrived**, not from when the sweep
noticed — otherwise every outage would be reported as three and a half intervals
shorter than it was. That state is in memory rather than in the database: a restart
forgets an ongoing outage and mentions it once more, which is a reasonable thing to
be told after a restart, and much less machinery than a table whose only purpose is
to suppress it.

`ConnectionMonitorTest` covers the interesting parts with a movable clock and mock
stores: announced once and not on every sweep, recovery only for an outage that was
actually reported, nothing without a subscription, nothing when push is
unconfigured, and a sweep that swallows its own failures — a scheduled task that
throws is never run again, which would silently end all connection alerts for the
lifetime of the server.

#### Branding and PWA

The logo is `server/src/main/resources/META-INF/resources/icons/screwcloud.svg`:
a screw driven into a cloud. The drawing order matters — shaft first, cloud on
top, head last — so the shaft disappears behind the cloud.

The logo's palette is **fixed and does not use `currentColor`**, because it is
shown in an `<img>` element and an external SVG does not inherit the page's text
colour. An inline SVG would be theme aware, but Vaadin's HTML parser lower-cases
attribute names and would break SVG's camelCase (`viewBox`) — the same root cause
as the assertions disabled in the tests.

The PWA is enabled by the `@PWA` annotation on the `AppShell` class.

**`offline` must stay `true`, or web push stops working.** Flow registers the
service worker only when offline is enabled, and actively *unregisters* it when it
is not:

```java
// Flow's BootstrapHandler
if (config.isOfflineEnabled()) {
    // navigator.serviceWorker.register('sw.js')
} else {
    // getRegistration('sw.js').then(r => r && r.unregister())
}
```

Web push needs that service worker — it is what receives the notification and
shows it — so `offline = false` disables notifications in every browser, and the
only symptom is `Cannot get registration from service worker` when someone flips
the switch. That is exactly what happened here, which is why `AppShellTest` now
asserts the flag.

It was off at first out of a worry that a cached view would show a stale
temperature as current. The worry was misplaced: the service worker caches the
application shell, not the measurements, which arrive over Vaadin's own channel at
runtime. Opened with no connection, the app loads its frame and reports that it has
no connection.

A browser that already visited a build with offline off has had its service worker
unregistered; one reload after deploying the fix registers it again.

**The PWA icon is a PNG, not an SVG.** Vaadin loads it with `ImageIO`, which does
not understand SVG. The icon is generated from the same composition with Java2D:

```bash
cd server && java tools/GenerateIcon.java
```

That writes `icons/icon.png` (512×512), from which Vaadin's `build-frontend`
produces every size in the manifest. The SVG is the design source; if the logo
changes, change both.

**Pitfall:** the PWA icons are generated at build time into
`target/classes/META-INF/VAADIN/webapp/pwa-icons/`, and Vaadin loads the
pre-generated icons from there before it looks at `iconPath`. A stale `target/`
therefore serves an old icon — typically Vaadin's blue default, if the icon was
only added after the previous build. The fix is `mvn clean package`. The symptom
is confusing, because `/icons/icon.png` returns the right file at the same time:
that is served by Spring's classpath resource handler, which has nothing to do
with Vaadin's icon generation.

#### Theme tokens

The **Aura** theme is in use. It does not define the `--lumo-*` tokens at all, so
styles referring to them silently have no effect — nothing reports an error, the
style just does not show.

Colours therefore use the `--vaadin-*` tokens, which are theme agnostic and which
Aura defines:

| Use | Token |
|---|---|
| Primary text | `--vaadin-text-color` |
| Secondary text | `--vaadin-text-color-secondary` |
| Spacing | `--vaadin-gap-m` |

Font sizes are given directly in rem, because there is no theme agnostic font
size token: Aura only offers `--aura-font-size-*`.

#### Assertions disabled in tests

`maven-surefire-plugin` is configured with `enableAssertions=false`. The reason is
concrete: Vaadin's `BasicElementStateProvider.setAttribute` contains the
assertion `attribute.equals(attribute.toLowerCase())`, which assumes HTML's
lower-case attribute names. SVG requires camelCase, and `SvgSparkLine` sets the
`viewBox` and `preserveAspectRatio` attributes — so any test that creates a
sparkline fails with an `AssertionError`. Assertions are not enabled at runtime,
so this does not affect how the application behaves.

### Running it

In development, start **`TestServer`** from the IDE (see
[Local development](#local-development-testserver)) — it brings its own PostgreSQL
in Docker.

`mvn` works too, but it runs the plain application, which expects a PostgreSQL of
its own on `localhost:5432`:

```bash
cd server
mvn                      # defaultGoal is spring-boot:run
mvn test                 # needs Docker: the tests use a PostgreSQL container
```

The UI is at <http://localhost:8080/> and UDP reception on port 5555. Both ports
live in `src/main/resources/application.properties`; the UDP port has to match
the device's `SERVER_PORT` setting.

The first start takes minutes, because Vaadin downloads Node.js into `~/.vaadin`
and builds the frontend bundle.

For putting it on a real server, [boot2vm](https://github.com/mstahv/boot2vm) is
what this repository's own instance runs under: `Deploy init` once against a plain
Debian-ish VM, `Deploy` after that, and the VAPID keys and database settings go in
with `Deploy env set` so they never touch this repository. PostgreSQL it does not
install — that is the one piece to arrange yourself. Its `vmhosting.conf` is
already in `.gitignore`. The pi-reader README says more, because there the same
tool is doing a job that is otherwise genuinely fiddly.

### The firmware build page

`/firmware`, linked from under "Add a device" on the front page. Somebody with no
toolchain picks a board, fills in their network, gets firmware built from the
current source, and is shown how to get it onto the board. It exists so that
handing somebody a device does not mean building one per recipient by hand — the
alternative is in [Handing a built firmware to somebody
else](#handing-a-built-firmware-to-somebody-else), which is still what you do
when the server has no toolchain.

**Three boards, and two ways onto them.** The Pico 2 W gets a `.uf2` and the six
steps for dropping it onto the drive the board shows. The ESP32-S3 and ESP32-C3
get their image written **from the browser**: the page opens the board's serial port through the
Web Serial API and drives Espressif's own flasher, `esptool-js`, over it — pick
the port when the browser asks, wait half a minute, and the board restarts with
the new firmware. That works in Chrome and Edge on a computer; Safari and every
phone lack the API, and the page says so and offers the file for `esptool`
instead. The board choice is only asked when the server can build for more than
one — `arduino-cli` is checked for each core at startup, and the list is what it
found.

The ESP32 image is the core's *merged* binary — bootloader, partition table and
application at their offsets, written as one file at address zero — with the
padding trimmed off. The core pads it to the size of the whole flash, four
megabytes of which about a third is firmware and the rest the erased-flash byte,
which flashes correctly and slowly. `MergedImage` cuts the tail back to the last
sector holding anything, so the browser writes a megabyte and a bit rather than
four.

Either way, the page ends with the next step: **"Add XXXX to my devices"**, which
puts the device on this browser's list — the same thing the front page's form
does, picture included — and opens the device's own page, where the first packet
will land. The reader has the identifier in front of them at exactly that moment
and nowhere else; without the button they walk to the front page and type the
same four characters into a form.

Three things it does that a build on your own laptop does not:

- **It suggests a free device identifier.** Four characters from an alphabet with
  `I`, `O`, `0` and `1` left out, because these are read off a 128-pixel display
  across a room. Taken means either a device has reported under it or firmware
  has been built for it — the second half matters, because a device built this
  morning and flashed tonight has sent nothing all day, and without it two people
  asking on the same afternoon get the same identifier.

  An identifier already in use is a **warning and never a refusal**. Building
  again with the same ID is how a WiFi password gets changed and how firmware
  gets updated, and the device's readings and history continue under it — so
  there is nothing to protect anybody from. The sentence is there for the reader
  who typed a neighbour's four characters by accident.
- **It builds one at a time.** A queue of five, a five-minute timeout, and "busy,
  try again in a minute" when it is full — which is an answer rather than an
  error.
- **It forgets the file.** The image carries the WiFi password in clear text, so
  it is deleted when the reader leaves the page, and swept after fifteen minutes
  if a tab was left open. Not on download, as it once was: the second click on
  the same link, and the flasher reading the image the link had already served,
  both found nothing and put a stack trace in the log.

The configuration is written as byte arrays rather than as C string literals —
`{ 0x68, 0x75, ... }` and not `"hunter22"` — so that nothing a reader can type
becomes syntax a compiler would act on. That is the whole security argument for
running a compiler behind a web form, and `ConfigHeader` is the class to read if
you want to check it.

### Building firmware on the server

The firmware build page compiles on demand, so the machine needs the same
toolchain a developer has: `arduino-cli`, a core per chip family — arduino-pico
for the Pico 2 W, Espressif's for the ESP32-S3 and ESP32-C3 — and the libraries
each sketch needs.
This is installed once. If none of it is installed, the feature is simply absent
— the page is not offered and nothing else changes, the same arrangement as the
VAPID keys. If one core is installed and not the other, the page builds for the
board it can and does not mention the other.

Everything below happens **as the user the application runs as**, and that is the
part worth being careful about. Installing the core as root puts it in root's
home, where the service cannot see it, and the symptom is a compile that fails
with a missing platform on a machine where `arduino-cli core list` looks
perfectly correct — because you ran that as yourself.

**1. Room on the disk.** About 1.5 GB for the core and its toolchains, plus
build directories. Less than a postgres, more than people expect.

**2. `arduino-cli`.** One binary, no dependencies. `/usr/local/bin` is the one
step wanting root, and it is worth it: a binary on the path is a binary the
service finds without being told where it is.

```bash
curl -fsSL https://raw.githubusercontent.com/arduino/arduino-cli/master/install.sh \
  | sudo BINDIR=/usr/local/bin sh
arduino-cli version
```

Without root, `BINDIR="$HOME/bin"` works as well and is looked for too.

**3. One directory, and no environment variable.** The core and the libraries go
to `~/.arduino15`, which is arduino-cli's own default and also where the
application looks — so there is nothing to export and nothing that can disagree.
What does need creating is where builds happen:

```bash
mkdir -p "$HOME/screwcloud-builds"
```

Under `$HOME` rather than `/var/lib`, because that is the one directory the
service user certainly owns and can write to without anybody granting it
anything. A path under `/var/lib` needs creating and chowning as root first, and
forgetting that produces a permission error during somebody's first build rather
than during the install — the wrong end of the day to find out. On this
deployment `$HOME` is `/home/r`.

**4. The cores and the libraries.** Several hundred megabytes each, downloaded
once here rather than during somebody's first build. For the Pico 2 W:

```bash
arduino-cli core install rp2040:rp2040 \
  --additional-urls https://github.com/earlephilhower/arduino-pico/releases/download/global/package_rp2040_index.json
arduino-cli lib install "DHT sensor library" "Adafruit Unified Sensor" \
  "Adafruit SH110X" "Adafruit GFX Library"
```

And for the ESP32-S3 and ESP32-C3, which share a core and want one library where
the Pico wants four:

```bash
arduino-cli core install esp32:esp32 \
  --additional-urls https://espressif.github.io/arduino-esp32/package_esp32_index.json
arduino-cli lib install "NimBLE-Arduino"
```

Either one alone is fine. The application looks for each core's directory under
`~/.arduino15/packages` and offers the boards it finds.

**5. Write down what you got, then pin it.**

```bash
arduino-cli core list
arduino-cli lib list
```

Add the versions those print back onto the commands above as `@version`, and
keep them there. Unpinned, the next reinstall quietly picks up a different
compiler and different libraries, and a build that worked in the spring fails in
the autumn for reasons unconnected to anything anyone changed. This is not about
tracking what shipped to whom; it is about the build not moving underneath you.

**6. Prove the whole chain before trusting it.** A real compile, of the real
sketch, as the service user:

```bash
git clone https://github.com/mstahv/screwcloud.git /tmp/fwcheck
cp /tmp/fwcheck/temperature-reader/config.h.example \
   /tmp/fwcheck/temperature-reader/config.h
arduino-cli compile \
  --fqbn rp2040:rp2040:rpipico2w:ipbtstack=ipv4btcble \
  --export-binaries /tmp/fwcheck/temperature-reader
```

A `.uf2` under `build/` means the server can do this. Nothing short of a real
compile does, because every one of the ways this goes wrong — wrong user, wrong
data directory, missing library, a core installed for the wrong architecture —
looks fine until something actually asks the compiler to work.

The same for the ESP32-S3, with the board options the page uses — and once more
with `esp32c3` in place of `esp32s3` for the C3, which is the same sketch on
another target:

```bash
cp /tmp/fwcheck/esp32-reader/config.h.example \
   /tmp/fwcheck/esp32-reader/config.h
arduino-cli compile \
  --fqbn esp32:esp32:esp32s3:CDCOnBoot=cdc,PartitionScheme=huge_app,FlashSize=4M \
  --export-binaries /tmp/fwcheck/esp32-reader
```

This one leaves several files under `build/`; the one the page hands out is
`esp32-reader.ino.merged.bin`, and its being there is the proof.

**7. Restart the application.** There is nothing to configure: it looks for
`arduino-cli` on the path and then in `~/bin` and `/usr/local/bin`, and for the
core in `~/.arduino15`, which is where the steps above put them. It says which
it found, at startup:

```
Firmware builds available: arduino-cli under /home/r/.arduino15, for Raspberry Pi Pico 2 W, ESP32-S3, ESP32-C3
```

or, if the toolchain is not there, one line saying the feature is unavailable
and that everything else is unaffected — and if one core is missing, a line
naming which board is not offered. All are worth a glance the first time.

Only a deployment that put things somewhere else needs to say so, with boot2vm
alongside the VAPID keys:

```bash
Deploy env set ARDUINO_CLI=/opt/arduino-cli/arduino-cli
Deploy env set ARDUINO_DATA_DIR=/opt/arduino-cli/data
```

Spelled out rather than left to `$HOME`, because these are read by a service
whose environment is whatever the deployment gives it, and a home directory that
resolved differently there than in your shell is a confusing afternoon. Set
wrongly, they are a warning in the log at startup rather than a silent absence —
the application treats "nobody installed this" and "somebody pointed me at the
wrong place" as different situations.

`git` is needed too, for the clone the builds come from, and is on any machine
that got this far.

### Testing without a device

```bash
python3 tools/send-test-packet.py
python3 tools/send-test-packet.py --host 10.0.0.5 --device TALO --sensor ULK=-3.2,88.1
```

A different `--device` value exercises the multi-device view:

```bash
python3 tools/send-test-packet.py --device TALO --sensor DHT=21.4,45.0 --sensor SAU=68.2,
```

`PacketDecoderTest` covers the format: negative temperatures, missing values, a
wrong version and a truncated packet. `MeasurementStoreTest` covers the time
window and ordering, `ClientDeviceStoreTest` the per-browser device lists and
identifier normalisation, and `SensorCardLayoutTest` the component reuse.

### Browserless UI tests

The use cases are tested through the views themselves — adding a device, renaming a
sensor, setting bands, starting a counter, seeing a device marked offline — with
Vaadin's **browserless testing**, which runs the real components and routes in the
JVM. No browser, no frontend build, and every Spring bean is the real one against
the container database.

The dependency comes with the Vaadin archetype and its version from the platform
BOM, so it is declared without one:

```xml
<dependency>
    <groupId>com.vaadin</groupId>
    <artifactId>browserless-test-spring</artifactId>
    <scope>test</scope>
</dependency>
```

It is Apache 2 licensed, unlike TestBench's browser-driven half, so it needs no
subscription. `BrowserlessSetup` and `@UiTest` follow the archetype's own example,
with the [Playwright-like
API](https://vaadin.com/blog/a-more-playwright-like-api-for-vaadin-browserless-tests):

```java
ui.navigate(DashboardView.class, "LAHT");
ui.findTextField().withLabel("Name").setValue("Cold room");
ui.findButton().withText("Save").click();
```

Four things about this project made the difference between tests that work and tests
that mislead, and all four cost a debugging round to find:

**`Component.getChildren()` is not what is actually there.** This is the general
lesson and it cost a debugging round: `findRouterLink().withText("LAHT")` finds
nothing while the reader is looking straight at that link, because a `Card`'s title
is slotted. The slotted link *is* a real element child carrying `slot="title"`, and
its `getParent()` points back at the card — but **`Card` overrides `getChildren()`**
to return only its content: five element children, two component children. The
locators walk the component hierarchy, so they stop there. A hand-rolled tree dump
over `getChildren()` has exactly the same blind spot, which is a good way to confirm
a wrong diagnosis.

**`ComponentUtil.getAllChildren(Component)`** (since 25.2) is the one to use instead:
it traverses the element tree and descends into virtual children, so an override
cannot hide anything from it. `Slots.require(card, Button.class)` is built on it, and
the tests no longer need to know that a cog lives in a slot.

The behaviour is the same in **1.1.2**, the newest release at the time of writing, so
this is worth knowing rather than waiting out. For diagnosing it, the library has its
own dump — the one its error messages use:

```java
com.vaadin.browserless.internal.PrettyPrintTreeKt.toPrettyTree(component)
```

Note the `internal` package.

**One window per test, not one per class.** The archetype's example has a single
test method and a singleton `BrowserlessUIContext`; with several methods that means
a shared session and a growing component tree, where an earlier test's hidden
empty-state answers this test's query. The bean is prototype scoped for that reason.

**The tests are `@Transactional`.** They drive the real stores, so the first run
committed rows into the container the slice tests share and broke six store tests
that had nothing to do with the UI. Rolled back, they are repeatable.

**The browser has to be impersonated once.** `ClientId` identifies a browser by a
token in localStorage, and reading it is a round trip that nothing answers when there
is no browser: the callback never fires, and the device list stays empty for reasons
unrelated to the code under test. `Browser.answerAsFirstVisit` completes the pending
script with what localStorage would have returned. Only the subscribed *read* is
answered — completing a fire-and-forget script throws, because there is no success
handler waiting for a value.

Two of these tests exist because the faults they cover shipped: a notification switch
that was invisible without VAPID keys, and a fresh degree-day counter that reported
itself frozen in a warm room. Both were found by hand in a browser, and both are one
assertion here.

Writing them also turned up an accessibility gap: the four temperature limit inputs
had no labels of their own — the caption belongs to the row — so nothing could name
them, a screen reader included. They now carry aria labels, which is what the tests
address them by.

### Notes

The UI refreshes by polling every five seconds. The devices send every five
minutes, so server push is not needed.

## Licence

**GNU Affero General Public License v3.0** — the full text is in [LICENSE](LICENSE).

AGPL rather than GPL for one reason that matters to a web application: section 13
extends the source offer to people who use the software **over a network**, not
only to those who receive a copy of it. Anyone running a modified ScrewCloud as a
service for others has to offer them its source. That is why every page links to
the repository from the header.

The source is at <https://github.com/mstahv/screwcloud>.

## Next steps

- [ ] Verify the SIM7028 AT sequence against real hardware
- [ ] Recovery from network outages, possibly with buffering
- [ ] Pruning old measurement rows once the database starts growing
- [ ] Packet authentication (HMAC), if the data gets a use beyond display
- [ ] Calibrating the sensors against each other. The DHT22 and the RuuviTag
      differ by about 0.7 °C, which is within both tolerances — a reference would
      need either a RuuviTag Pro or a TMP117 breakout on I2C0 (GP4/GP5)
- [ ] **Measuring the meat rather than the air, with two RuuviTag Pros.** The
      degree-day counters integrate air temperature, but tenderising depends on the
      temperature of the meat — and a fresh carcass is at 35–38 °C and takes a day
      or more to cool. The current model therefore under-counts the very phase in
      which the most happens. The idea: one sensor against or inside the carcass,
      one loose in the same room, and read the difference.

      Why **Pro** and not the standard tag: the Pro uses a TMP117 at **±0.1 °C**
      with 0.01 °C resolution and no calibration, against ±0.2 °C for the standard
      tag. The difference between two sensors is the whole measurement here, so the
      tolerance of a standard pair is the same size as the signal.

      No custom hardware needed for the probe: Ruuvi sells an **External
      Temperature Sensor** on a 1 m cable, built on the same TMP117, which is the
      needle-to-the-spine part of the idea off the shelf.

      A trade-off to decide first, though: the **Pro 2in1 is IP68 and IP69K** and
      belongs on the meat side, where the air is wet and condensing — but it has no
      humidity sensor. The **3in1 has humidity and is IP67, explicitly for
      non-condensing locations**, so it belongs in the ambient position. Which means
      the humidity difference and a condensation-proof enclosure against the meat
      cannot both be had.

      What the difference should show:

      - the **cooling curve** of the carcass, whose time constant says something
        about mass and airflow — and which is what would correct the counter's
        early phase
      - **evaporative cooling**: a drying surface reads *below* ambient, so a
        negative difference is a proxy for active moisture loss, and the gap
        closing means the surface has formed its protective crust. Poor man's
        weight loss, without a scale
      - a **persistent positive difference** after everything has equilibrated is a
        warning rather than a curiosity: something is generating heat, meaning
        microbial activity or too little airflow

      Cross-calibrate the pair side by side for a few hours before trusting any of
      it, and record the offset — otherwise unit-to-unit variation masquerades as
      signal. That lesson is already in this project once, in the DHT22 versus
      RuuviTag comparison above.

      Do not leave an inserted probe in for a whole hang: the puncture is a channel
      that carries surface bacteria into the warm interior, which is why core
      temperature is normally measured briefly. Either probe only during the
      cooling phase, when the benefit is largest anyway, or put it somewhere that
      gets trimmed off.

      What the software would need, none of it large:

      - nothing at all to start: counters are already per sensor, so a counter can
        be run on the meat-side sensor today
      - a **reference sensor** setting per sensor, so a card can show the
        difference in temperature and humidity with its own sparkline — that curve
        is where the cooling time constant and the drying slowdown are legible
      - an **offset field** in the sensor settings, so the cross-calibration lives
        in the database instead of on a scrap of paper
      - and, if the meat-side reading turns out to be the better input, an option
        for a counter to integrate that sensor while falling back to air
        temperature when the probe is pulled out
