mstahv/screwcloud/docs/iphone-notifications.md

# Getting a notification on an iPhone before the meat turns into jerky

A walk-through, with pictures, of the whole path for a new user: from a
ScrewCloud page in Safari to a phone that buzzes when the shed is about to be
ready. It exists because of one Apple decision, so let us start there.

## Why this needs a guide at all

Web push notifications work in every major browser — except that on an iPhone
they work only for a web app that has been **added to the Home Screen**. A page
in a Safari tab is not allowed to notify you, no matter how nicely it asks. Apple
introduced this in iOS 16.4 (2023), five years after everyone else, and made sure
nothing on the page can offer the install: there is no prompt, no button a site
can show, and the option lives three taps deep in a menu whose top half is
people you could send the page to.

Whether this is about your battery or about the App Store's thirty per cent is
a question for the courts, and they are on it. Until they finish, the recipe
below is the recipe.

**Android users:** Chrome offers to install the app on its own, and notifications
work from a plain tab too. You can skip to [step 7](#7-switch-notifications-on);
everything from there on is the same.

## 1. Open the menu in the address bar

Open the site in Safari. At the bottom, in the address bar, tap the **☰** icon
to the left of the address. Not the share arrow — there is no share arrow here
any more; iOS 18 put it inside this menu.

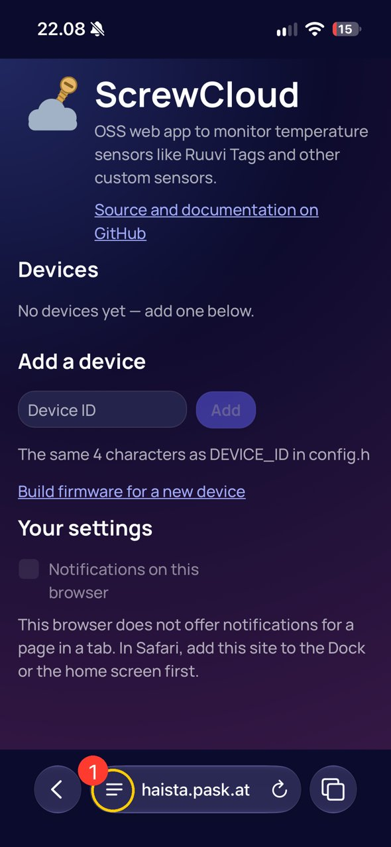
[picture p2: docs/iphone/01-safari-menu.jpg]
Safari with the menu icon in the address bar highlighted


Notice the message under **Your settings**: the page already knows it cannot
notify you from a tab, and says what to do about it.

## 2. Share — with yourself

Tap **Share**. The name is odd for what we are about to do, but this is where
Apple keeps it.

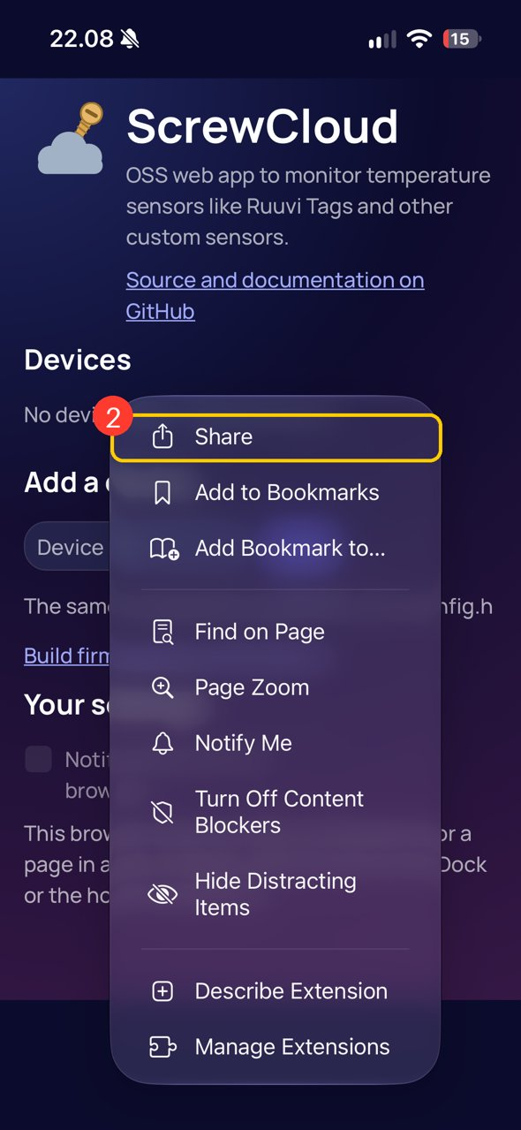
[picture p3: docs/iphone/02-share.jpg]
Safari's page menu with Share highlighted


## 3. Look past the people

The share sheet opens with your contacts and your apps. The thing we want is not
among them. Scroll the bottom row of round buttons and tap **View More**.

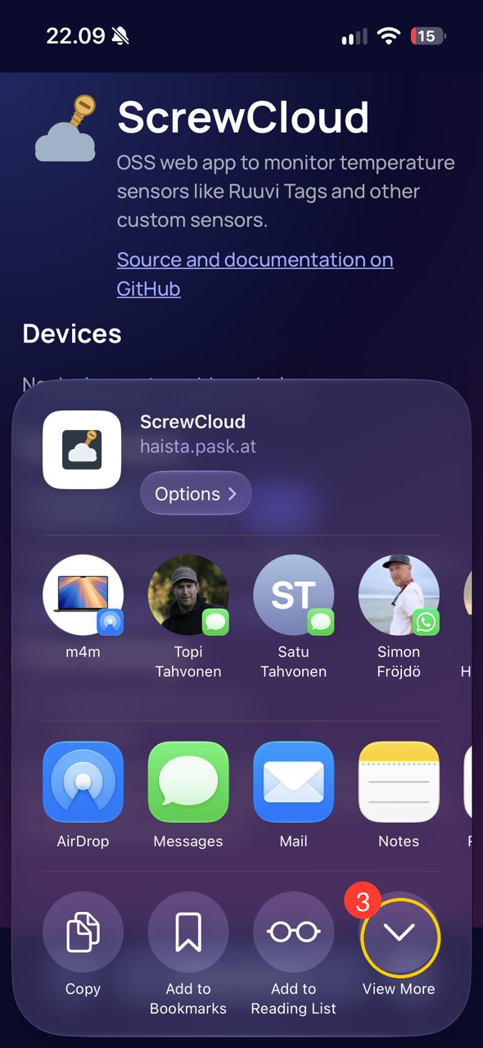
[picture p4: docs/iphone/03-view-more.jpg]
The share sheet with View More highlighted


## 4. Add to Home Screen

There it is, at the very bottom: **Add to Home Screen**.

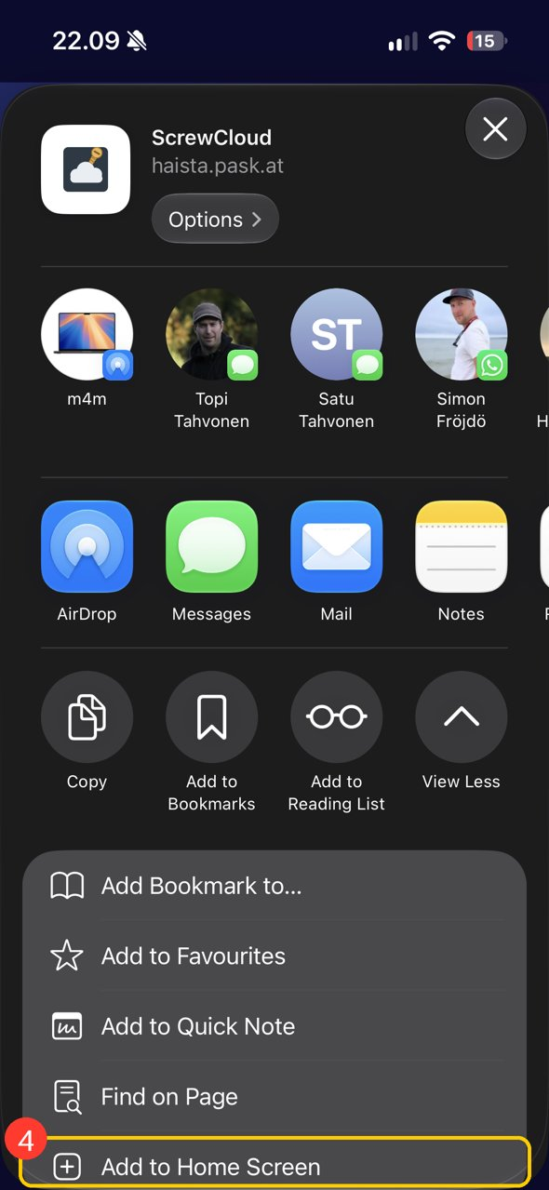
[picture p5: docs/iphone/04-add-to-home-screen.jpg]
The expanded share sheet with Add to Home Screen highlighted


## 5. Confirm

A dialog shows the icon and the name; change the name if you like. Leave **Open
as Web App** switched on — that is the setting this whole exercise is about, and
iOS turns it on by itself. Tap **Add**.

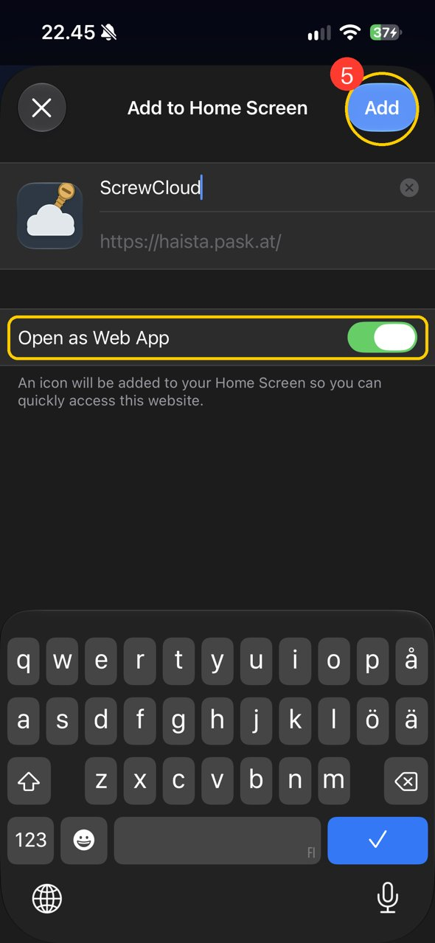
[picture p6: docs/iphone/05-confirm-add.jpg]
The Add to Home Screen dialog with the Add button highlighted and the Open as Web App switch marked


## 6. Open the icon, and start from scratch

A ScrewCloud icon appears among your apps. **Close Safari and open that icon
from now on.** It is the same site, but iOS treats it as a separate app — and
that is the whole trick: this one is allowed to notify you.

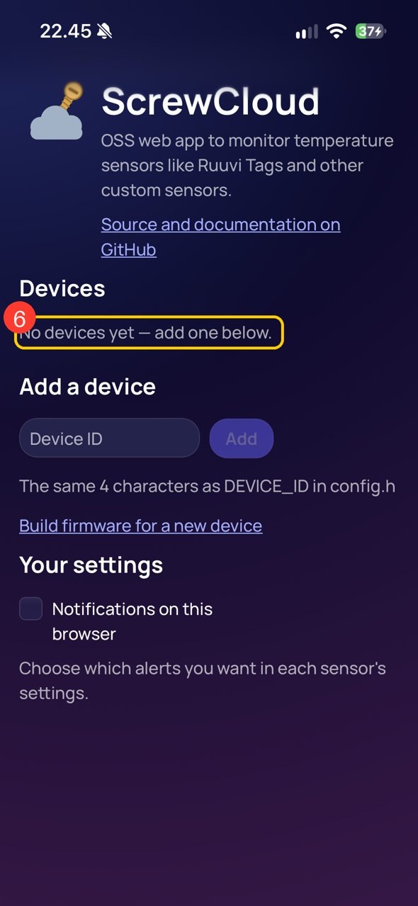
[picture p7: docs/iphone/06-fresh-start.jpg]
The installed app opening with no devices listed


It opens empty, and that is not a fault: the Home Screen app is a separate
browser with its own memory, so devices you added while still in Safari are not
here. Add them again by their four-character ID — and notice that the message
under **Your settings** has changed. In Safari it explained why notifications
were not on offer; here it simply tells you where to choose them.

## 7. Switch notifications on

Scroll down to **Your settings** and tick **Notifications on this browser**.

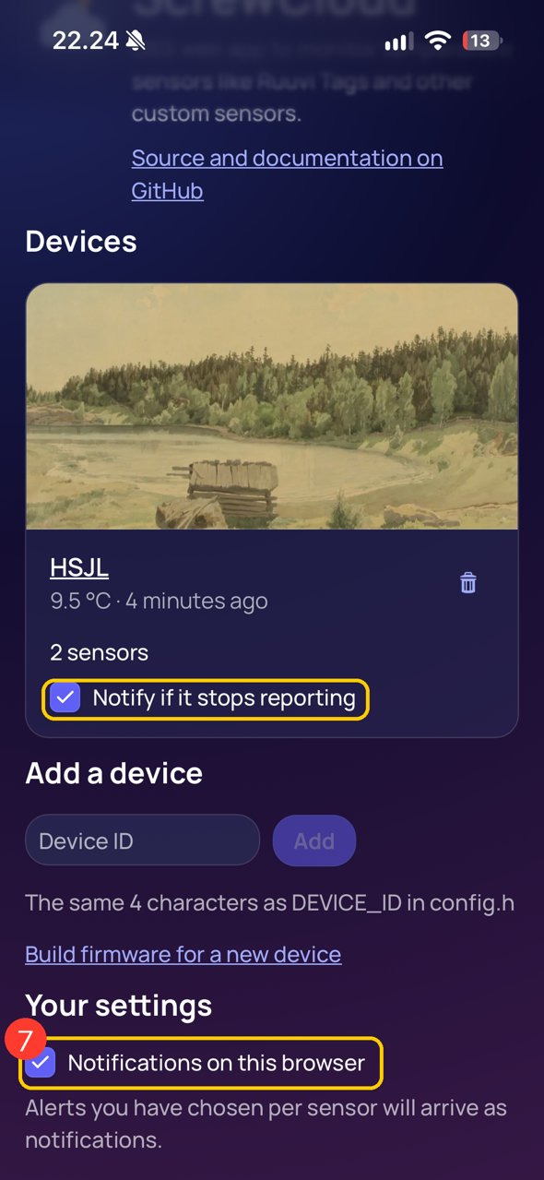
[picture p8: docs/iphone/07-notifications-on.jpg]
The installed app with Notifications on this browser and Notify if it stops reporting highlighted


iOS asks whether ScrewCloud may send notifications. Say **Allow**. This is the
one question the phone asks in the whole process, and it asks it only once: if
you refuse, the switch moves to Settings → Notifications → ScrewCloud, like any
app's.

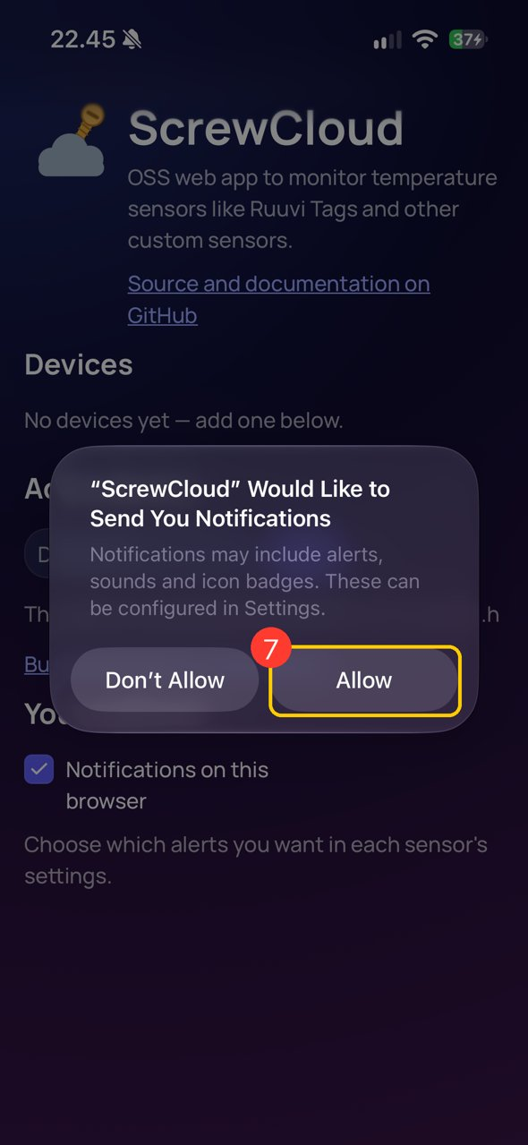
[picture p9: docs/iphone/07-allow.jpg]
The iOS permission prompt with Allow highlighted


While you are here: **Notify if it stops reporting** on the device's card, also
highlighted two pictures up, tells you when the device itself goes quiet — a dead battery, a router someone
unplugged — which is a different thing from the temperature being wrong, and
worth knowing before a weekend.

## 8. Open the sensor's settings

Tap the device to open it. Each sensor is a card; tap the **cog** on the card of
the thermometer that hangs where the meat hangs.

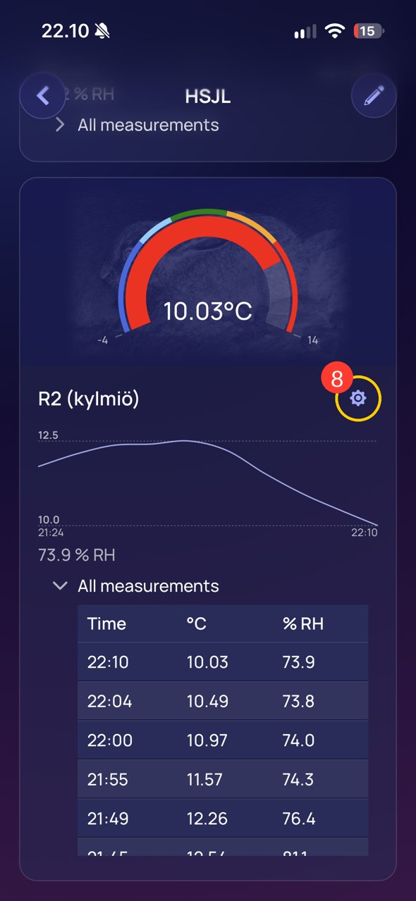
[picture p10: docs/iphone/08-sensor-settings.jpg]
A sensor card with the settings cog highlighted


The settings hold a name for the sensor, the temperature bands that colour the
gauge, and — under **Notify this browser when** — the alerts about the
temperature itself: too warm, too cold, back to normal. Tick what you want and
press **Save**. Those are the alerts for a thermometer; the counter below is the
one for the meat.

## 9. Start a degree-day counter

Under **Degree-day counters**, write what is hanging (a date in the name helps
when there are two), leave the target at 40 °Cd unless you know better, and tap
**Start**. The counter starts from now — unless you set **Hung since** to the
day and hour the meat actually went up. Every reading since then is already
stored, so a counter remembered on Tuesday for a Saturday's carcass appears with
three days already counted.

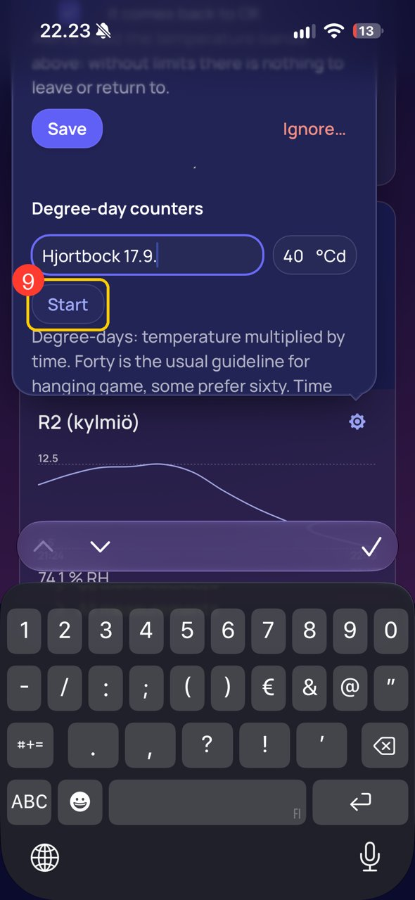
[picture p11: docs/iphone/09-start-counter.jpg]
The degree-day counter form with the Start button highlighted


Degree-days are temperature multiplied by time: five days at +8 °C and eight
days at +5 °C are the same forty. Time below freezing counts for nothing, and
above +10 °C you should be worrying about bacteria rather than tenderness. Forty
is the usual guideline for game; some prefer sixty for more flavour.

## 10. Choose what the counter tells you

The running counter shows its own two notifications, both on by default: **a day
before** the target, judged from the current temperature, and **when reached**.
Untick what you do not want. Changes here save themselves; there is nothing to
press.

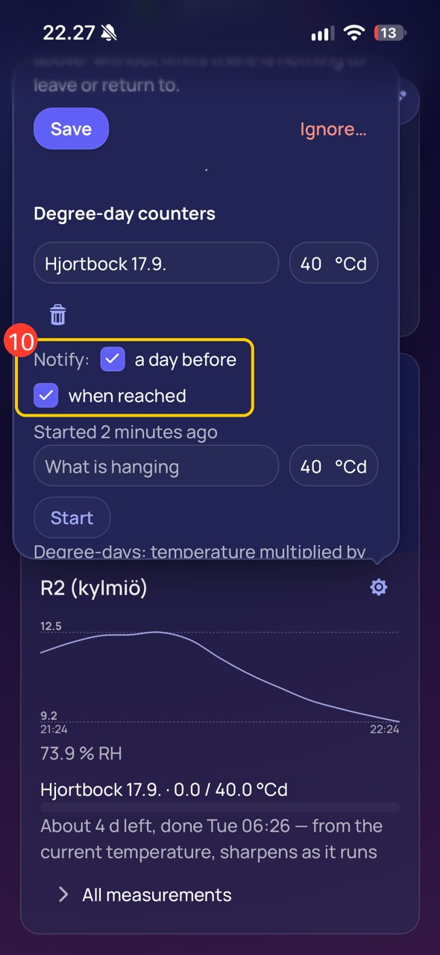
[picture p12: docs/iphone/10-counter-alerts.jpg]
A running counter with its two notification choices highlighted


## 11. Watch it on the card

Close the settings. The card now carries the counter: the sum so far against the
target, and a forecast — *about 4 days left, done Tuesday morning*. The
forecast is what you actually came for; it sharpens as the counter gathers its
own readings.

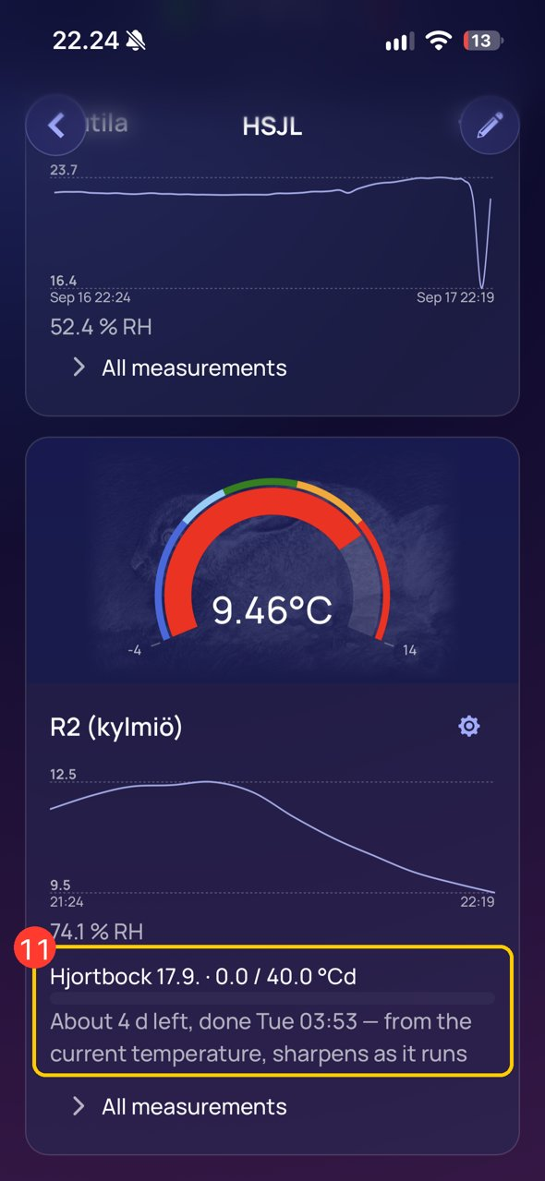
[picture p13: docs/iphone/11-counter-on-card.jpg]
The sensor card with the counter and its forecast highlighted


When the target is passed the card says so with a green badge and keeps
counting, because the meat is still hanging until you take it down. Stop the
counter from the cog when it does.

## What arrives, and when

| Notification | When |
|---|---|
| *About a day left* | the forecast says the target is about 24 hours away |
| *Target reached* | the sum passes the target |
| temperature alerts | the sensor crosses a band you set, and again when it comes back |
| *Stopped reporting* | the device has been silent for longer than its usual interval |

Each one is sent once — a counter that passed its target on Tuesday does not
announce it again on Wednesday. Notifications are per phone: two people watching
the same shed each choose their own, but the counter itself is shared, because
what hangs there is a fact and not a preference.

## If nothing arrives

- **Are you in the app?** Notifications never arrive for a page open in Safari, and
  the switch there says so. Open the Home Screen icon.
- **Did iOS get its answer?** Settings → Notifications → ScrewCloud must allow them.
- **Is the phone in Focus?** A Focus mode silences web apps like everything else.
- **Is the server able to notify at all?** If the switch under Your settings is
  missing altogether, the server has not been given its push keys — see the README
  under *Web push notifications*.
