mstahv/screwcloud/pi-reader/src/main/resources/META-INF/resources/media/capercaillie.webp

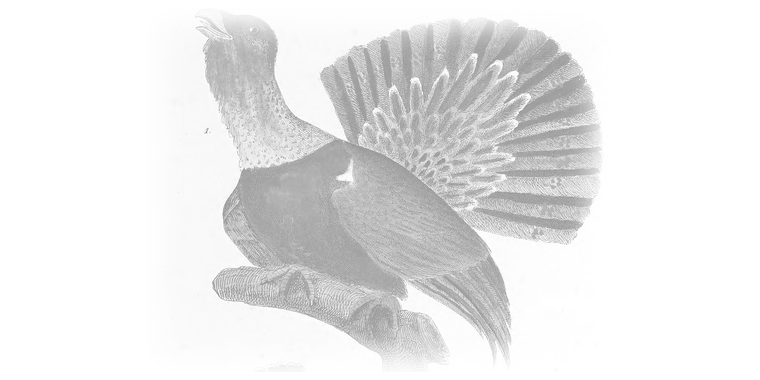
pi-reader/src/main/resources/META-INF/resources/media/capercaillie.webp
