mstahv/screwcloud/pi-reader/src/main/resources/META-INF/resources/media/hare.webp

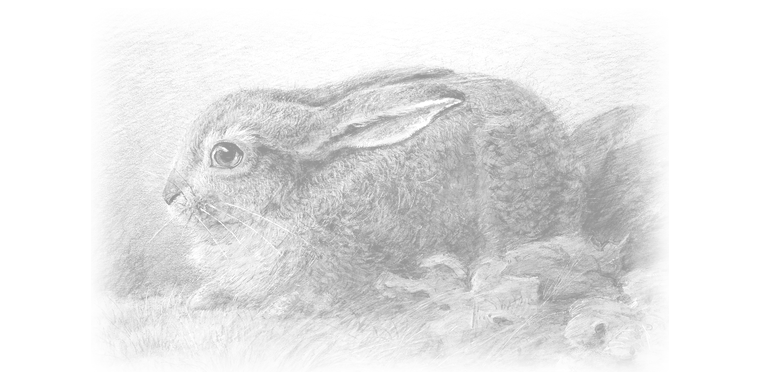
pi-reader/src/main/resources/META-INF/resources/media/hare.webp
