mstahv/screwcloud/pi-reader/src/main/resources/META-INF/resources/media/moose.webp

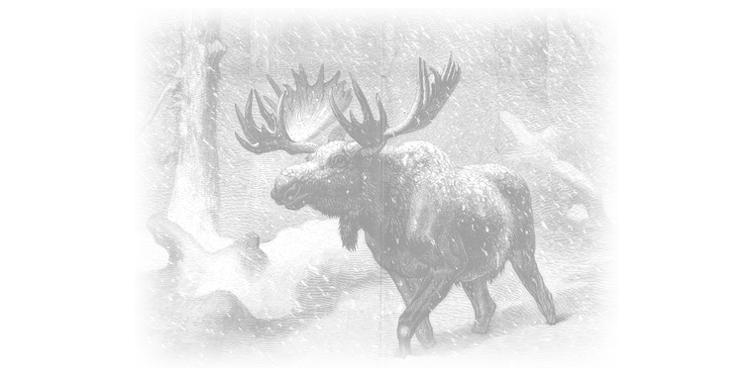
pi-reader/src/main/resources/META-INF/resources/media/moose.webp
