mstahv/screwcloud/pi-reader/src/main/resources/META-INF/resources/media/roe-deer.webp

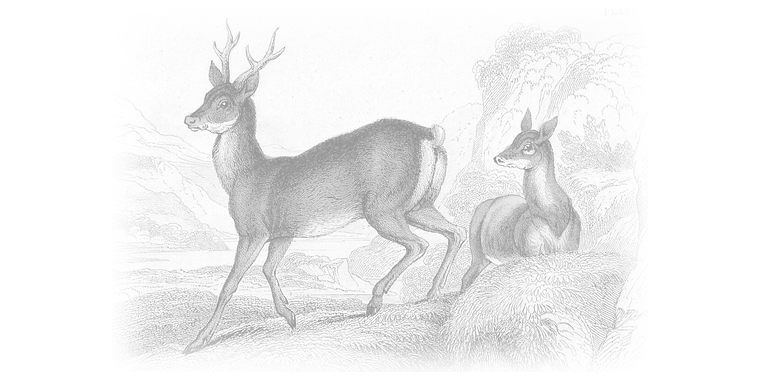
pi-reader/src/main/resources/META-INF/resources/media/roe-deer.webp
