mstahv/screwcloud/server/src/main/resources/META-INF/resources/media/buildings/barn.webp

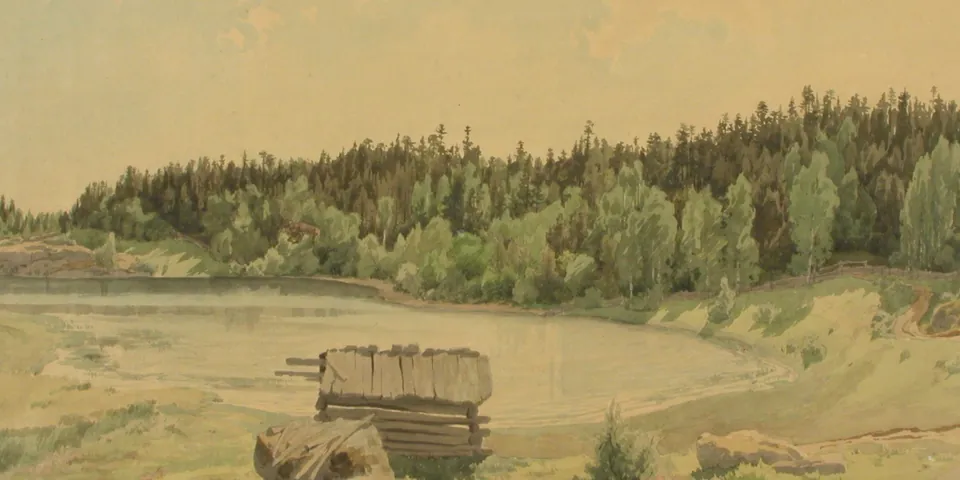
server/src/main/resources/META-INF/resources/media/buildings/barn.webp
