mstahv/screwcloud/server/src/main/resources/META-INF/resources/media/buildings/croft.webp

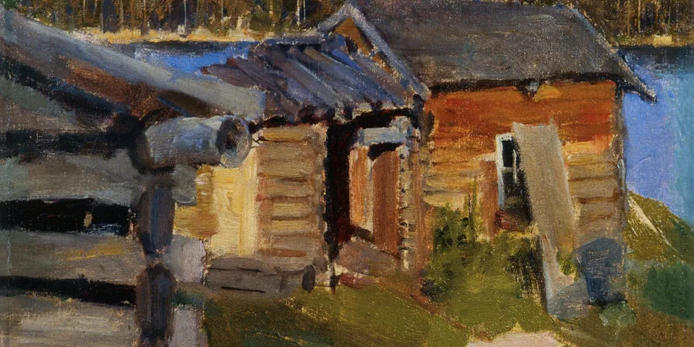
server/src/main/resources/META-INF/resources/media/buildings/croft.webp
