mstahv/screwcloud/server/src/main/resources/META-INF/resources/media/buildings/farmhouse.webp

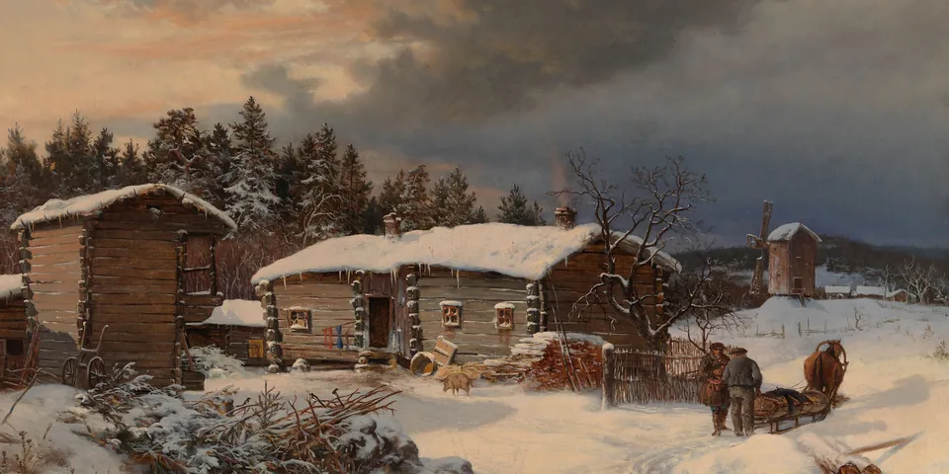
server/src/main/resources/META-INF/resources/media/buildings/farmhouse.webp
