mstahv/screwcloud/server/src/main/resources/META-INF/resources/media/buildings/sauna.webp

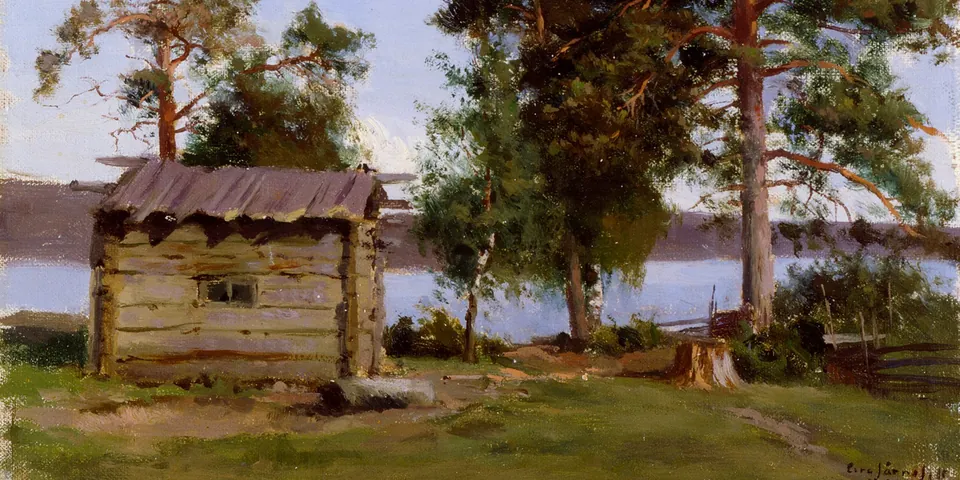
server/src/main/resources/META-INF/resources/media/buildings/sauna.webp
