mstahv/screwcloud/pi-reader/src/main/java/org/vaadin/example/ui/SensorCard.java

package org.vaadin.example.ui;

import java.time.Duration;
import java.time.Instant;
import java.util.List;
import java.util.Locale;

import com.flowingcode.vaadin.addons.relativetime.Format;
import com.flowingcode.vaadin.addons.relativetime.Precision;
import com.flowingcode.vaadin.addons.relativetime.RelativeTime;

import com.vaadin.flow.component.badge.Badge;
import com.vaadin.flow.component.badge.BadgeVariant;
import com.vaadin.flow.component.button.Button;
import com.vaadin.flow.component.button.ButtonVariant;
import com.vaadin.flow.component.card.Card;
import com.vaadin.flow.component.card.CardVariant;
import com.vaadin.flow.component.dialog.Dialog;
import com.vaadin.flow.component.html.Span;
import com.vaadin.flow.component.icon.VaadinIcon;
import com.vaadin.flow.component.textfield.TextField;
import com.vaadin.flow.dom.Style;


import in.virit.TemperatureGauge;

import org.vaadin.firitin.components.button.DeleteButton;
import org.vaadin.firitin.components.button.VButton;

import org.vaadin.example.history.HistoryPoint;
import org.vaadin.example.names.IgnoredSensors;
import org.vaadin.example.ruuvi.AirReading;
import org.vaadin.example.names.SensorNames;
import org.vaadin.example.sensor.Reading;

/**
 * One tag's card: the temperature on a gauge, its curve under that, and the
 * humidity and the age below — the curve first because it is about the number
 * the gauge is already showing, and a line of text between the two separated
 * halves of one thought. The same order as the server's cards.
 *
 * Previously: the temperature on a gauge, the humidity and the age under it,
 * and the last day as a curve.
 *
 * <p>Built to match the server's sensor card, from the same gauge and the same
 * sparkline, because the two are looked at by the same person about the same
 * sensor. What is missing here is what this application does not have: no
 * thresholds colouring the gauge, no alert settings, no degree-day counters.
 *
 * <p>A card is created once per tag and updated through {@link #update}. Rebuilding
 * it every five seconds would make Vaadin resend the whole structure; swapping a
 * number is a fraction of that.
 *
 * <p>Colours come from the {@code --vaadin-*} tokens, which every theme defines.
 * The {@code --lumo-*} ones do not exist in Aura, so a style naming them silently
 * does nothing.
 */
class SensorCard extends Card {

    /** Past this, the reading is still shown but its age is marked. */
    private static final Duration QUIET = Duration.ofMinutes(1);

    private final TemperatureGauge gauge = new TemperatureGauge();

    private final SecondaryLine humidity = new SecondaryLine();

    /*
       When the reading arrived, rendered by the browser rather than by us. The
       component takes an instant and says "2 minutes ago" in the reader's own
       language, and keeps saying the right thing between updates — which the string
       we used to build could not: it was written when the page last heard anything
       and was wrong by however long it had been sitting there since.

       Wrapped in a line of its own because the component is a bare custom element
       with no styling of its own; the wrapper is what makes it secondary text.
    */
    private final RelativeTime heardAt = new RelativeTime();
    private final SecondaryLine age = new SecondaryLine();

    /** The same instant as a duration: "Nothing heard for 2 hours". */
    private final RelativeTime silentFor = new RelativeTime()
            .setFormat(Format.DURATION)
            .setPrecision(Precision.MINUTE)
            .setNoTitle(true);

    /*
       The same badge the server marks an offline device with, rather than a colour
       of my own: there is no theme agnostic token for "this is wrong", and the
       --lumo-* ones do not exist in Aura, so a style naming them would silently do
       nothing and the warning would simply not appear.
    */
    private final Badge quiet = new Badge();
    private final SecondaryLine airQuality = new SecondaryLine();
    private final TemperatureSparkLine sparkLine = new TemperatureSparkLine();

    private final String sensorId;
    private final SensorNames names;
    private final IgnoredSensors ignored;
    private final Runnable onChanged;

    SensorCard(String sensorId, SensorNames names, IgnoredSensors ignored, Runnable onChanged) {
        this.sensorId = sensorId;
        this.names = names;
        this.ignored = ignored;
        this.onChanged = onChanged;

        addThemeVariants(CardVariant.OUTLINED, CardVariant.COVER_MEDIA);
        setMaxWidth("22rem");
        setWidthFull();
        applyName();

        setHeaderSuffix(new RenameButton());

        /*
           The gauge goes in the media slot, which is what that slot is for: a
           visual belonging to the card rather than part of its text.
        */
        gauge.setWidthFull();
        setMedia(gauge);

        quiet.addThemeVariants(BadgeVariant.ERROR);
        quiet.setVisible(false);
        /*
           setContent rather than setText: the duration is a component now, and a
           Badge holds one thing — so the words and the component go in together as
           one span.
        */
        quiet.setContent(new Span(new Span("Nothing heard for "), silentFor));

        age.add(heardAt);

        add(sparkLine, humidity, airQuality, age, quiet);
    }

    void update(Reading reading, List<HistoryPoint> history, Instant now) {
        // Null included: the gauge draws "no reading" itself, as an empty dial.
        gauge.setTemperature(reading.temperature());

        humidity.setText(Readings.format(reading.humidity(), "%.1f %% RH"));

        /*
           A Ruuvi Air carries more than the two numbers every sensor has, and
           the headline pair gets a line: CO₂ is what people buy the device for,
           PM2.5 is the health number. The rest of what format 6 carries (VOC,
           NOx, luminosity, sound) waits until somebody actually wants it on a
           card. Hidden entirely for the sensors that are not one.
        */
        if (reading instanceof AirReading air) {
            airQuality.setText(airLine(air));
            airQuality.setVisible(true);
        } else {
            airQuality.setVisible(false);
        }

        /*
           A tag that has gone quiet keeps its reading — an hour old is still the
           last thing known about that room — but it must not look like it was
           measured a moment ago.
        */
        boolean stale = reading.isOlderThan(QUIET, now);
        heardAt.setDateTime(reading.receivedAt());
        silentFor.setDateTime(reading.receivedAt());
        age.setVisible(!stale);
        quiet.setVisible(stale);

        sparkLine.setHistory(history);
    }

    /** How many motifs the stylesheet has. */
    private static final int MOTIFS = 4;

    /**
     * Gives this card its background motif, from its position among the sensors on
     * screen.
     *
     * <p>The same arrangement as the server's card, and for the same reason: the
     * picture is there so somebody knows which sensor they are looking at without
     * reading the name, which only works if no two on the page share one and if none
     * of them changes between visits. Position in a list sorted by sensor id gives
     * both, as long as there are no more sensors than motifs.
     *
     * <p>No device offset here, unlike the server. There is only one device on this
     * page — this machine — so there is nothing to tell apart.
     *
     * @param position this card's index among the sensors, sorted by id
     */
    void setMotif(int position) {
        getElement().setAttribute("data-motif", String.valueOf(Math.floorMod(position, MOTIFS)));
    }

    /**
     * The title is the name if one was given, otherwise the identifier.
     *
     * <p>When a name takes the title, the identifier moves to the subtitle rather
     * than disappearing: it is what this sensor is called on the server and in the
     * packets, so it is the word that connects what is on this screen to what is
     * on that one. Without a name the two would be the same string twice.
     */
    private void applyName() {
        String name = names.displayName(sensorId);
        setTitle(name);
        setSubtitle(name.equals(sensorId) ? null : new Span(sensorId));
    }

    private class RenameButton extends VButton {
        RenameButton() {
            super(VaadinIcon.PENCIL);
            addThemeVariants(ButtonVariant.TERTIARY, ButtonVariant.SMALL);
            setAriaLabel("Rename this sensor");

            addClickListener(click -> new RenameDialog().open());
        }
    }

    /**
     * The one thing this page edits: what a sensor is called.
     *
     * <p>An empty value is how a name is removed — the card then shows the
     * identifier again, as the field's helper below the input says.
     */
    private class RenameDialog extends Dialog {

        private final TextField field = new TextField();

        RenameDialog() {
            setHeaderTitle("Name for " + sensorId);

            field.setPlaceholder("Cold room");
            field.setValue(names.nameFor(sensorId).orElse(""));
            field.setWidthFull();
            // Straight into the dialog: it is already a container with padding.
            add(field);

            /*
               The dialog's delete button, harnessed: the destructive act on
               this page is not deleting data but asking not to see it — the
               neighbour's tag is the textbook case. Viritin's DeleteButton
               carries its own confirmation, so the handler runs only once the
               reader has said they mean it.
            */
            DeleteButton ignoreButton = new DeleteButton("Ignore…", () -> {
                ignored.ignore(sensorId);
                close();
                onChanged.run();
            });
            ignoreButton.setConfirmationPrompt(
                    "Ignore %s?".formatted(names.displayName(sensorId)));
            ignoreButton.setConfirmationDescription("Its card disappears from this "
                    + "page. The tag is still heard, stored and relayed, and it can "
                    + "be restored from the Ignored sensors list below the cards.");
            ignoreButton.setOkText("Ignore");

            getFooter().add(ignoreButton,
                    new Button("Cancel", click -> close()),
                    new Button("Save", click -> save()));
        }

        private void save() {
            names.rename(sensorId, field.getValue());
            applyName();
            close();
            onChanged.run();
        }
    }

    /** The air in one line; a dash where a sensor is still warming up. */
    static String airLine(AirReading air) {
        return "CO\u2082 %s · PM2.5 %s".formatted(
                Readings.format(air.co2(), "%.0f ppm"),
                Readings.format(air.pm25(), "%.1f µg/m³"));
    }

    /**
     * One line of a sensor's readings. Block display because these are spans in the
     * card's content slot, and each belongs on a line of its own.
     */
    private static class SecondaryLine extends SecondaryText {
        SecondaryLine() {
            getStyle().setDisplay(Style.Display.BLOCK);
        }
    }
}
