mstahv/screwcloud/(commit log)

2026-08-10 initial version
    ScrewCloud: temperature monitoring from RuuviTags and wired sensors,
    reported over UDP to a self-hosted Spring Boot + Vaadin server.
    Firmware for the Pico 2 W (RuuviTags, DHT22, OLED, WiFi or NB-IoT, the
    chip's own temperature) and a minimal ESP32-S3 variant, both speaking the
    same fixed-size binary packet. The server decodes it, stores measurements
    in PostgreSQL with Flyway, and shows per-sensor cards with a gauge, a
    24 hour curve and the readings behind them. Temperature bands can raise
    web push notifications when a reading changes band.
    Claude-Session: https://claude.ai/code/session_016CKnKNs3PD8jD9BjT7rjnp
2026-08-10 Notify when a device stops reporting
    The one failure the rest of the system cannot see: every other alert is
    triggered by an arriving packet, and a device whose power or network is
    out sends nothing at all while its last reading sits in the UI looking
    fine. So this one is driven by a scheduled sweep instead.
    The reporting interval is learned rather than configured — the median gap
    between recent arrivals, which ignores the occasional lost send — and a
    device counts as silent after three missed reports plus half an interval
    of slack. The same rule feeds the notification and the offline badge in
    the UI, so the page and the phone cannot disagree.
    Subscriptions live on client_device, which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
2026-08-10 Degree-day counters for hanging game
    Temperature multiplied by time, in vuorokausiastetta, with forty as the
    usual guideline: +8 °C for five days and +5 °C for eight are the same
    thing. Two rules from the practice shape the arithmetic — frozen meat
    does not tenderise, so time below zero contributes nothing, and it does
    not subtract either.
    The sum is a trapezoidal integral from the counter's start, gaps
    interpolated rather than skipped, and HeatSumTest checks it against the
    guideline's own examples. The forecast is what the card leads with: the
    sum alone does not answer "should I be there on Saturday".
    Several counters per sensor, each with a comment, so two carcasses hung
    on different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
2026-08-10 Fix a fresh counter reporting itself frozen
    A counter started in a warm room said "not accumulating — below
    freezing". Two mistakes met: with a single reading HeatSum returned no
    rate at all, and the card read a missing rate as a frozen shed.
    The rate for a single reading is now the temperature itself, which is the
    best estimate available and the only one until the next packet five
    minutes later. And the card tells the two cases apart — an empty rate
    means no readings yet, a rate of zero means it really is frozen.
    Reproduced by three tests first: they failed with NoSuchElementException
    on the missing rate.
    Claude-Session: https://c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
2026-08-10 Forecast a brand-new counter from the current temperature
    A counter is younger than the device's send interval for its first few
    minutes, so nothing has arrived since it started and the card had nothing
    to say but "waiting for the first reading". The sensor's latest reading is
    a straight answer to how fast it is going, so it is used as a fallback.
    Labelled where it is shown — "from the current temperature, sharpens as it
    runs" — because one reading is not a measurement of a trend. And the
    notifications ignore such an estimate: extrapolating a target from a
    single reading is fine on a card someone is looking at, not as a reason to
    make a phone buzz.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
    [SensorCard.java]
2026-08-11 Test the use cases through the UI, browserlessly
    Vaadin's browserless testing drives the real views, routes and components
    in the JVM against the container database: adding and removing a device,
    renaming a sensor, saving and refusing temperature bands, starting a
    degree-day counter, and a device marked offline. The dependency comes with
    the archetype and its version from the platform BOM.
    Four things had to be understood first, each of which cost a round:
    Component.getChildren() is what a component chooses to expose, not what is
    there. A Card overrides it to return only its content, so its slotted
    title, cog and remove button are invisible to the locators — and a
    hand-rolled dump over g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
2026-08-11 Restructure the front page and drop the invented styling
    The front page read as heading, add form, notification switch, empty
    state, cards — so "Devices" headed a form, and a per-browser setting sat
    in the middle of the content. It is now three regions in the order they
    are needed: the devices under their own heading, adding one, and your
    settings. The reading order is asserted in a test, since it is the point
    of the layout and the next edit to the constructor would not know that.
    All three section headings are the same level, because they are siblings;
    "This browser" became "Your settings"; and the switch says "Notifications"
    rather than "Temperature alerts", which named one of the three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
2026-08-11 Check the protocol sync in Java instead of bash
    The repository had three languages for four tools. This removes one: the
    protocol check becomes a jbang script, next to the two single-file Java
    tools already here.
    The rewrite is not a translation. The shell version grepped for the
    expected text ("temperature = rawTemperature * 0.005f") in both sketches,
    which made the checker a third copy of the wire format — changing the
    scaling in both firmwares broke the check until someone edited the
    checker too, and reformatting a line broke it while nothing had
    diverged. Every check now extracts a value from each sketch and compares
    the two against each other, reporting both on a mismatch instead of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
2026-08-11 Make the protocol sync check a test instead of a tool
    A check that has to be remembered is a comment. As ProtocolSyncTest in
    the server module it runs with mvn test, which is where a divergence
    between the two firmwares will actually be noticed.
    The server module now reads the firmware sources from its sibling
    directories. That coupling is the price, and it is affordable: the
    repository is checked out as a whole, so the sketches are there. The test
    walks up from the working directory to find them, so it does not care
    whether it is started from the module or the repository root.
    The checks themselves are unchanged from the jbang script this replaces,
    minus the diff library. A JUnit failure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
2026-08-12 State the validation rules once, with Bean Validation
    Validation was thin at both ends and where it existed it was hand
    written: SensorThresholds.validate() threw IllegalArgumentException,
    ClientDeviceStore.normalise() checked length and emptiness on the way
    past, and the UI turned whichever exception came back into a toast. The
    entities said nothing at all, so the only thing between an
    unauthenticated UDP packet and the measurement_sample table was the
    decoder's frame check.
    The rules are now Bean Validation constraints in a validation package,
    and they are read from both ends: Hibernate runs them before every
    insert and update, and the forms read the same annotations to mark a
    field requi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
2026-08-12 Stop writing the length limits twice
    Three fields set a maxlength that the constraint beside them already
    stated. The binder now passes those on, so the annotation is the only
    place @Size(max = 64) is written, and a test pins that down where a
    reader would notice it: the name field stops at 64 characters because of
    the record it is bound to, not because this form said so.
    Two are kept by hand and say why. The counter's target is @Positive,
    which is strict where a field's minimum is inclusive, so the binder
    leaves it alone and one degree-day is set here instead. The device
    identifier's limit comes from @DeviceId, a constraint of this
    application's own — @Size would say it too, but that sam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
2026-08-13 The settings form binds the domain values, not their parts
    The four temperature limits were four fields on the form, and the three
    alert choices three checkboxes, so what the form collected had to be
    flattened into eight components and reassembled on the way out. The
    class level rule about the limits was then stated a second time on that
    flat record, reaching the real one through a shared interface.
    They are two CustomFields now, each editing the record the store already
    takes, so the form binds a name, a SensorThresholds and an
    AlertPreferences. @Valid carries the check into SensorThresholds, which
    has always said its four limits increase — one statement of the rule, on
    the type it belon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
    [SensorCard.java]
2026-08-14 Getting worse is announced at once, getting better has to last
    A field morning: seven notifications in an hour from one sensor, because
    the temperature was sitting exactly on a warning limit and crossing it
    every few minutes. Every crossing was a band change, and every band
    change was news.
    Now only the ones going the wrong way are. A calmer band is announced
    once the sensor has not been seen in the announced one for an hour. On
    that morning's readings the rule gives one notification instead of eight,
    and the first one arrives on the first crossing, as it always did.
    The clock measures how long ago the sensor was last in the band the
    reader was told about. Wandering between calmer bands do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
2026-08-14 Show the Ruuvi tags before the box's own sensor
    The tags are the measuring points somebody placed deliberately; the DHT22
    is wherever the box happens to sit. With more sensors than the three rows
    the OLED has, that is the one to lose.
    Tags that have gone quiet come last of all, after the DHT22, so a tag that
    has stopped sending can never push a still-reporting sensor off the screen.
2026-08-14 Separate the sensor's identifier from the name a reader sees
    One string was doing two jobs: the key the server ties readings to and the
    title on the OLED. They pull opposite ways — a key wants to be unique and
    permanent, a title wants to be legible — and the display was winning, which
    is why identifiers were capped at three characters and why the screen read
    like machine output.
    The key is now derived from the MAC and from nothing else: R plus the low
    twelve bits, four thousand values where the last byte alone gave 256 and two
    tags in eight collided about one time in ten, silently. RUUVI_NAMES no longer
    feeds it, so renaming a measuring point cannot split a sensor's history.
    The title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
    [esp32-s3-reader.ino, temperature-reader.ino]
2026-08-14 Hold the front page to not complaining before it is used
    The Add a device form opened with "Give the device identifier" already in
    red, on a first visit, before the reader had reached the field. The cause was
    in the binder — it recognised a required constraint by its message, so a
    constraint worded for the reader was not recognised at all — and is fixed
    there. These two say what this page expects of it: an untouched field asks
    with the required indicator, and a field the reader empties is told about.
2026-08-14 Report the chip temperature as device status, not as a measuring point
    The CPU reading had a card of its own, which gave it the standing of a place
    somebody chose to measure: a heading, a 24 hour sparkline, threshold settings
    and alert subscriptions. None of that is wanted for a die temperature that
    reads 10-20 C above the air and moves with the load rather than the weather.
    It goes on the line that already carries the device's own state:
    Updated 4 min ago . sequence 2 . CPU 42.7 C
    Every reading is still stored, so the history is there if it is ever wanted.
    A device that overrides INTERNAL_SENSOR_ID gets an ordinary card again — the
    packet carries nothing that would tell a chip from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
2026-08-14 Recover from a modem that stopped answering, and say what went wrong
    A device sent nothing for an hour and showed only "FAIL! last ok 46 min",
    while the server logged "Unknown protocol version 65" every five minutes.
    65 is the letter A, and the only bytes this firmware ever begins with an A
    are AT commands.
    AT+CIPSEND takes the length up front and then swallows exactly that many
    bytes, whatever they are. Miss the ">" prompt — one slow answer during a
    network hiccup is enough — and the module is left counting, so the next
    cycle's "AT+CIPSEND=..." is handed to it as the payload. It sends that text
    to the server and nothing ever recovers, because every attempt feeds the
    mouth it is trying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
    [Transport.h, temperature-reader.ino]
2026-08-14 Show the first bytes of a packet that could not be decoded
    "Unknown protocol version 65" is true and nearly useless. 65 turned out to
    be the letter A, from a modem that had been fed an AT command as a payload
    — but the number alone does not say that, and a stray packet off the
    internet looks exactly the same in the log.
    The first 24 bytes now go with it, as hex and as the printable characters
    beside it, so what sent it is recognisable at a glance:
    Invalid packet from /93.106.183.202: Unknown protocol version 65
    [15 bytes: 41 54 2B 43 49 50 53 45 4E 44 ... | AT+CIPSEND=0,16]
    Truncated, because a flood of junk on an open UDP port must not become a
    flood of log.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
2026-08-14 Add a Java reader for a Raspberry Pi that is already there
    A third reader beside the two firmwares, speaking the same protocol to the
    same server: Quarkus, Vaadin, bluez-dbus. It exists because a Pi is often
    already doing something else in the house, and because a reader on the same
    network as the tags can keep showing the temperature when the internet does
    not.
    One page, the same Aura theme and the same cards the server draws — the
    same gauge and the same sparkline, from the same libraries. No database:
    the last day of readings lives in memory, sampled once a minute, and the
    names of the measuring points in a hidden CSV in the home directory.
    The identifier a tag reports under is derive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
2026-08-14 Summarise a device by a measuring point, not by its own chip
    The one line under a device name in the front page list showed whichever
    sensor the packet listed first. With the chip temperature enabled that is
    often the chip — a diagnostic that reads 10-20 C above the air around it,
    so a device in a cold room was summarised as a warm one.
    The reading shown is now the first RuuviTag, then anything else, and the
    chip only when it is all there is. A tag is a place somebody chose to
    measure and is what the list is being scanned for; a wired DHT22 measures
    air, just wherever the box happens to sit; the chip measures the box.
    A tag is recognised by the identifier every reader derives the same wa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
2026-08-14 Do not count the chip's own temperature as a sensor
    "2 sensors" on the front page for a device whose dashboard showed one card.
    The chip temperature is the box reporting on itself, not a place anyone
    chose to measure, and it is already shown on the device's status line
    rather than as a card.
    Unless it is the only thing there is. A board that measures nothing but its
    own die is still a device worth listing, and "0 sensors" would read as
    broken rather than as minimal.
2026-08-14 Add a sleeping Pico that reports only its own die temperature
    An experiment with one question behind it: is the RP2350's on-chip
    temperature close enough to the air around it to be worth reading? If it
    is, the cheapest sensor in this repository is a bare Pico 2 W with nothing
    wired to it at all.
    The cycle is wake, measure, radio on, send, radio off, sleep. The order is
    the experiment: the die is coldest the moment it wakes, and everything
    after the measurement heats it — connecting to WiFi takes seconds and is
    by far the largest part of a wake. Measuring first is what makes the
    reading about the room rather than about the work.
    The transport is behind an interface with one implementation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
2026-08-14 Give the chip a card when it is all a device measures
    A board that reports nothing but its own die temperature had a status line
    and an empty page: the chip is left off the cards everywhere else, because
    it is a diagnostic about the box rather than a place anyone chose to
    measure.
    That is still the rule, and this is the exception it needs. A device whose
    only reading is the chip is a device whose one reading is what it is for.
    It gets an ordinary card, counts as one sensor rather than none, and the
    status line stops repeating the number — the same value twice on one screen
    reads as two readings that happen to agree.
    The question is asked in one place now. Three views were deciding what t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
2026-08-14 Keep the radio on long enough for the packet to leave
    A reading was logged as sent and never reached the server. endPacket()
    returning success means the datagram was handed to the network stack, not
    that it has left the antenna: a first packet on a fresh connection waits
    for an ARP reply, and this device was powering the radio down a
    millisecond later, throwing the packet away in the queue.
    The radio now stays on for a moment after the hand-over. UDP offers no
    acknowledgement to wait for, so waiting is the honest remedy, and it costs
    a fraction of the seconds the connection itself took.
    The server's name is also resolved explicitly now. A name that will not
    resolve is a different failure f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
    [Transport.h, pico-sleeper.ino]
2026-08-14 Correct what the waiting costs, and settle the ADC before reading
    Two corrections and a measurement.
    delay() on this core does not spin: it calls the SDK's sleep_ms(), which
    halts the processor on a WFE until the timer alarm. Sleep.h and the README
    said the processor keeps running, and used that to explain why the chip
    would not cool between readings. It is wrong, and the explanation built on
    it was wrong with it. What still costs is the clocks, the PLLs and the
    peripherals — which is what dormant mode would switch off, and why that
    remains the next step rather than this.
    The temperature reading now throws away two conversions before averaging.
    This reading is taken at the one moment in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
    [Sleep.h, pico-sleeper.ino]
2026-08-14 Sleep with the SDK's low power library instead of delay()
    pico-sdk 2.3.0 added pico_low_power — the thing whose absence Sleep.h
    described at length. arduino-pico bundles that SDK from 5.7.0, so it is
    available in an ordinary Arduino build, with official examples and, better,
    Raspberry Pi's own measured numbers for a Pico 2 from 3V3:
    sleep 6.9 mA
    dormant 3.7 mA
    Pstate, SRAM0 on 0.14 mA
    Pstate, all SRAM off 0.08 mA
    This uses sleep, the lightest of the three, because it is the only one that
    leaves the program running: low_power_sleep_for_ms() returns where it was
    called and keeps the USB serial alive, so the experiment can still be
    wat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
2026-08-14 Define the linker symbols the core leaves out of pico_low_power
    arduino-pico 6.0.0 ships the compiled pico_low_power library from SDK
    2.3.0, but its linker script does not define the two symbols that library
    expects around a persistent data section — the section is created by an SDK
    CMake function, and an Arduino build has no CMake. Linking any sketch that
    sleeps fails with:
    undefined reference to `__persistent_data_start__'
    undefined reference to `__persistent_data_end__'
    Nothing to install: the gap is in the packaging. Both places the library
    uses those symbols are safe when they are the same address —
    low_power_persistent_pstate_get reads that as "no persistent data" and
    ret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
    [Sleep.h]
2026-08-14 Make the second linker symbol with .set, which GCC will accept
    The alias attribute refuses this: an alias has to be a declaration, and a
    variable with a body is a definition, so GCC reports the symbol as defined
    both normally and as an alias.
    The assembler has the operation this actually needs — .set gives one name
    the value of another — and that is what a linker alias is. The byte itself
    stays declared in C so the compiler allocates and aligns it.
2026-08-14 Leave lr1121-java out of this repository
    It is a repository of its own now: a radio driver is useful well beyond
    this project, and it will be published separately.
    Ignored rather than added as a submodule. Nothing here builds against it
    yet, and a gitlink pointing at commits that exist on one laptop is a
    promise this repository cannot keep.
2026-08-15 A Pico that transmits, so the receiver has something to hear
    The far side of the link lr1121-java listens to. Its parameters deliberately
    match Smoke's "waveshare" preset, which are in turn Waveshare's own
    example's: there is no negotiation in LoRa and no error when two ends
    disagree, so a mismatched spreading factor and a missing antenna look
    exactly alike. Both ends identical first, one change at a time afterwards.
    Two values are the board's rather than the radio's, and both are the sort
    that produce a transmitter reporting success while radiating nothing: the
    3.0 V oscillator, where the library defaults to 1.6 V for a different
    module, and the antenna switch table, where this board carri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
    [lora-node.ino]
2026-08-15 Keep the transmitter talking when it cannot start
    The first run showed nothing at all on the serial monitor, which is the one
    outcome the sketch could not explain. If begin() failed it said so once and
    then looped in silence — and a Pico re-enumerates its USB after an upload,
    so that one line went out before the host had opened the port.
    A board that fails loudly and a board that is not running now look
    different. setup() waits for the port to be opened rather than for time to
    pass, the failure repeats every two seconds instead of once, and the
    initialisation is announced before it is attempted so that a hang inside it
    is visible as a hang rather than as silence.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
    [lora-node.ino]
2026-08-15 Give the oscillator the time this module wants, then retry
    begin() failed with -707, RADIOLIB_ERR_SPI_CMD_FAILED: the chip took the
    command and could not execute it. Which is progress rather than a fault —
    SPI, BUSY, RESET and MISO all work, or the error would have been -2 or -705.
    The soldering is fine.
    RadioLib powers the TCXO and calibrates against it five milliseconds later.
    Waveshare's own driver allows this module 300 ticks of 30.52 us, about nine —
    and a calibration against an oscillator that has not settled fails, which the
    chip reports as a failed command.
    There is no way to hand begin() a longer startup, so the oscillator is given
    one between attempts instead: a failure leave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
    [lora-node.ino]
2026-08-15 Turn on RadioLib's tracing, and write down what the codes mean
    Five attempts, all -707, so the oscillator's settling time was not the
    cause. Rather than guess at the next one, this enables the library's own
    debug output: it prints the step it is on, and after a failed calibration it
    reads the chip's error register and prints that — which is the one thing an
    error code cannot carry.
    build_opt.h is enough to do it. The Arduino IDE passes its contents to the
    compiler, so there is nothing to configure in the IDE and nothing to
    remember to undo elsewhere.
    DEBUGGING.md records what the codes point at, and in particular that -707 is
    proof the electrical side works: begin() reads the chip's vers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
2026-08-15 Ask the chip what went wrong instead of guessing
    The debug build did not produce output, and rather than fight the toolchain
    for it the sketch now reads the chip's own error register itself. RadioLib
    exposes getErrors(), and its bits are the thing an error code cannot carry:
    which block refused to calibrate, and whether either oscillator started.
    -707 leaves six candidates between standby and calibration. This narrows it
    to one, and names it: HF_XOSC_START means the TCXO, PLL_LOCK means the
    synthesiser, IMG_CALIB means the image calibration and so on.
    The chip is put in standby before being asked. It reports no errors while it
    is doing something else, and a clean answer at the wrong moment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
    [lora-node.ino]
2026-08-15 Publish getErrors through a subclass, since RadioLib keeps it protected
    The compile failed: getErrors is protected. A derived class may publish what
    its base declared protected, which is three lines and needs nothing from the
    build.
    The alternative was RADIOLIB_GODMODE, a build flag that opens the whole
    library at once — and build flags have already proved to be the part of this
    toolchain that quietly does not apply.
    [lora-node.ino]
2026-08-15 Ask whether the chip has firmware at all, and give it time to wake
    getErrors() failing with -707 too rules out everything I had been
    suspecting: a register read cannot fail because of an oscillator, a
    calibration or an antenna. What it does match is a chip in bootloader mode,
    which answers a version query and refuses every other command — and
    RadioLib's findChip() accepts a bootloader as "found", so begin() gets past
    detection and fails on the first real thing it asks for.
    So the sketch now prints what the chip says it is. 0x03 is an LR1121 in
    normal mode; 0xDF is a bootloader, and no wiring or timing will help.
    It also tests the other idea in the same run, since it costs nothing: the
    wa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
    [lora-node.ino]
2026-08-15 Read the chip by hand, because the library's detection proves nothing
    getVersionInfo() failing with -707 is the fact that undoes my last three
    explanations. findChip() calls exactly that, and it appeared to succeed — but
    findChip returns bool, and RADIOLIB_ASSERT returns the error code from it, so
    a failed read comes back as (bool)(-707), which is true.
    There has therefore never been any evidence that this chip answered
    correctly. The bootloader theory, the oscillator theory and the calibration
    theory were all built on a detection that did not happen.
    So the sketch now reads the version with no library in the way: two bytes
    out, five back, chip select and busy driven directly. The answer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
    [lora-node.ino]
2026-08-15 Send alternately with both antenna switch tables, and say which
    The Pi's receive path is proved: pulling its antenna stopped reception, so
    the antenna is connected to the radio and doing its work. That makes the
    missing ninety decibels a transmit problem, and the transmit side is the one
    where I had to guess.
    Waveshare configures the switch numerically — receive on RFSW0, transmit on
    RFSW1 — and translating that into RadioLib's form meant assuming RFSW0 is
    DIO5 and RFSW1 is DIO6. Nothing has confirmed it. Backwards, transmission is
    routed to the port with no antenna on it, which loses about ninety decibels:
    the exact figure measured across this link.
    So rather than reflash to test a gu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
    [lora-node.ino]
2026-08-15 Let the node listen, so the link can be tested in the other direction
    The swapped switch table produced nothing at all, which settles that
    question: the vendor's mapping was right and the antenna switch is not the
    missing ninety decibels.
    What is left untested is this end's antenna. The Pi's was proved by pulling
    it and watching reception stop; nothing has proved the Pico's, and it is the
    one variable that would explain a transmitter that reaches only leakage.
    Reversing the link answers it without transmitting into a port that may have
    nothing on it. The Pi's transmit path assumes nothing — it configures the
    switch numerically, as the vendor does — and its antenna is known good. So
    if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
    [lora-node.ino]
2026-08-15 Actually branch on the listen flag in loop()
    The flag was declared, the listening function was written, setup() announced
    it — and loop() transmitted regardless. The edit that was supposed to add the
    branch searched for text that a previous commit had already rewritten, and a
    string replacement that finds nothing changes nothing and says nothing.
    The check afterwards showed one use of the flag where there should have been
    two, and I read past it. Worth the note: an edit is not applied because it
    was made, and the cheapest confirmation is to look at the function rather
    than at the diff.
    [lora-node.ino]
2026-08-15 Select the amplifier the board is wired to, not the one the power implies
    Both directions of the link were about ninety decibels down, and the two
    ends were configured by different code — this sketch by RadioLib, the Pi by
    my own driver. A software fault would be unlikely to land identically in
    both. What they had in common was the board, and the answer is in the
    vendor's power table.
    That table selects the high power amplifier at every level from -9 to +22
    dBm, without variation. A board that never uses its low power output is a
    board whose low power output goes nowhere — and asking for 14 dBm the
    ordinary way selects exactly that one, on both ends, in both libraries. The
    radio then tr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
2026-08-15 Let the packet say its own length
    Reception reported zero bytes at a healthy signal strength, which is a
    packet that was heard and then measured wrong. The length parameter of
    receive() is what a receiver expects in implicit header mode, not the size
    of the buffer it has available — and passing the buffer size told the
    library to expect sixty four bytes of a packet carrying seven.
    The length is in the header here, so the parameter is zero and the packet
    answers for itself.
    [lora-node.ino]
2026-08-17 Send over LoRa when a radio is wired to the board
    The Transport interface was written for a second implementation and this is
    it: a Core1121 on SPI1, reaching a Raspberry Pi running pi-reader, which
    relays the bytes onward untouched. A node out of WiFi range therefore still
    appears on the server as itself.
    Which radio is decided by TRANSPORT in config.h, and USE_AUTO — the default —
    asks the SPI bus rather than trusting a flag. That question cannot be
    delegated to RadioLib, whose findChip() returns a bool and whose error macro
    does return(state), so a failed version read comes back as (bool)(-707),
    which is true.
    The probe has to retry, which is the part that was wrong first time round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
    [LoraTransport.h, pico-sleeper.ino]
2026-08-17 Hear two more kinds of sensor: LoRa nodes, and a Thingy:52
    Both arrive by routes the Bluetooth scanner does not have, and neither needed
    the registry, the history, the cards or the packet to learn anything about
    them — everything downstream now works on a Reading, and Ruuvi's sequence
    number, movement counter, battery voltage and pressure stay on RuuviReading
    where the scanner that understands them can use them.
    LoRa is a relay rather than a reader. The bytes that arrive over the air are
    the bytes that leave in the datagram, so a device out of WiFi range appears
    on the server as itself rather than as readings attributed to this machine,
    and nothing on the server had to be taught anything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
2026-08-17 Take viritin 3.8.0 from Maven Central
    The server was on 3.8.0-SNAPSHOT, which only resolved because a checkout of
    flow-viritin sat beside these projects and had been installed locally. With
    the release out there is nothing left for that checkout to do, so it is gone
    and both projects name a version anyone can resolve.
    pi-reader moves from 3.7.0 at the same time, so the two agree.
2026-08-17 Say which groups the LoRa radio needs, and that usermod is the way
    Four of them, and only two are about this radio. The kernel wants spi for
    /dev/spidev0.0 and gpio for /dev/gpiochip0; dialout and i2c are Pi4J's, which
    registers its providers as one batch and refuses the batch unless the user is
    in every group any of them might want. i2c was found the hard way, after Pi4J's
    own message named only gpio and dialout.
    And SupplementaryGroups= does not work for these, which is the trap worth
    writing down: Pi4J reads the group database looking for the user's name rather
    than asking what groups the process is running with, so the unit file satisfies
    the kernel and not Pi4J. It stays for bluetooth,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
2026-08-17 Take the LoRa driver from pi4j-drivers
    The driver has a better home than a repository of its own beside this one:
    pi4j-drivers collects exactly this kind of thing, and after the Pi4J
    refactoring it fits that project's conventions without argument. So the
    dependency moves, and lr1121-java stops being something anyone has to build
    locally before this will compile.
    The wiring comes back here as a consequence, and that is the right place for
    it. Drivers in that project take the bus and the lines they need and know
    nothing about which pins those came from, so the pin numbers, the 2 MHz baud
    and the two GPIO settings that are easy to get wrong — a reset line created
    high, inputs created with no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
2026-08-17 Say only which pins the radio is on
    The driver grew a way in that asks for the wiring and sets the rest itself, so
    fifty lines of SPI and GPIO configuration here become six that name four pins.
    What went away was not boilerplate — it was three settings this file had no
    business choosing, two of which are wrong by default and fail silently.
    The LoRa parameters go the same way: defaults() and two withers, rather than
    eight positional arguments with two adjacent booleans in the middle.
2026-08-17 Open the radio with a constructor
    The driver's builder became a constructor, because the wiring is not optional
    and a builder made it look that way. One line now, and one that does not compile
    without every pin.
2026-08-17 Add a script that runs the LoRa link test on two devices
    The driver project's checks can be run over SSH now, but a link test is not one
    command — it is a listener that has to be up before anything is sent, two logs to
    collect and one verdict to draw from them. That choreography is what this is.
    Nothing is installed on the devices beyond a JRE: the classes and jars are built
    here and rsynced. Maven on a Pi is slow enough to discourage running the test at
    all, and a test that is tedious is a test nobody runs.
    The five second pause before transmitting is not padding. The receiver has a Pi4J
    context to build and a radio to configure before it is listening, and sending into
    that gap is the e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
2026-08-17 Say that the LoRa driver needs a local build for now
    The driver is a pull request against pi4j-drivers rather than something on Maven
    Central, so pi-reader will not build from a fresh clone without that branch
    installed locally. That was true and undocumented, which is the worst
    combination: the failure is a missing artifact, and nothing on hand says which
    one or where to get it.
    git clone -b lr11xx-lora-driver https://github.com/mstahv/pi4j-drivers.git
    mvn -f pi4j-drivers/pom.xml install -DskipTests
    It is said in three places, because there are three ways to arrive at the
    problem: the README for somebody starting out, the pom next to the dependency
    itself for somebody reading a bu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
2026-08-17 Say what this is for before saying what is in it
    The README opened with a repository listing, which answers "what are these
    directories" for somebody who has already decided to read it. It did not answer
    why anyone would. The three things that make this worth building were all in
    there and all buried: NB-IoT was one clause in a bullet, the cheapest build was
    the last item on a list, and the public server people can point at in the first
    five minutes was ninety lines down under a heading about demos.
    So they lead now, each as a claim with the specifics attached rather than an
    adjective: one board and a USB charger; WiFi or NB-IoT chosen at boot, sixteen
    bytes every five minutes, which is the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
2026-08-18 Show what a relayed packet says, not only that one went past
    A node out of WiFi range reaches the server through this reader, and the page in
    front of the reader said nothing about it beyond a line of log. The bytes were
    forwarded and forgotten, so a thermometer sat unread inside them while the local
    page — the half of this application that has to keep working when the server
    cannot be reached — showed nothing but "16 bytes arrived".
    So the packet is decoded here too, into readings that get cards like any other
    sensor. The relay itself is unchanged: bytes() still goes upstream untouched, and
    anything that does not look like one of ours is still relayed while staying off
    this page, becau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
2026-08-18 Make both pages hold together on a phone, and stop writing times into them
    Read on a phone, most of what this theme did well fell apart, and each failure
    had a cause worth naming rather than a number worth nudging.
    A view set to setSizeFull() is exactly the height of the window, so its bottom
    padding sits one screenful down — in the middle of the content — and everything
    past that runs to the end of the document and stops dead against it. Measured
    with three sensor cards: document 1092 px, last card's bottom edge 1092 px, the
    page's own margin waiting at 780. It reads as a page cut in half by a bug, which
    is a fair description. A minimum height instead of a fixed one keeps what full
    hei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
2026-08-18 Tell the pages instead of letting them ask
    Both views polled every five seconds. That is twelve requests a minute from every
    open browser to be told, almost always, that nothing had happened — and up to five
    seconds of a packet sitting on the server before anyone saw it. The cost is
    proportional to how many people are looking rather than to how much is happening,
    and the delay is worst exactly when somebody is standing next to a sensor waiting
    for their change to appear.
    Now the arrival pushes. The UDP thread stores a packet and says so; the pages
    showing that device are updated from there, through UI.access so the work arrives
    holding the session lock like any other UI code. A page nobod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
2026-08-18 Ask the browser what it can do before telling it to do it
    A local run logged this at ERROR, with a stack trace:
    Unexpected error: Unable to execute web push command. JS error is
    'TypeError: undefined is not an object (evaluating
    'registration?.pushManager.getSubscription')'
    Nothing had gone wrong. Flow's registrationStatus reaches for
    registration.pushManager, and the front page asks it on every visit to find out
    whether this browser is subscribed — so a browser that does not offer web push
    answers by throwing, and the server logs it as an unexpected failure.
    There are two ordinary ways to be that browser and they need different things
    said. A page served over plain HTTP to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
2026-08-18 Give the settings popover room and a colour of its own
    Three things, none of them about the form inside it, and all three visible the
    moment it is opened on a phone.
    It was the wrong white. Aura gives an overlay a surface a step above the page,
    which reads as raised on the dark scheme and as a hole on the light one — the page
    is already pale and the fields inside are white, so the panel and the inputs were
    the same colour and only the field outlines said where anything was. It takes the
    card's own tone now, and the edge and the shadow are what say it is above the page.
    On the dark scheme it goes a step lighter than the card instead, because there
    "above" is lighter, and a popover the colo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
2026-08-18 Let the rows in the settings form break where they should
    The popover fits its screen now, but the rows inside it did not fit the popover: a
    text field, a number field and a button standing side by side are wider than a
    phone, so the counter row ran under a scrollbar with its button off the right-hand
    edge. The limit rows were within a few pixels of the same thing, and went over it on
    the narrowest phones.
    They wrap now, and what matters is where they break. Left as loose siblings, a
    wrapping row breaks wherever it runs out of room — which put the dash and the second
    limit on different lines, a range with its halves separated, which is the one thing
    the dash is there to prevent. So the pa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
2026-08-19 Name the pieces instead of configuring them at every call site
    A review of the UI code against the principle it was supposed to follow: structure
    comes from small named classes, so that building a view reads as a list of what is
    on it rather than as setter calls interleaved with what they are for.
    The clearest failure was the settings form's rows. A helper method grouped "the
    target and the button that acts on it" so they would wrap as a pair — a requirement
    nobody had, since at these widths it hardly matters where the row breaks — and the
    two call sites then wrapped the result in near-identical HorizontalLayouts, four
    setter calls each. All of that is now one class, FieldRow: a row of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
2026-08-19 Let every form say it is part of a page, once
    RowForm moves up from a private class inside the counter form to the thing all four
    bound forms extend, and it absorbs the second piece of boilerplate they shared: the
    abstract getFormComponents() that every custom-content form declined with an empty
    five-line override — one of them carrying a javadoc apologising for it. RowForm
    answers it once and redeclares createContent() abstract instead, so what a form has
    to say is what it looks like, not that it refuses a default it never uses.
    The settings form's content Div goes from size-undefined to full width and no
    height in the move. Inside a popover the two are the same thing — the inner layou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
2026-08-19 Try the Viritin form-embedding proposals for real
    The proposals in viritin-form-proposals.md are now code: a checkout of
    flow-viritin lives beside the modules (gitignored — it is its own repository,
    branch form-embedding, one commit on master), built locally as 3.8.1-SNAPSHOT,
    and this module runs against it. The pom says how to build it, the same way it
    already says so for the pi4j-drivers branch.
    What the tryout shows is the proposals doing their work in the code that
    motivated them. RowForm is gone: asSection() in each form's constructor says
    what its two setter calls and their comment used to, and the empty
    getFormComponents() overrides simply stopped being required. The counter
    start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
2026-08-19 Give pi-reader the same review the server got
    The follow-through the earlier pass left half done on this side. The server
    module got one SecondaryText that the named classes extend; here StatusLine and
    SecondaryLine each still wrote "this text is secondary" themselves. They keep
    their names and what those names add — a status line is a step smaller, a
    reading line is a block — and the colour comes from the one class that says only
    how supporting text looks.
    And the rename dialog was the method-shaped version of the thing this codebase
    builds as classes: renameDialog() assembling a Dialog inline, its save logic a
    lambda inside a footer call. It is a RenameDialog now, with a save() that r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
2026-08-19 Say how this actually gets onto a Pi, and onto a server
    The READMEs explained how to build and what the process needs, and stopped at
    the moment that decides whether somebody without a Java toolchain gets this
    running at all: how the artifact ends up on the machine and stays running. Both
    deployments here go through boot2vm — the gitignored vmhosting.conf was its
    config all along — and nothing said so.
    pi-reader gets the full treatment, because that is where the tool earns it:
    install, Deploy init, Deploy, with the answers that fit a Pi on a home network
    and the configuration going in through Deploy env set — including
    JDK_JAVA_OPTIONS for the native-access flag the LoRa driver needs,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
2026-08-20 Let the offline badge own being offline
    DashboardView's offline badge was a plain Badge whose behaviour lived in three
    places: its variants and initial visibility in the view's constructor, the
    show-or-hide decision and the wording inside refresh(), and another hide in the
    no-measurements branch. The wording is UI logic — which two durations to say and
    what to answer when the rhythm is not known yet — and it sat in the middle of a
    method that is about refreshing a page.
    It is an OfflineBadge now, the same move DeviceLinkCard already made: the
    defaults in its constructor, show(DeviceActivity) and hide() as its API, and the
    reasoning in its javadoc — shown only when the device is not re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
2026-08-20 Facts was guarding against a stretch that was never the default
    setAlignItems(START) on the card's fact column restated the component's own
    stylesheet: vaadin-vertical-layout ships align-items: flex-start, so the badge
    was never going to stretch into the coloured bar the comment warned about. The
    comment was reasoning from flexbox's stretch default rather than from what the
    component actually sets — checked this time from the base styles, the same way
    the constructor defaults were.
    The alignment calls that remain are all on horizontal layouts, whose base
    styles set nothing — there flexbox's stretch really is the default, and
    BASELINE on a field row or CENTER on a checkbox row is a decis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
2026-08-20 Let the device list be the floating row it was configured into
    deviceCards was a FlexLayout taught, in three lines, to be a wrapping row with
    the theme's gap — which is what Viritin's HorizontalFloatLayout is by
    declaration: wrapping and baseline alignment come with the class, the gap
    between cards is a HorizontalLayout's own spacing, and a wrapping row needs no
    width of its own, since wrapping against whatever it is given is the whole job.
    The one real change hiding in the swap is the alignment. FlexLayout left the
    cards on flexbox's stretch, so the cards in a row were silently equalised in
    height; the float layout aligns them by first baseline, which for cards is the
    title line. Checked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
2026-08-20 Say in the markup that the front page has three sections
    Devices, adding one, and your settings were three VerticalLayouts — anonymous
    flex divs whose only jobs were to hold a heading next to its content and to
    switch their own padding off. They are <section> elements now, which is what
    they were all along: the page's outline, said where a document says such things.
    Vaadin's Section is the plain element with none of a layout's configuration to
    undo, and the heading is the SectionHeading the page already had.
    What a bare element does not carry is spacing, so the rhythm between a heading
    and what it heads moves to the stylesheet: one rule giving a section the
    column-and-gap that each region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
2026-08-20 The width needs no call: a VerticalLayout is born full width
    Three views still said setWidthFull() next to their setMinHeight("100%") — a
    leftover from taking setSizeFull() apart, kept without asking whether each half
    earned its place. The height floor did; the width restated the constructor.
    The same look through what remained found HeatSumCounterForm: a VerticalLayout
    with its padding, its spacing and even that default width all overridden —
    three lines of configuration to arrive at a plain block. It is a Div.
    The setWidthFull() calls that survive are on Cards, on the sparkline and on
    FlexLayouts, none of which has a default width to restate.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
2026-08-20 Buttons become classes with names, not variables with settings
    Started by hand in HeatSumCounterForm: the stop button turned from a local
    variable and three setter lines into a StopButton whose constructor is its
    whole description, and the counter starter's plain save button gained its
    structure from an initializer block instead of a name-and-configure sequence.
    The same shape existed three more times and gets the same treatment. The device
    card's trash can is a RemoveButton, the sensor card's cog a SettingsButton, and
    pi-reader's pencil a RenameButton — each a VButton (or PopoverButton) subclass
    whose constructor holds the icon, the variants, the aria label and the click,
    with the add-si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
2026-08-20 Name the stack that is not a page, and give the counters their elbow room
    Six places said VerticalLayout and then setPadding(false), each meaning the same
    thing: a stack inside something, not a page — the padding a VerticalLayout is
    born with assumes it has a view to itself. The idiom is a class now, Column,
    whose javadoc also draws the line against its neighbours: a Div is for lines of
    one thing that stack tight, a Column for things of their own with the theme's
    gap between them, and distance from siblings is a margin that belongs to
    whoever needs the elbow room.
    The degree-day counters are the one that needed it. Their rows had been turned
    into tight Divs in a working-tree experiment th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
    [SensorCard.java]
2026-08-20 Let the gauge draw its own absence
    A sensor with no temperature yet is an ordinary state, and the cards drew it
    themselves: hide the gauge, show a text dash in its place, put the dial back
    when a reading arrives — a visibility dance in two applications, with the card
    jumping as the media slot emptied and refilled.
    The gauge does it now. The add-on grew setValue(Double) with null as "no
    reading" — a checkout in ./gauge-addon, branch empty-value, built locally as
    1.0.1-SNAPSHOT the same way the other two local add-on builds are — and an
    empty gauge keeps its dial: nothing reached, the pointer hidden, a dash with
    the unit still beside it, so the dial goes on saying what it would measure.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
2026-08-20 Let the theme stop repairing the gauge
    Both modules move to the gauge's 1.2.0-SNAPSHOT — built from ./gauge-addon's
    main until the release, like the note in each pom says — and the application
    sheds everything it had written around the old one.
    The theme file loses five of its six gauge rules: the transparent-background
    fight, the currentColor-with-!important on the reading and the range labels,
    the overflow rescue for the sliced labels and the display:block all ship with
    the component now, whose dial follows the page's own colours. What remains is
    taste — the width cap with its margins, the tick lines' opacity, and the wash
    on the unreached arc — and the section's warning about che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
2026-08-20 Photograph the application it has become
    The screenshot in the README predated everything the theme work did:
    the sunset-glass surfaces, the animal motifs behind the dials, the
    muted cold-to-hot ramp on the stock gauge, the sectioned settings
    popover. A reader comparing the picture with a fresh checkout saw two
    different applications.
    Retaken with the same story as before — a hanging shed at 6.2 °C with
    its bands and a hirvi counter two days in, a second sensor on the
    stock gauge — so the caption still describes what the picture shows,
    down to the counter reading, which moved from 11.1 to 11.0.
2026-08-21 Give the sub-views a way home, a name, and a face
    The views below the front page now share one shape: NavigationView,
    carrying SubViewHeader — the way back in a circle of Aura's own glass,
    the title bare in the middle as iOS writes it, the view's actions at
    the far edge — plus the min-height fix, inherited instead of repeated.
    The bar floats on a veil of blur that dissolves rather than ends, and
    its sticky offset counts the safe area, so an installed PWA no longer
    parks the arrow under the Dynamic Island. The name is TouchKit's,
    which took it from the iOS of its day; both are Viritin candidates,
    and the memo says so.
    The pencil in that header opens a device's settings: a name, because
    "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
2026-08-21 The devices sit for their portraits
    The line-drawn icons grew into featured images: four public-domain
    paintings of Finnish buildings — Järnefelt's smoke sauna, Holmberg's
    barn by a lake bay, Gallen-Kallela's Ekola croft, Munsterhjelm's
    farmhouse under winter clouds — cropped widescreen and worn by the
    front page cards edge to edge, the card's own COVER_MEDIA doing the
    cropping. Licences checked through the Commons API like the motifs
    before them; unlike the motifs they ship as themselves, because a
    featured image is content, not the background of a dial.
    The settings screen picks them as what they are: tiles of the
    pictures, a ring on the chosen one, the radio dots gone — next to a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
2026-08-21 The generic layouts move out; the memo says so
    Column, NavigationView and SubViewHeader now come from Viritin
    (org.vaadin.firitin.layouts, 3.8.1-SNAPSHOT — built locally from
    ../flow-viritin, like the form additions before them), and the copies
    this application grew them in are gone: three classes and a
    stylesheet, replaced by imports. pi-reader rides the same snapshot so
    the two UIs keep sharing one library, though it has nothing of its
    own to hand over — its one view is a front page with no way back to
    carry.
2026-08-21 Viritin 3.8.1 is out; the snapshot era ends
    Both applications now depend on the release. The pom comments about
    building ../flow-viritin locally go with it — the form additions and
    the layouts this project grew are in the published library, and the
    checkout is only for developing the next ones.
2026-08-21 Photograph it again, glass and all
    The same scene as before — a device's sensor cards with one sensor's
    settings open, bands on the gauge, a degree-day counter running — but
    the application in it has moved on: the way back and the pencil float
    on glass where a link and a heading used to sit.
2026-08-25 Teach the database to forget
    Before anyone is invited in, the janitor: a nightly sweep with three
    independent, configurable ages (sensorhub.retention.*, a year each by
    default, cron movable or disableable with \"-\").
    Browsers first. There are no accounts, so client_activity now records
    when each token was last seen on the pages — receiving notifications
    deliberately does not count, because a phone that only receives is
    exactly the case where nobody is looking. A token past its retention
    loses its list, its push subscriptions and its alert choices.
    Devices next, judged before old samples go, because staleness is read
    from the very measurements the purge is about to remove. A device
    silen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
2026-08-25 Let the reader look away from a sensor
    Both UIs can now ignore a sensor: the neighbour's tag that the radio
    hears as eagerly as its owner's does, the probe brought in for the
    winter. The settings form's delete button is harnessed for it —
    Viritin's DeleteButton, whose built-in confirmation stands between
    the button and the act, because a vanishing card looks like data loss
    until the dialog has said otherwise. And it is not data loss:
    measurements keep arriving and keep being stored, so Restore brings
    the sensor back with everything it gathered out of sight.
    The hidden card waits under an "Ignored sensors" list below the
    cards — an inventory rather than content, but findable by scrolling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
2026-08-26 Hear what the Ruuvi Air has to say about the air
    The pi-reader now decodes Ruuvi data format 6, the legacy-size
    advertisement a Ruuvi Air broadcasts: temperature, humidity and
    pressure like any tag, and then the part no tag has — PM2.5, CO2, the
    VOC and NOx indices, luminosity, sound. The scalings and the test
    vectors are Ruuvi's own, from the very ruuvi.endpoints.c the firmware
    encodes with, including the 9-bit fields whose ninth bits hide in the
    flags byte and the logarithmic lux.
    The Reading interface earns its keep: an AirReading slots into the
    registry, the history, the cards and the upstream packet untouched,
    so the Air's temperature and humidity reach the server today under
    the sam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
2026-08-26 The Pico hears the Ruuvi Air too
    The same data format 6 the pi-reader learned, now in the Pico sketch:
    a Ruuvi Air's temperature and humidity travel to the server exactly
    like a tag's, under the identifier the same twelve-bit rule derives —
    so the same device heard by both readers files as one sensor. CO2 and
    PM2.5 are decoded for the serial log, where they are the reason to
    point an antenna at the device at all; the packet has no room for
    them, and protocol-evolution.md says what it would take.
    The format's one wrinkle here is the address: a legacy advertisement
    carries only its low three bytes, so the registry keys the Air with
    zeros in front, and a name in RUUVI_NAMES is entered the sa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
2026-09-13 Stop the last resort from disarming itself
    A device that had been sending for weeks was found reading NO MODEM,
    never sent, and had been there long enough that nothing was going to
    change. The reason it stayed there is that rebootIfHopeless() only
    restarted a device that had sent something successfully at least once,
    and the flag it consulted lived in RAM — so the reboot it authorised
    also cleared it. One failed first send after that reboot and the last
    resort was off for good. The display said so in as many words. Uptime
    replaces the flag: half an hour between restarts protects the serial
    log the old rule was reaching for, without handing the device a way to
    switch itself off.
    Three faul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
    [Transport.h, temperature-reader.ino]
2026-09-15 Hand over a device without the toolchain
    A Pico takes firmware by drag and drop: hold BOOTSEL while plugging in
    the cable and the bootloader appears as a USB drive that accepts a .uf2
    and flashes itself. Somebody receiving a built device therefore needs no
    IDE, no drivers and nothing installed — one file and six numbered steps,
    which the README now carries in a form that can be pasted into a message
    as it stands. The drive is called RP2350 on a Pico 2, not the RPI-RP2 of
    the older board, and confusing the two is exactly what makes a person
    think nothing happened.
    The building half is written down too, for the Arduino IDE and for
    arduino-cli, where the FQBN needs ipbtstack=ipv4btcble spell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
2026-09-15 Put the compiler behind a form
    A page at /firmware, linked from under "Add a device": somebody fills in
    their WiFi network, waits, and downloads a .uf2 built from the current
    source and configured for them. No toolchain on their computer, and no
    building one per recipient by hand. Which is what the README's "Handing a
    built firmware to somebody else" had just finished describing, and this
    is the answer to it.
    The server takes a WiFi password from a text field and puts it into a
    file a compiler reads, so the one thing worth reviewing is ConfigHeader.
    It does not build source text. Every value goes in as its bytes —
    { 0x68, 0x75, ... } and never "hunter22" — which means there is no syntax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
2026-09-15 Say which board the build page builds for
    The firmware is compiled for one target, and the page said nothing about
    which. Somebody holding an original Pico W would have found out from a
    file that copies onto the drive and then does nothing at all — the RP2040
    bootloader takes an RP2350 image without complaint and simply stays in
    BOOTSEL, which reads as "the file was broken" rather than "the file was
    for another chip".
    So the page says it above the form, where it is read while their hands
    are still free. Worded as what the thing is for rather than as what it
    does not do: "Only supports X" reads as an apology for a missing feature,
    and this is not one.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
2026-09-15 Give the packet room for what it was not born with
    A Ruuvi Air measures carbon dioxide and particulates, and until now the
    Pico heard both and had nowhere to put them: protocol v1's sensor record
    was a fixed eight bytes with a temperature and a humidity in it and not
    one byte spare. So they stopped at the serial log while the temperature
    in the same advertisement went to the server. protocol-evolution.md
    worked through the alternatives a year's worth of ago and recommended
    type-length-value per sensor, and this is that, end to end.
    A sensor record is now an identifier, a field count, and three bytes per
    field: a type and a 16-bit value. Two things follow that are worth
    knowing, because both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
    [Protocol.h]
2026-09-15 Give the firmware page its way back
    It was a page with no exit. Somebody arriving from "Add a device", reading
    which board it builds for and deciding it is not their errand had the
    browser's own back button and nothing else — and a reader who got that far
    by following a link inside the application has no reason to expect to
    leave it by leaving the application.
    So it is a NavigationView now, like the device and settings views, with
    the same arrow to the same place and "Devices" as its accessible name:
    the destination has to be said, but not shown. The bar names the view, so
    the form's own heading went with it — a section that is the whole view
    does not need naming twice.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
2026-09-15 Give a new device a picture to arrive with
    A device added with no image got a card with an empty media slot, and the
    first visit is exactly when there is nothing else on the page to look at —
    one blank card and a heading. The paintings are bundled and free, so there
    was no reason for the first impression to be the unfinished one.
    Chosen by what the reader's other devices already show rather than at
    random. Random puts the same barn on two of the first three cards often
    enough to read as a bug, which is the opposite of what this is for; least
    used means the first four devices are four different buildings and the
    fifth starts again. Ties go to declaration order, so the choice is
    predictable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
2026-09-17 Take the Viritin that stops the device view scrolling sideways
    NavigationView on Viritin's main clips its horizontal overflow, which is
    what removes the stray scrollbar and the doubled right margin the header's
    veil gave the device and settings views. A snapshot again until 3.8.2 is
    released, built locally like the gauge addon.
2026-09-17 Bring the ESP32 up to the Pico's level, and flash it from the browser
    The ESP32-S3 sketch now hears a Ruuvi Air as well as the tags, reports
    the chip's own temperature as CPU, names its failures in the Pico's words,
    restarts itself after six failed sends and stands behind a hardware
    watchdog. Nothing wired to the board, on purpose: the parity is in
    everything that is not hardware. ProtocolSyncTest checks the Data Format 6
    decoding between the two sketches too.
    The firmware page builds for both boards. A Board enum carries the
    differences — sketch, core, FQBN, image — and arduino-cli is checked for
    each core, so a server offers the boards it can build for. The ESP32's
    image is the core's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
2026-09-17 Ask for the port inside the click, and keep the file until the page is left
    Chrome shows its serial port dialog only while it is handling a user
    gesture, and a click that has gone to the server and come back is not one
    any more: the button went grey, a bar appeared, and no dialog came. The
    script now listens for the click itself, asks for the port first thing,
    and tells the server afterwards. Both sides log what happens, so the next
    silence has a trail.
    The download link used to delete the image the moment it had been read,
    which put a stack trace in the log on the second click and would have
    left the flasher nothing to fetch. The file now lives as long as the view
    does — released on deta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
2026-09-17 Let the flasher's image link reach the browser, and say when the script arrives
    The hidden anchor the script fetches the image from was hidden with
    setVisible(false), and Vaadin withholds an invisible element's attributes
    until it is shown — href included. The script would have fetched the page
    itself. display:none keeps it out of sight and lets the address through.
    The module announces itself on load and the server logs whether the
    browser has Web Serial and whether the button was armed, so a silent
    console can be told apart from a script that never came.
2026-09-17 Give the test database room for every context's pool
    Spring caches one context per distinct test configuration and each keeps
    a Hikari pool of ten. This module has eleven, and PostgreSQL's default
    hundred connections shut the door on the last one: ClientDeviceStoreTest
    failed with "too many clients already" through no fault of its own. The
    test container now allows three hundred.
2026-09-17 Offer the freshly built device a place on the list
    A device appears nowhere on its own, and the moment somebody has just
    built and flashed one is the moment they have its identifier in front of
    them. So the build page now ends with a button — "Add XXXX to my devices",
    or "Open XXXX" for one already listed — that does what the front page's
    form does, picture included, and opens the device's own page where the
    first packet will land. Shown for both boards, after the file or the
    flasher.
2026-09-17 Let the ESP32 rest between sends
    The board ran hot, and the radios were why: scanning for advertisements
    without pause, holding a WiFi association, and a CPU at 240 MHz for work
    that is parsing a few dozen bytes and waiting. A device reporting every
    five minutes needs none of that for more than a fraction of the time.
    The firmware now works in cycles. It listens for twenty seconds, which
    hears every tag in range many times over, sends, switches both radios off
    and rests for what is left of the interval. The CPU runs at 80 MHz, the
    least the radios accept. Awake by default, so the light and the serial
    console keep working; LIGHT_SLEEP_BETWEEN_SENDS in config.h halts the CPU
    between cycles fo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
2026-09-17 Say before the build which browsers can flash an ESP32-S3
    The flasher already explains itself once the build is ready, but a reader
    on Safari or a phone should hear that this board is written from the
    browser, and from which browsers, while they can still switch — not after
    waiting for a compile. The note sits under the board hint and shows only
    for boards that take their firmware over the serial port.
2026-09-17 The ESP32 firmware learns the C3, and the sketch takes the chip's name
    The ESP32-C3 is the cheaper board and the same job: one Arduino core,
    the same NimBLE, WiFi, watchdog and RGB LED call. The sketch could not
    tell the two apart if it tried, so it does not — one directory, now
    esp32-reader, serves both, and the one line that differs, the LED's pin,
    picks itself by the compiler's target in config.h.
    On the server the C3 is a third Board: the C3 spelling of the same three
    FQBN options, its own build directory so alternating with the S3 does not
    throw the object files away, and its chip name for the flasher to check
    against before writing — the script now takes the expected chip from the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
2026-09-17 Let the light rest too, and offer the sleep from the build page
    The rest between sends is where the remaining warmth is, and two things
    stay awake through it: the chip, and the light telling an empty room.
    STATUS_LED_WHILE_RESTING in config.h now lets the light go dark between
    cycles — it still blinks while listening and around the send, so every
    outcome is shown — with an honest note that this saves a couple of
    milliamps where light sleep saves twenty.
    Light sleep is the lever that matters, and a firmware built from the page
    could not reach it: the page used the template's default. It now asks,
    "Sleep between sends", for the boards that offer it, and the config
    generator flips the defi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
    [esp32-reader.ino]
2026-09-17 Let a counter run past its target, and say so where it cannot be missed
    The sum always kept climbing — the meat hangs until somebody takes it
    down, and the number they want then is the one it got to — but the card
    said "Ready" and clamped the bar, and a sum that moved since yesterday
    under a word like that reads as a contradiction. Now a reached target is a
    green badge naming the overshoot, a bar turned green, and a line saying
    the counter is still counting and where to stop it.
2026-09-17 Give Start a button's face, and put the counters after Save
    Start was tertiary — a link dressed as a button — and next to two fields
    it read as a label. It is an ordinary button now; the accent stays with
    the settings form's Save, which is the popover's verdict.
    The counters sat between the alert choices and the button row, so Save
    and Ignore appeared to close a section they had nothing to do with: a
    counter saves itself as it is changed, and Start begins one on the spot.
    They come after the buttons now, below a rule, with a line saying so.
2026-09-17 Show iPhone users the way to a notification, picture by picture
    Web push on an iPhone works only for a site added to the Home Screen, and
    Apple has hidden the adding three taps deep in a menu that opens with
    people to share the page with. Nothing on a page can offer it. So the
    guide takes the whole path with screenshots and the button to tap circled
    on each: the Safari menu, Share, View More, Add to Home Screen — then, in
    the installed app, the notification switch, the sensor's cog, Start on a
    counter, its two alerts, and the forecast on the card.
    Android users are pointed past the Apple half; the in-app half is theirs
    as it stands. The raw screenshots stay out of the repository; the guid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
2026-09-17 Fill in the guide's two missing moments
    The confirmation dialog, with Add circled and the Open as Web App switch
    marked; the installed app opening empty, which is where the separate
    memory is easiest to explain; and the one question iOS asks, with Allow
    circled. Steps renumbered to eleven, the badges with them.
2026-09-17 Let a tag's battery travel to the server, and show it under the readings
    A RuuviTag says how much is left in its coin cell in every advertisement,
    and both readers decoded it for their serial logs and then dropped it. A
    dying tag became visible as silence, one day, when its card stopped
    moving. The packet now has a field for it — type 8, millivolts, in all
    three copies of Protocol.h — and the Pico, the ESP32 and the pi-reader
    send it. The server keeps it (V13) and the card shows it under the
    humidity, with a word when it drops below the point Ruuvi's own app warns
    at. A Ruuvi Air runs off the mains and sends none, and gets no line.
    Found on the way: findLatest rebuilt readings with the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
2026-09-18 Give each reading its own line, and a switch onto the curve
    "801 ppm CO2 · 0.5 ug/m3 PM2.5" read as one measurement with a strange
    unit. The readings under the curve are rows now, one each — humidity,
    CO2, PM2.5, battery — shown only for a sensor that has the value, and each
    carries a small chart icon that lays it over the temperature as a second
    line in its own colour. The row wears that colour while the line is on,
    so it is the legend.
    The overlays are stretched to the temperature's scale: the component
    gives every series one y axis, and 800 ppm on a 10 °C axis would flatten
    the temperature to nothing. The shape survives, which is what an overlay
    is for; the numbers are on the line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
2026-09-18 Guess what is left in the tag's battery, the way Ruuvi would if they dared
    Ruuvi's firmware notes describe the CR2477's curve — a little over 3.0 V
    new, months sliding to 2.7, then a cliff — and conclude that the end
    cannot be predicted from the voltage, so their app shows a voltage and a
    "low" and no percentage. The card now shows one anyway, because "about
    25 %" answers the reader's question better than 2.71 V does: linear
    between six anchors taken from those notes, rounded to fives so it does
    not pretend to precision.
    Cold reads low without being empty. Ruuvi Station moves its low line
    with the tag's temperature — 2.5 V above freezing, 2.3 down to −20, 2.0
    below — and the guess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
2026-09-18 Vaadin 25.3, a table for the readings, and a battery drawn as a battery
    25.3.0-rc1 brings a real Table, and the readings under the curve become
    one: a name, a value and the chart switch on every row, so the values line
    up and the table reads down the way a table does — "801 ppm CO2" and
    "0.5 ug/m3 PM2.5" one under the other had the eye hunting for the name at
    the end of each line.
    The battery row gets a battery: BatteryLevel, a generic component drawn
    with Viritin's SVG elements — outline, nub, and a bar exactly as long as
    the charge, red under twenty per cent. It knows a percentage and a
    threshold and nothing about coin cells, so it can stand next to any
    number that is a fraction of so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
2026-09-18 Send the rest of what a Ruuvi measures: pressure, the indexes, the light
    Ruuvi's app lists seven numbers for an Air and the card showed four. The
    missing three had field types reserved since version 2 — pressure, the
    VOC index, the NOx index — decoded by some readers and sent by none; the
    light had no type and takes 9. All three readers send them now, the
    server keeps them (V14) and the card lists them: pressure to two decimals
    as Ruuvi shows it, the indexes as the bare 0–500 numbers they are, the
    light in whole lux. Pressure comes from every RuuviTag too.
    The nine-bit indexes keep their ninth bit in the flags byte, the light
    rides a logarithmic byte, and both sketches now say so in t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
2026-09-18 Sleep deeply between sends, since light sleep left the radio for dead
    With "Sleep between sends" on, the ESP32 reported once and never again.
    Espressif's sleep documentation says why: light sleep powers the radios
    down, and a BLE controller that was simply left initialised is not
    brought back usable — that only works on the modem-sleep and automatic
    light-sleep path, which the Arduino core does not set up. The scan
    restarted into nothing and WiFi stayed down.
    Deep sleep instead: the timer wakes the chip into setup(), every cycle
    is a fresh boot, and nothing has to be resumed. Only the sequence number
    is carried across, in RTC memory, so the server does not read every wake
    as a reboot. The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
    [esp32-reader.ino]
